I-Grebot/elec_microboard/doc/module_drv8843_pcb.PNG

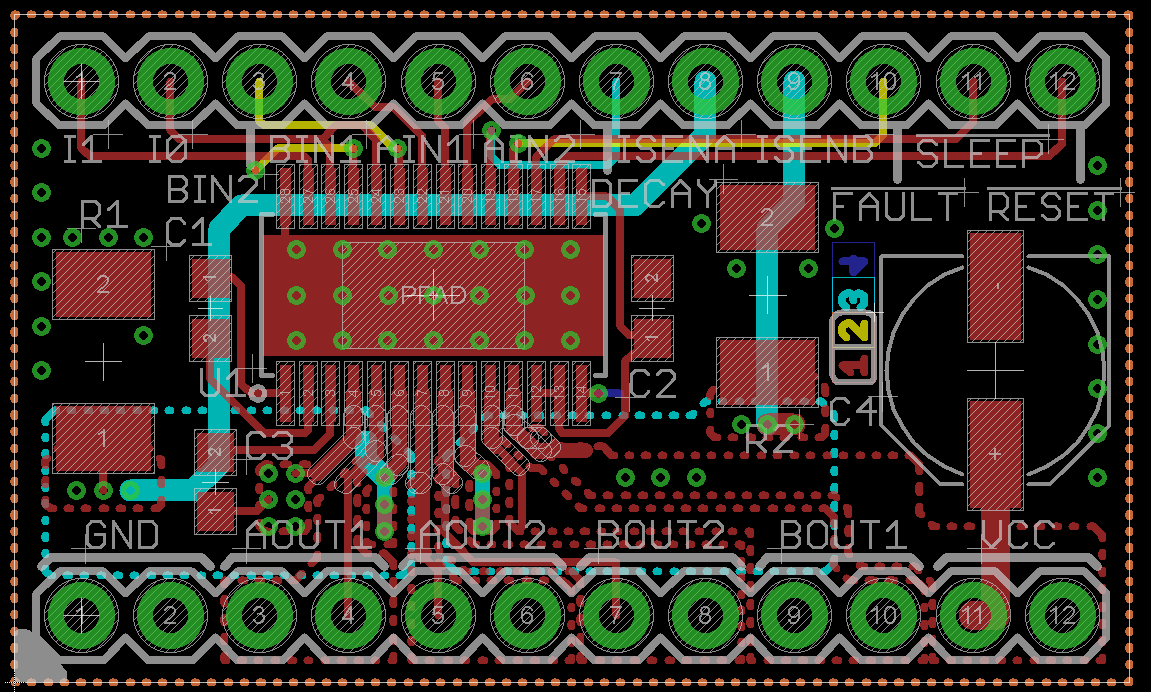
doc/module_drv8843_pcb.PNG
