I-Grebot/elec_microboard/doc/module_drv8843_schema.PNG

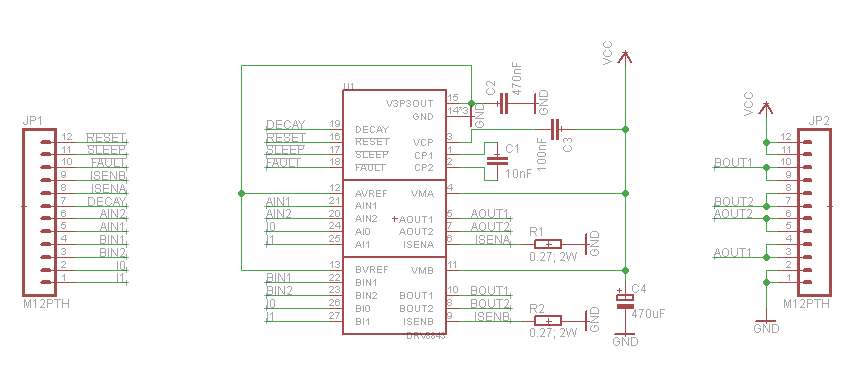
doc/module_drv8843_schema.PNG
