I-Grebot/elec_microboard/doc/power.png

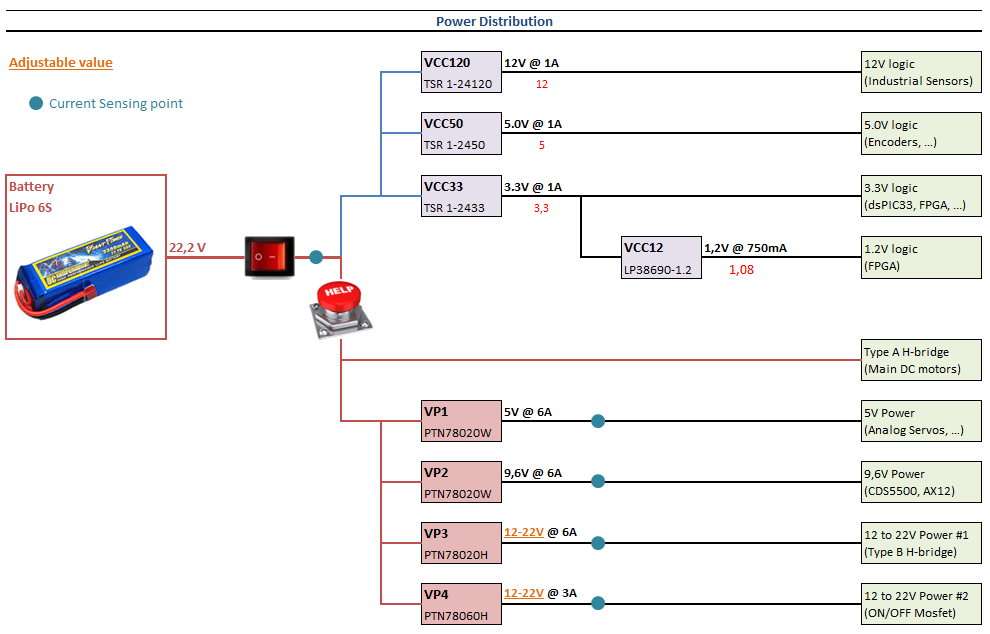
doc/power.png
