I-Grebot/elec_microboard/doc/power_pcb.PNG

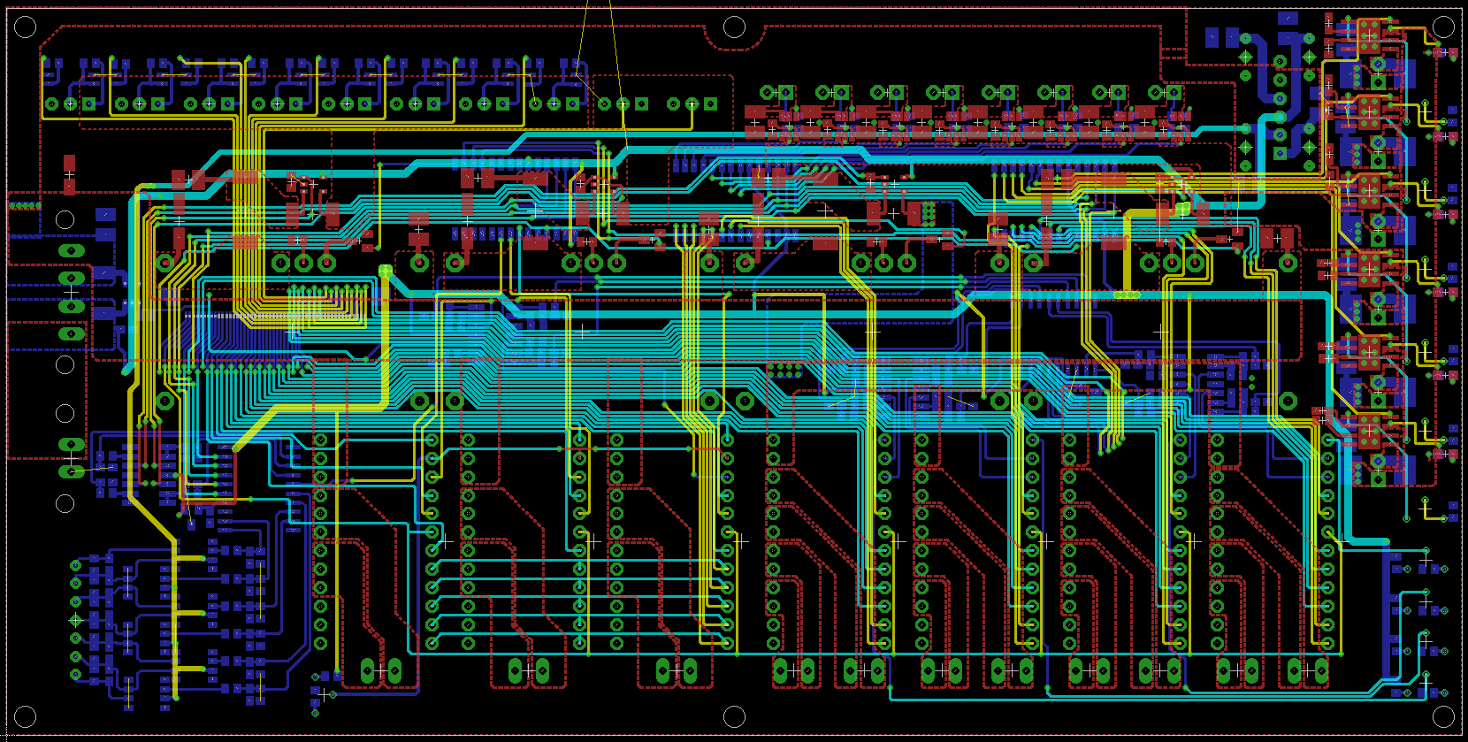
doc/power_pcb.PNG
