I-Grebot/elec_microboard/gerbers/microBoard_HMI/microBoard_HMI_back_side.png

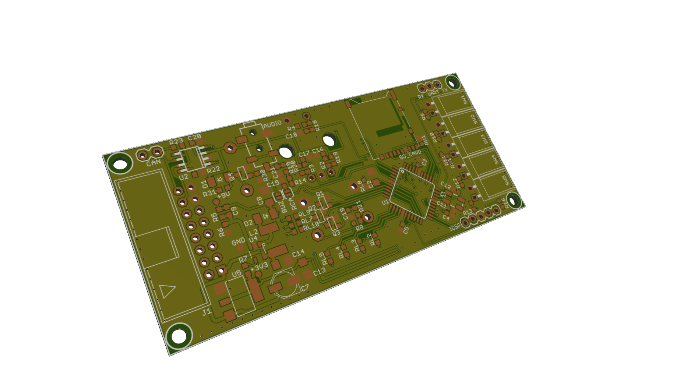
gerbers/microBoard_HMI/microBoard_HMI_back_side.png
