I-Grebot/elec_microboard/bom/microBoard_DRV8843.xlsx

Qty | Value | Device | Package | Parts | Description | Cmd
2 | 0.27; 2W | R-EU_R2010 | R2010 | R1, R2 | RESISTOR, European symbol | X
1 | 100nF | C-EUC0603 | C0603 | C3 | CAPACITOR, European symbol | X
1 | 10nF | C-EUC0603 | C0603 | C1 | CAPACITOR, European symbol | X
1 | 470nF | C-EUC0603 | C0603 | C2 | CAPACITOR, European symbol | X
1 | 470uF | CPOL-EUD | PANASONIC_D | C4 | POLARIZED CAPACITOR, European symbol | X
1 | DRV8843 | DRV8843 | PWP_28 | U1 |  | X
2 | M12PTH | M12PTH | 1X12 | JP1, JP2 | Header 12 | X
