I-Grebot/elec_microboard/bom/microBoard_HMI_bom.xls

microBoard_HMI |  |  |  |  |  |  | Last Update: | 2014-11-01
Bill Of Materials |  |  |  |  | Price for 1 board = 47,25€ |  | No. Boards | 2
Device | Value | Package | Part list | Count | Description | Farnell Ref. | Price (net) | Total (net)
C-EUC1206 | 4.7uF | C1206 | C1, C8 | 2 | CAPACITOR, European symbol | 2320886 | 0.17 € | 0.33 €
C-EUC1206 | 10uF | C1206 | C2, C13, C14 | 3 | CAPACITOR, European symbol | 2218910 | 0.27 € | 0.81 €
C-EUC0603 | 100nF | C0603 | C3, C4, C5, C6, C10, C20 | 6 | CAPACITOR, European symbol | 1759016 | 0.01 € | 0.04 €
CPOL-EUC | 10uF | PANASONIC_C | C7 | 1 | POLARIZED CAPACITOR, European symbol | 9697012 | 0.15 € | 0.15 € | Stock parts
C-EUC0603 | 10pF | C0603 | C9 | 1 | CAPACITOR, European symbol | 2332633 | 0.09 € | 0.09 € | Sample parts
C-EUC0603 | 18pF | C0603 | C11, C12 | 2 | CAPACITOR, European symbol | 1759056 | 0.01 € | 0.02 € | Not available
C-EUC0603 | 220nF | C0603 | C15 | 1 | CAPACITOR, European symbol | 2346897 | 0.04 € | 0.04 € | To buy
C-EUC0603 | 10nF | C0603 | C16, C17, C18, C19 | 4 | CAPACITOR, European symbol | 1759022 | 0.01 € | 0.03 €
C-EUC0603 | 22nF | C0603 | C21 | 1 | CAPACITOR, European symbol | 1759027 | 0.01 € | 0.01 €
CGRM4001-G | MBR0530 | SOD-123_MINI-SMA | D1, D2 | 2 | Molded plasitc,JEDEC SOD-123/Mini SMA | 1843690 | 0.06 € | 0.13 €
HE10_H_16 | HE10_H_16 | CON_2X_2.54_H_16 | J1 | 1 | HE-10 16 ways horizontal | 2215293 | 0.84 € | 0.84 €
M05LOCK |  | 1X05_LOCK | J5 | 1 | ICSP Connector |  | 0.00 € | 0.00 €
AUDIO-JACK1:1 |  | STEREOJACK2.5MM | J6 | 1 | 2.5mm Audio Jack |  | 0.00 € | 0.00 €
M03LOCK |  | 1X03_LOCK | J8 | 1 | UART Connector |  | 0.00 € | 0.00 €
JUMPER-2PTH_LOCK |  | 1X02_LOCK | JP3 | 1 | CAN Last node jumper |  | 0.00 € | 0.00 €
L-EUL5650M | 10uH | L5650M | L1 | 1 | INDUCTOR, European symbol | 2062754 | 0.75 € | 0.75 €
LEDCHIP-LED0805 |  | CHIP-LED0805 | LED6 | 1 | OLED on/off green LED | 2290331 | 0.10 € | 0.10 €
LEDCHIP-LED0805 |  | CHIP-LED0805 | LED1 | 1 | SD Card Yellow LED | 1686073 | 0.17 € | 0.17 €
LEDCHIP-LED0805 |  | CHIP-LED0805 | LED2, LED3 | 2 | 2x misc blue LEDs | 2217974 | 0.17 € | 0.33 €
LEDCHIP-LED0805 |  | CHIP-LED0805 | LED4, LED5 | 2 | 2x misc red LEDs | 2099241 | 0.11 € | 0.21 €
GM5WA94310A | YTB2-0BB02 | GM5WA94310A | LED7 | 1 | Chip LED RGB | 1863243 | 1.61 € | 1.61 €
EC11E1534408 | EC11E1534408 | EC11E1534408 | NAV1 | 1 | Rotary encoder with integrated SPST | 2064992 | 2.06 € | 2.06 €
TAC_SW_IP40 | TAC_SW_IP40 | TAC_SW_IP40 | NAV2 | 1 | SPST tactile switch | 1217754 | 1.41 € | 1.41 €
BSS138 | BSS138 | SOT23 | Q1, Q2, Q3, Q4 | 4 | Common NMOSFET Parts | 9845330 | 0.20 € | 0.79 €
R-EU_R0603 | 100 | R0603 | R14, R33, R34 | 3 | RESISTOR, European symbol | 2331713 | 0.01 € | 0.03 €
R-EU_R0603 | 120 | R0603 | R23 | 1 | RESISTOR, European symbol | 2331714 | 0.01 € | 0.01 €
R-EU_R0603 | 150 | R0603 | R17 | 1 | RESISTOR, European symbol | 2331715 | 0.01 € | 0.01 €
R-EU_R0603 | 270 | R0603 | R24, R26, R27, R28, R29, R32 | 6 | RESISTOR, European symbol | 2331719 | 0.01 € | 0.05 €
R-EU_R0603 | 1k | R0603 | R15, R31 | 2 | RESISTOR, European symbol | 2331727 | 0.01 € | 0.02 €
R-EU_R0603 | 4.7k | R0603 | R16 | 1 | RESISTOR, European symbol | 2331736 | 0.01 € | 0.01 €
R-EU_R0603 | 10k | R0603 | R2, R3, R4, R7, R8, R9, R10, R11, R12, R13, R18, R19, R20, R21, R22, R25 | 16 | RESISTOR, European symbol | 9238603 | 0.01 € | 0.10 €
R-EU_R0603 | 160k 1% | R0603 | R6 | 1 | RESISTOR, European symbol | 1627809 | 0.04 € | 0.04 €
R-EU_R0603 | 560k | R0603 | R1 | 1 | RESISTOR, European symbol | 2331763 | 0.01 € | 0.01 €
R-EU_R0603 | 1M 1% | R0603 | R5, R30 | 2 | RESISTOR, European symbol | 2332042 | 0.01 € | 0.02 €
DM3AT-SF-PEJM5 | DM3AT-SF-PEJM5 | DM3AT | SD_CARD | 1 | micro SD Card slot | 1764374 | 2.52 € | 2.52 €
F/EE17P | PKM17EPPH4001 | F/EE17P | SG1 | 1 | 17mm Sounder | 1192517 | 1.26 € | 1.26 €
HE14_H_2 | HE14_H_2 | HE14_H_2 | SW1, SW2, SW3, SW4, SW5 | 5 | 2 Ways HE-14 horizontal connector | 1360142 | 0.46 € | 2.29 €
DSPIC33EP512GM604 | DSPIC33EP512GM604 | TQFP_44 | U1 | 1 | dsPIC33EPXXXGM604 TQFP-44 Microcontroller | 2353895 | 0.00 € | 0.00 €
MCP2551 | SN65HVD230D | SO-08 | U2 | 1 | High-Speed CAN Transceiver | 1103105 | 0.00 € | 0.00 €
DD-12864WE-4A | DD-12864WE-4A | DD-12864WE-4A | U3 | 1 | Densitron 128x64 0.96" OLED Display | 1829709 | 21.64 € | 21.64 €
TPS61040 | TPS61040 | SOT-23 | U4 | 1 | Low power DC/DC Boost Converter | 1461061 | 0.00 € | 0.00 €
NX1117C | TLV1117-33 | SOT_223 | U5 | 1 | Standard 3.3V 800mA Low dropout linear regulator | 1202826 | 0.54 € | 0.54 €
CRYSTAL5X3 | 16MHz | CRYSTAL-SMD-5X3 | X1 | 1 | 4 Pads SMD 5 x 3.2 mm Crystal | 1841977 | 0.91 € | 0.91 €
 |  |  |  |  |  |  | Price per board (net) | 39.38 €
 |  |  |  |  |  |  | Price per board (+VAT) | 47.25 €
 |  |  |  |  |  |  | Grand Total | 94.50 €
