I-Grebot/elec_microboard/doc/architecture.xlsx

Sheet: Specifications
System specifications
 | Supplies & Power-managment
 |  | 24Vdc input, 6s LiPo cells
 |  | 2 power domains: logic (+ sensors) and actuators
 |  | Cells voltage monitoring
 |  | Current monitoring: global + 1 per power-supply ("power" domain)
 |  | Independant power supplies enable
 | Actuators
 |  | 11 Full H-bridges (3 main 5A, 8 auxilliary 3A)
 |  | 6 ON/OFF power mosfet 5A
 |  | 8 analog servos
 |  | Digital servos interface
 | Sensors
 |  | 20 NPN/PNP industrial sensors inputs
 |  | 8 Endstops inputs
 |  | 12 encoder interfaces
 | User Interface
 |  | Main ON/OFF switch
 |  | Emergency switch + feedback (switch "power" domain off)
 |  | Start switch (or interface)
 |  | Team selection switch
 |  | 1 extra switch (strategy selection or other)
 |  | 128x64 OLED display (monochrome)
 |  | Encoder for menu browsing + with push-button
 |  | RGB LED
 |  | micro SD card interface
 |  | 1 LED per power-domain
 |  | Piezo beeper

Sheet: Architecture
Battery
LiPo - 6S

Sheet: Power-supplies
Battery |  |  |  |  | Power Distribution
Number of elements | 6
Element voltage range | 3.3 | 3.7 | 4.2 |  | Adjustable value |  |  | VCC120 | 12V @ 1A |  |  | 12V logic (Industrial Sensors)
Battery voltage range | 19.8 | 22.2 | 25.2 |  |  |  |  | TSR 1-24120 | 12
 |  |  |  |  |  | Current Sensing point
 |  |  |  |  |  |  |  | VCC50 | 5.0V @ 1A |  |  | 5.0V logic (Encoders, …)
Power modules |  |  |  |  |  |  |  | TSR 1-2450 | 5
Name | Amps rating
PTN78000 | 1.5 |  |  |  | Battery |  |  | VCC33 | 3.3V @ 1A |  |  | 3.3V logic (dsPIC33, FPGA, ...)
PTN78060 | 3.0 |  |  |  | LiPo 6S |  |  | TSR 1-2433 | 3.3
PTN78020 | 6.0
 |  |  |  |  |  |  | 22,2 V |  |  | VCC12 | 1,2V @ 750mA | 1.2V logic (FPGA)
Suffix | Vin range |  | Vout range |  |  |  |  |  |  | LP38690-1.2 | 1.08
'H' | 15.0 | 36.0 | 11.8 | 22.0
'W' | 7.0 | 36.0 | 2.5 | 12.6
Traco modules | Amps rating |  | Vin range |  |  |  |  |  |  |  |  | Type A H-bridge (Main DC motors)
TSR 1-24XX | 1.0 |  | 12.0 | 36.0
LDOs |  |  |  |  |  |  |  | VP1 | 5V @ 6A |  |  | 5V Power (Analog Servos, …)
Name | Amps rating |  | Vin range |  |  |  |  | PTN78020W
LP38690-5/3.3 | 1.0 |  | 2.7 | 10.0
 |  |  |  |  |  |  |  | VP2 | 9,6V @ 6A |  |  | 9,6V Power (CDS5500, AX12)
 |  |  |  |  |  |  |  | PTN78020W
 |  |  |  |  |  |  |  | VP3 | 12-22V @ 6A |  |  | 12 to 22V Power #1 (Type B H-bridge)
 |  |  |  |  |  |  |  | PTN78020H
 |  |  |  |  |  |  |  | VP4 | 12-22V @ 3A |  |  | 12 to 22V Power #2 (ON/OFF Mosfet)
 |  |  |  |  |  |  |  | PTN78060H

Sheet: Devices
Device ID | Type | I/O Type | Count
1 | dsPIC33EP*MU814 | Input / Output | 122
2 | XC3S200A | Input only | 8
 |  | Input / Output | 53
3 | dsPIC33EP*GM604 | Input / Output | 35
Total available I/O |  |  | 218

Sheet: IO Resources
 |  |  |  | Required I/O |  | Mapping per device |  |  |  |  |  |  | Schematic Status
Resource | Count | Details | Peripheral per item | Per item | Total | µC Main |  | FPGA Main |  | µc HMI
Cells voltage monitoring | 6 | 1 ADC channel per LiPo cell | 1 ADC channel | 1 | 6 | 6 | 6 |  | 0 |  | 0 | 0
Current sensing | 6 | 1 ADC channel per shunt sensing | 1 ADC channel | 1 | 6 | 6 | 6 |  | 0 |  | 0 | 0
Power supply enable | 4 | 1 ENABLE output | 1 digital output | 1 | 4 | 4 | 4 |  | 0 |  | 0 | 0 | OK
Type A Full H-bridges | 3 | 1 PWM signal 1 DIR signal 1 DECAY signal 1 SLEEP signal 1 FAULT signal 1 SENSE Feedback | 1 PWM channel 4 digital outputs 1 ADC channel | 6 | 18 | 3 | 18 |  | 0 |  | 0 | 0 | OK
Type B Full H-bridges | 8 | 1 PWM signal 1 DIR signal 0,5 DECAY signal 0,5 SLEEP signal 0,5 FAULT signal 1 SENSE Feedback | 1 PWM channels 2.5 digital outputs 1 ADC channel | 4.5 | 36 | 4 | 18 | 4 | 18 |  | 0 | 0 | OK
Common for Full H-bridges | 1 | 1 RESET signal | 1 digital output | 1 | 1 | 1 | 1 |  | 0 |  | 0 | 0 | OK
ON/OFF power mosfets | 16 | 1 ENABLE signal | 1 digital output | 1 | 16 | 16 | 16 |  | 0 |  | 0 | 0 | OK
Analog servos | 8 | 1 PWM signal | 1 PWM channel | 1 | 8 |  | 0 | 8 | 8 |  | 0 | 0 | OK
Digital servos interface | 1 | 1 TX/RX signal 1 DIR signal | 1 UART input 1 UART output 1 digital output | 3 | 3 | 1 | 3 |  | 0 |  | 0 | 0
NPN/PNP Industrial sensors | 20 | 1 input signal | 1 digital input | 1 | 20 | 20 | 20 |  | 0 |  | 0 | 0
Endstops | 8 | 1 input signal | 1 digital input | 1 | 8 | 8 | 8 |  | 0 |  | 0 | 0
Encoders interface | 12 | 1 'A' channel 1 'B' channel 1 '0' channel | 1 QEI channel | 3 | 36 | 2 | 6 | 10 | 30 |  | 0 | 0
Emergency switch feedback | 1 | 1 input signal | 1 digital input | 1 | 1 |  | 0 |  | 0 | 1 | 1 | 0
Team selection switch | 1 | 1 input signal | 1 digital input | 1 | 1 |  | 0 |  | 0 | 1 | 1 | 0
Start switch or interface | 1 | 1 input signal | 1 digital input | 1 | 1 |  | 0 |  | 0 | 1 | 1 | 0
Spare switch (strategy) | 1 | 1 input signal | 1 digital input | 1 | 1 |  | 0 |  | 0 | 1 | 1 | 0
OLED Display | 1 | 1 CS signal 1 RESET signal 1 D/C signal 1 R/W signal 1 E/RD signal 8 D signals | 1 PMP interface 1 digital output | 13 | 13 |  | 0 |  | 0 | 1 | 13 | 0
OLED Intensity adjustment | 1 | 1 CS signal 1 MOSI signal 1 SCK signal | 1 SPI interface* 1 digital output | 3 | 3 |  | 0 |  | 0 | 1 | 3 | 0
Encoder for menu + Push button | 1 | 1 'A' channel 1 'B' channel 1 push-button input | 3 digital inputs | 3 | 3 |  | 0 |  | 0 | 1 | 3 | 0
RGB LED | 1 | 1 PWM output for Red intensity 1 PWM output for Green intensity 1 PWM output for Blue intensity | 3 PWM channels | 3 | 3 |  | 0 |  | 0 | 1 | 3 | 0
Micro SD interface | 1 | 1 SCK signal 1 MISO signal 1 MOSI signal 1 CS signal | 1 SPI interface* 1 digital output | 4 | 4 |  | 0 |  | 0 | 1 | 4 | 0
Piezo beeper | 1 | 1 PWM signal | 1 PWM channel | 1 | 1 |  | 0 |  | 0 | 1 | 1 | 0
Inter-uc / FPGA communication | 3 | 1 SCK signal 1 MISO signal 1 MOSI signal 1 CS signal | 1 SPI interface* 1 digital output | 4 | 12 | 1 | 4 | 1 | 4 | 1 | 4
Total |  |  |  |  | 193 |  | 110 |  | 60 |  | 35
Available |  |  |  |  | 218 |  | 122 |  | 61 |  | 35
* If multiple slave SPI devices are present, the 3 I/O from the SPI interface can be saved
(only the CS pins need to be duplicated)

Sheet: Components
 |  | Mémo
 |  | Potar numérique pour réglage DECAY moteurs, tension d'alim, brightness OLED
 |  | testpads
 |  | support pour les PTN pour pouvoir en changer
 |  | decouplage un peu partout
OLED 128x64 blanc | http://fr.farnell.com/densitron/dd-12864we-4a/pmoled-128-64-blanc/dp/1829709 | LEDs pour indicateur on/off mosfet et solenoids
Connecteur puiss x2 | http://fr.farnell.com/phoenix-contact/mc-1-5-2-gf-3-81-lr/embase-8a-160v-2-3-81mm-vert/dp/2393507
x4 | http://fr.farnell.com/phoenix-contact/mc-1-5-4-gf-3-81-lr/embase-8a-160v-4-3-81mm-vert/dp/2393509
x3 | http://fr.farnell.com/phoenix-contact/mc-1-5-3-gf-3-81-lr/embase-8a-160v-3-3-81mm-vert/dp/2393508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
x2 sans maintient | http://fr.farnell.com/phoenix-contact/mc-1-5-2-g-3-81/embase-male-90deg-ci-2v-3-81mm/dp/3704725
HE13 3V coudé servos | http://fr.farnell.com/te-connectivity-amp/281698-3/embase-trav-coudee-2-54mm-1-x-3/dp/1205991
boitier | http://fr.farnell.com/te-connectivity-amp/281786-3/boitier-femelle-he14-3v/dp/429442
Cable FFC | http://fr.farnell.com/molex/98266-0545/cable-plat-ffc-50-voies-152mm/dp/1519836
Connecteur FFC 50v | http://fr.farnell.com/molex/54104-5096/embase-ffc-fpc-0-5mm-50-voies/dp/2063792
HE14-6 coudée | http://fr.farnell.com/te-connectivity-amp/281698-6/embase-trav-coudee-2-54mm-1-x-6/dp/1205994
 | http://fr.farnell.com/te-connectivity-amp/281786-6/boitier-femelle-he14-6v/dp/429478?MER=en-me-pd-r2-acce-con
Molex KK coudée 2.54 | http://fr.farnell.com/molex/22-05-7028/barrette-male-kk-coudee-2-54mm/dp/9731601?Ntt=molex+22-05-7028
22-05-7028
R shunt 270 mOhm 2W | http://fr.farnell.com/panasonic/erjb1bfr27u/resistance-terminaisons-large-0r27/dp/2294031
R shunt 5mOhm 2W | http://fr.farnell.com/bourns/cre2512-fz-r005e-2/resist-mesu-courant-0-005-ohm-2w/dp/2434005
TPS61040 | http://fr.farnell.com/texas-instruments/tps61040dbvr/convertisseur-boost-cms-sot-23/dp/1461061
schottky mbr0530 | http://fr.farnell.com/diodes-inc/b0530w-7-f/diodeschottky30v0-5asod123/dp/1843690?whydiditmatch=rel_1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
inductance 10uH | http://fr.farnell.com/murata-power-solutions/23s100c/inductor-smd-10uh-1-18a/dp/2062754RL
RGB led | http://fr.farnell.com/avago-technologies/asmt-ytb2-0bb02/led-plcc6-rgb-745-1600-380mcd/dp/1863243
bouton poussoir | http://fr.farnell.com/schurter/1241-1602/bouton-poussoir-court-cms-ip40/dp/1217754
Bouton poussoir tactile | http://fr.farnell.com/jsp/search/productdetail.jsp?SKU=1440976&MER=BN-1440976
Codeur incremental | http://fr.farnell.com/alps/ec11e1534408/encoder-vertical-11mm-0det-15ppr/dp/2064992
Knob | http://fr.farnell.com/mentor/505-613/bouton-alum-setscrew/dp/1282553
bss138 | http://fr.farnell.com/fairchild-semiconductor/bss138/transistor-mosfet-n-sot-23/dp/9845330RL
Pas pour les cartes mais panel HMI:
Strat/Couleur switch | http://fr.farnell.com/marquardt/1551-3102/interrupteur-a-manette-basculante/dp/1831103
ON/OFF switch | http://fr.farnell.com/marquardt/1835-3112/interrupteur-manette-basculante/dp/1831114
ARU | http://fr.farnell.com/multicomp/mcada16e6-r22-d10r/bouton-arret-d-urgence-spst-no/dp/2432131
piezzo buzzer | http://fr.farnell.com/murata/pkm17epph4001-b0/sonnerie-piezo/dp/1192517?ref=lookahead
reg 3V3 sot223 | http://fr.farnell.com/jsp/search/productdetail.jsp?SKU=1202826&MER=BN-1202826
Flash SPI 32 Mbits | http://fr.farnell.com/jsp/search/productdetail.jsp?SKU=1829955&MER=BN-1829955 | 1829955 | 2.23
optocoupler 2 led | http://fr.farnell.com/everlight/el3h4-ta-vg/optocoupleur-tr-o-p-sop-4/dp/1852698 | 1852698 | 0.229
led bicolore rouge/vert | http://fr.farnell.com/lumex/sml-lx1210igc-tr/led-red-green-2-7mm-x-2mm/dp/2062277 | 2062277 | 0.113
RN171 | http://fr.farnell.com/microchip/rn171-i-rm/module-wlan-wifly-gsx-ext-ant/dp/2144008
Hirose UFL | http://fr.farnell.com/hirose-hrs/u-fl-r-smt-01/embase-cms-u-fl/dp/3908021?ref=lookahead

Sheet: Power-supplies - old
Battery |  |  |  |  | Power Distribution
Number of elements | 6
Element voltage range | 3.3 | 3.7 | 4.2 |  | Adjustable value |  |  |  | VCC5 | 5V @ 750mA | System: PIC, Raspi, peripherals, simple sensors, etc.
Battery voltage range | 19.8 | 22.2 | 25.2 |  |  |  |  |  | LP38690-5 | 4.5
 |  |  |  |  |  |  | VL1 | 7V @ 1.5A | VCC33 | 3,3V @ 750mA
Power modules |  |  |  |  |  |  | PTN78000W | 10.5 | LP38690-3.3 | 2.97
Name | Amps rating
PTN78000 | 1.5 |  |  |  | Battery |  | VL2 | 2,5-12V @ 1.5A |  |  | Industrial sensors: Higher voltages requirements, higher currents
PTN78060 | 3.0 |  |  |  | LiPo 6S |  | PTN78000W
PTN78020 | 6.0
 |  |  |  |  |  | 22,2 V | VL3 | 12-22V @ 1.5A
Suffix | Vin range |  | Vout range |  |  |  | PTN78000H
'H' | 15.0 | 36.0 | 11.8 | 22.0
'W' | 7.0 | 36.0 | 2.5 | 12.6
LDOs |  |  |  |  |  |  | VP1 | 5V @ 6A |  |  | Analog servos, other 5V power
Name | Amps rating |  | Vin range |  |  |  | PTN78020W
LP38690-5/3.3 | 1.0 |  | 2.7 | 10.0
 |  |  |  |  |  |  | VP2 | 9,6V @ 6A |  |  | AX12 / CDS55XX digital servos
 |  |  |  |  |  |  | PTN78020W
TSR 1-24XX |  |  |  |  |  |  | VP3 | 2,5-12V @ 3A |  |  | Other power requirements: DC motors, pumps, etc.
 |  |  |  |  |  |  | PTN78060W
 |  |  |  |  |  |  | VP4 | 12-22V @ 3A
 |  |  |  |  |  |  | PTN78060H
 |  |  |  |  |  |  |  |  |  |  | Main DC motors
