I-Grebot/elec_microboard/pdf/microBoard_HMI_schematics.pdf

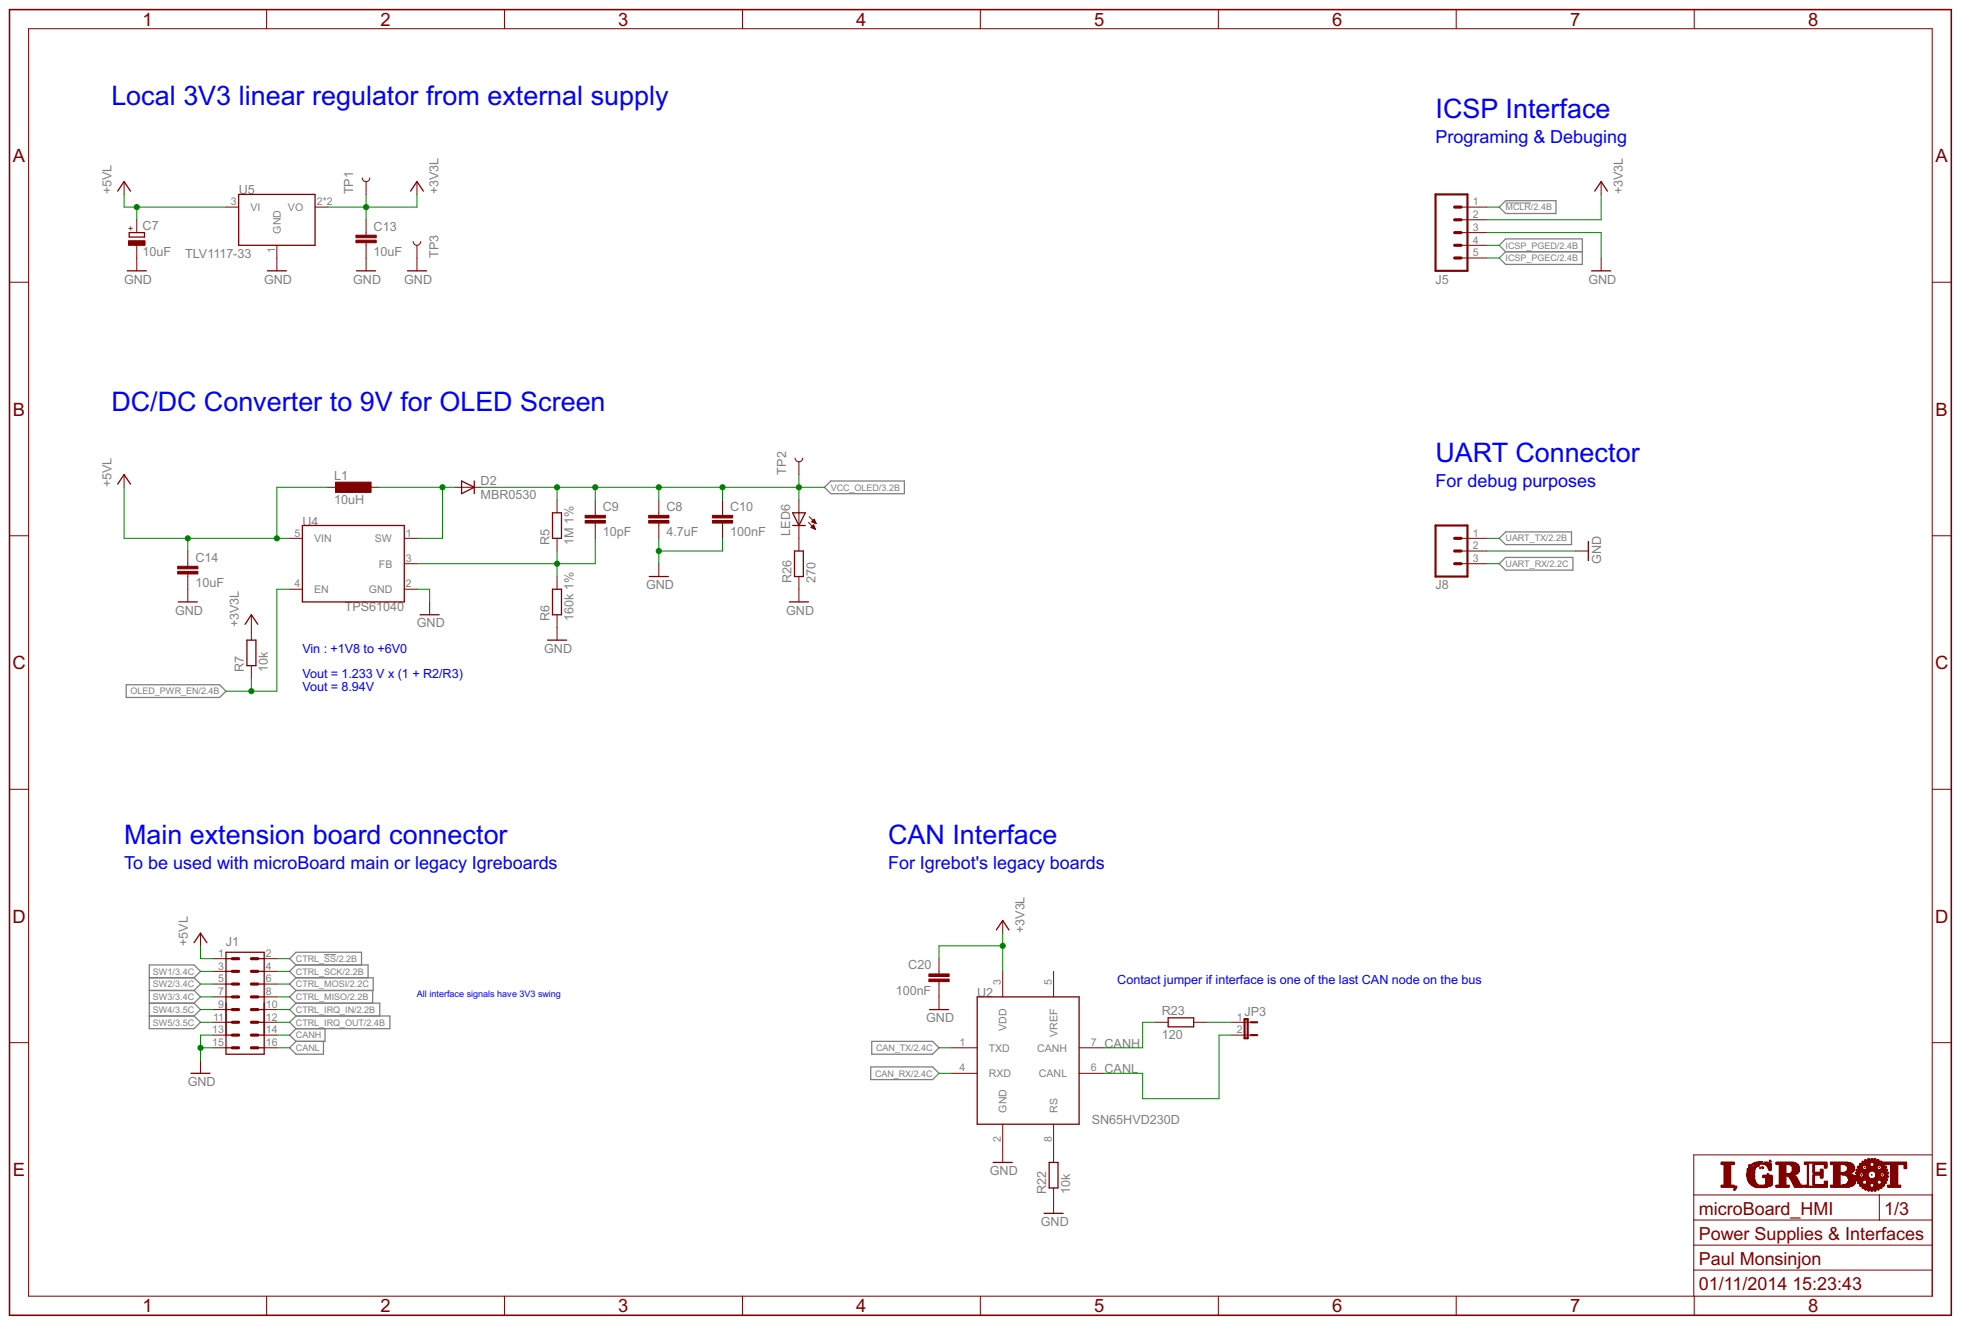
[picture p7: page 1]

Local 3V3 linear regulator from external supply

DC/DC Converter to 9V for OLED Screen

For debug purposes UART Connector

Vin : +1V8 to +6V0 Vout = 1.233 V x (1 + R2/R3) Vout = 8.94V

To be used with microBoard main or legacy Igreboards Main extension board connector

For Igrebot's legacy boards CAN Interface

SW1/3.4C 5 | CTRL_SS/2.2B CTRL_SCK/2.2B CTRL_MOSI/2.2C

All interface signals have 3V3 swing

Contact jumper if interface is one of the last CAN node on the bus

microBoard_HMI
Power Supplies & Interfaces Paul Monsinjon

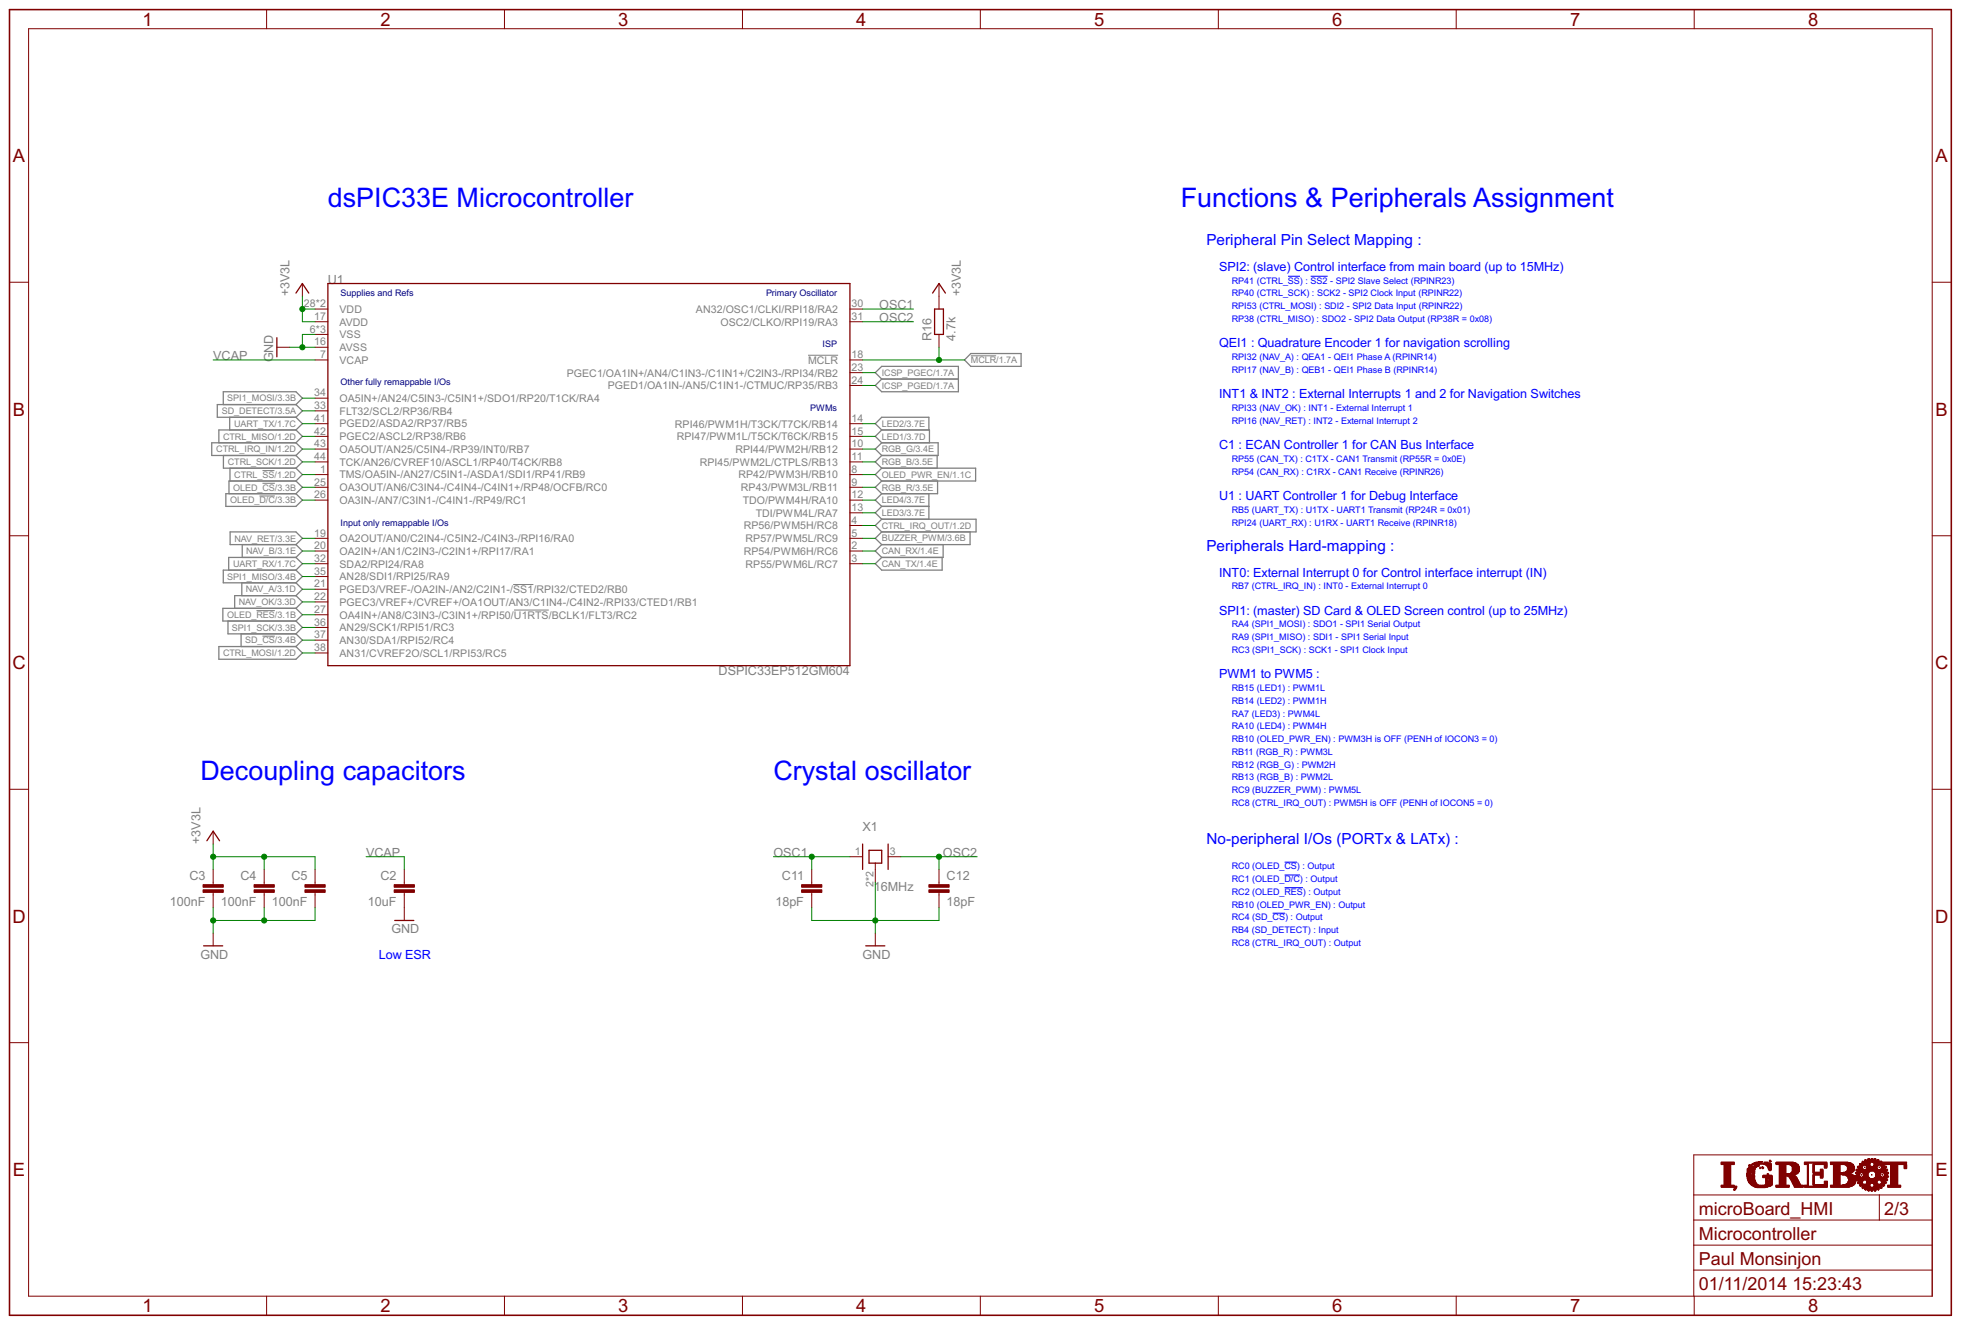
[picture p8: page 2]

Peripheral Pin Select Mapping :

SPI2: (slave) Control interface from main board (up to 15MHz)
RPI53 (CTRL_MOSI) : SDI2 - SPI2 Data Input (RPINR22) RP38 (CTRL_MISO) : SDO2 - SPI2 Data Output (RP38R = 0x08) RP40 (CTRL_SCK) : SCK2 - SPI2 Clock Input (RPINR22) RP41 (CTRL_SS) : SS2 - SPI2 Slave Select (RPINR23)

INT1 & INT2 : External Interrupts 1 and 2 for Navigation Switches QEI1 : Quadrature Encoder 1 for navigation scrolling C1 : ECAN Controller 1 for CAN Bus Interface U1 : UART Controller 1 for Debug Interface
RPI32 (NAV_A) : QEA1 - QEI1 Phase A (RPINR14) RPI33 (NAV_OK) : INT1 - External Interrupt 1
RPI16 (NAV_RET) : INT2 - External Interrupt 2 RPI17 (NAV_B) : QEB1 - QEI1 Phase B (RPINR14)

RPI24 (UART_RX) : U1RX - UART1 Receive (RPINR18) Peripherals Hard-mapping :

INT0: External Interrupt 0 for Control interface interrupt (IN) DSPIC33EP512GM604

RA4 (SPI1_MOSI) : SDO1 - SPI1 Serial Output RA9 (SPI1_MISO) : SDI1 - SPI1 Serial Input RC3 (SPI1_SCK) : SCK1 - SPI1 Clock Input PWM1 to PWM5 : SPI1: (master) SD Card & OLED Screen control (up to 25MHz)

RB10 (OLED_PWR_EN) : PWM3H is OFF (PENH of IOCON3 = 0)
RB11 (RGB_R) : PWM3L RB12 (RGB_G) : PWM2H

RB13 (RGB_B) : PWM2L RC9 (BUZZER_PWM) : PWM5L RC8 (CTRL_IRQ_OUT) : PWM5H is OFF (PENH of IOCON5 = 0)

RC0 (OLED_CS) : Output No-peripheral I/Os (PORTx & LATx) : RC1 (OLED_D/C) : Output

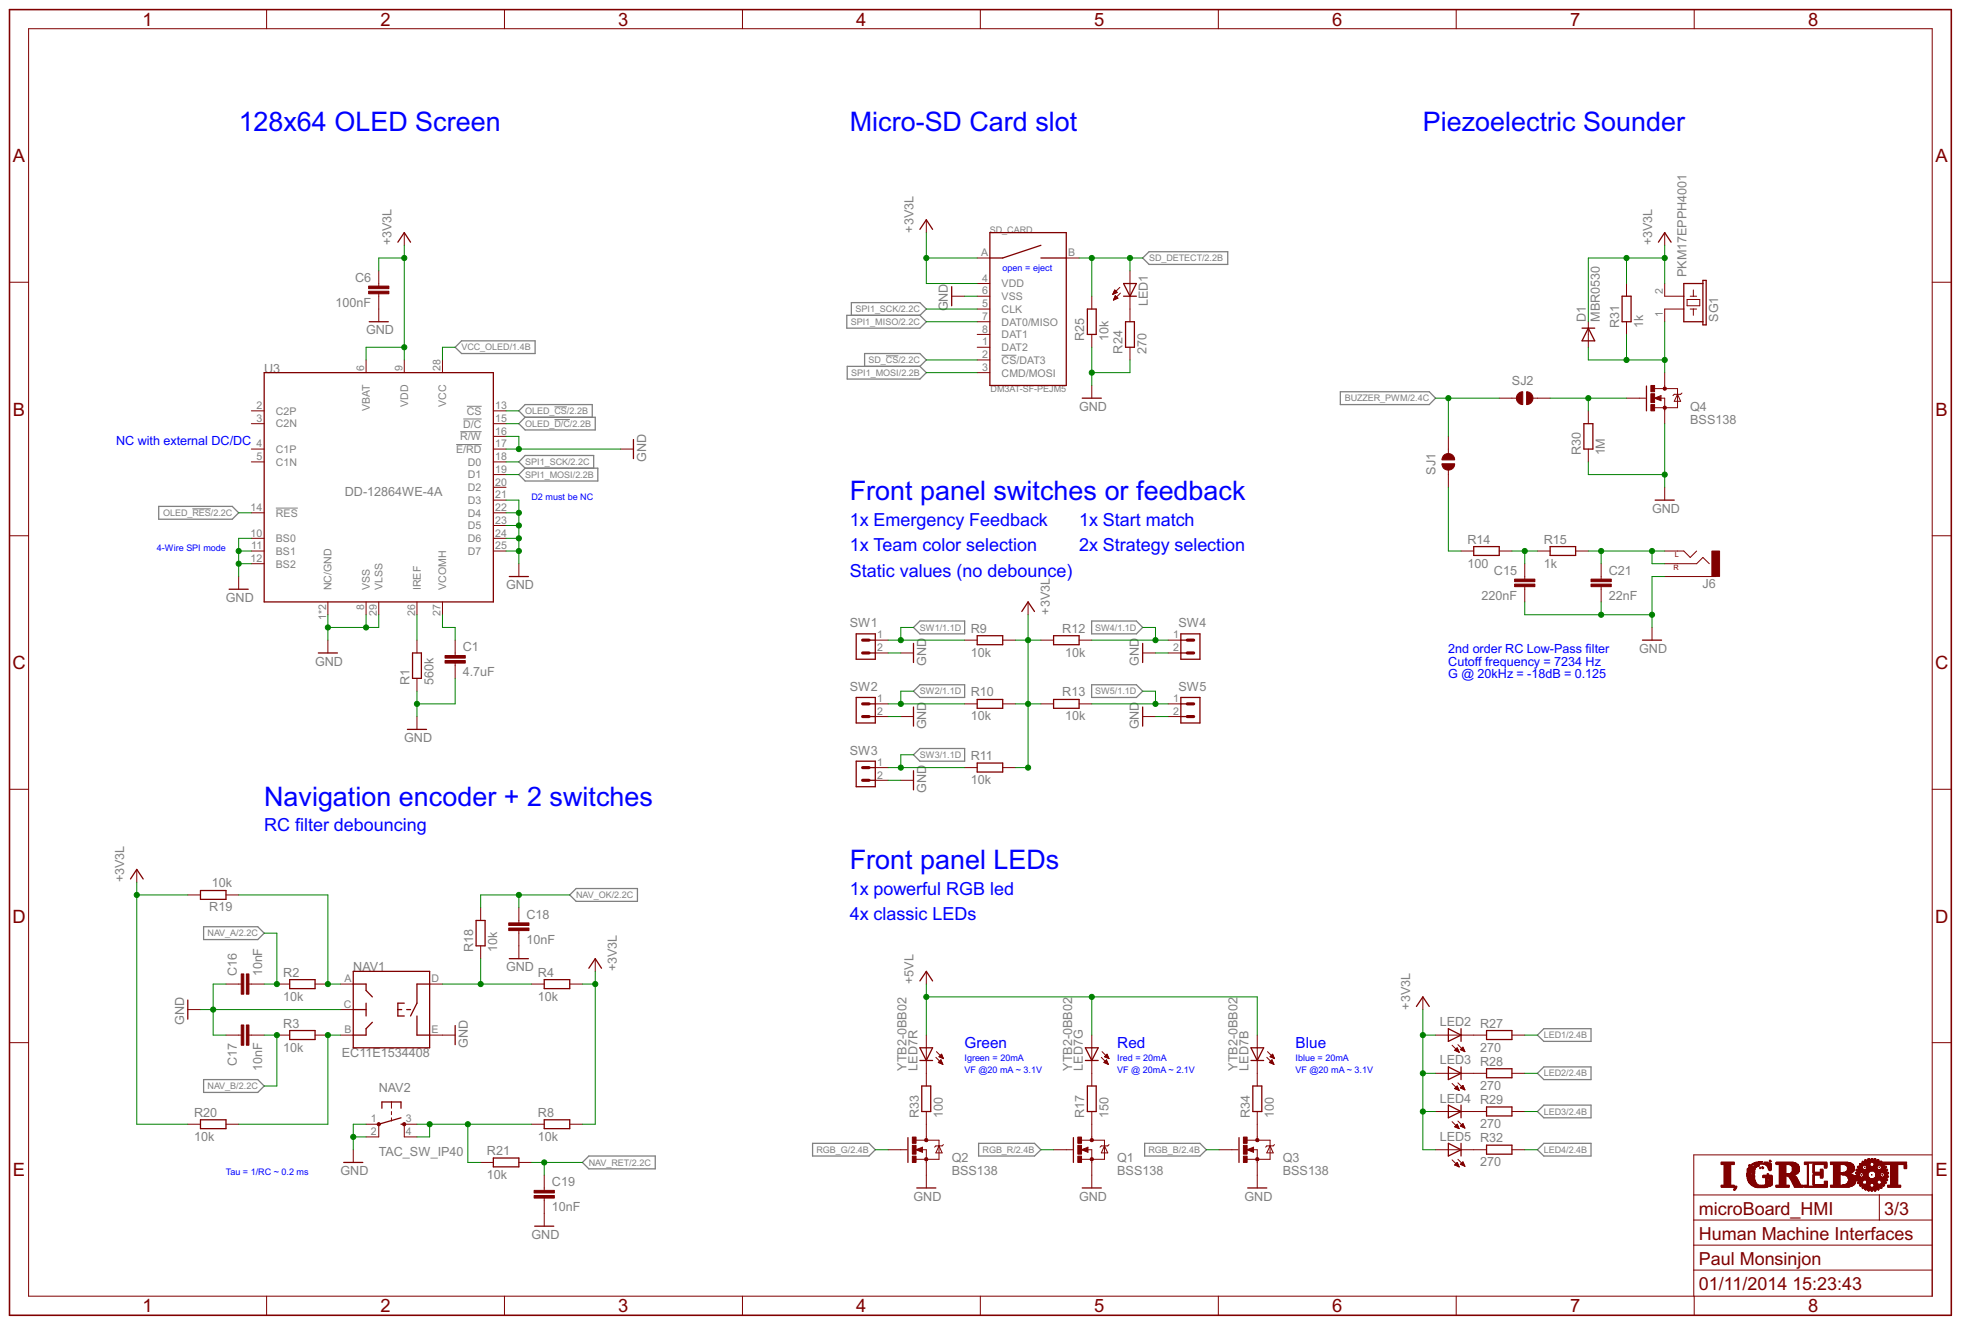
[picture p9: page 3]

Micro-SD Card slot

Front panel switches or feedback

microBoard_HMI
Human Machine Interfaces Paul Monsinjon
