I-Grebot/elec_microboard/pdf/microBoard_HMI_mechanics_scale_4-1.pdf

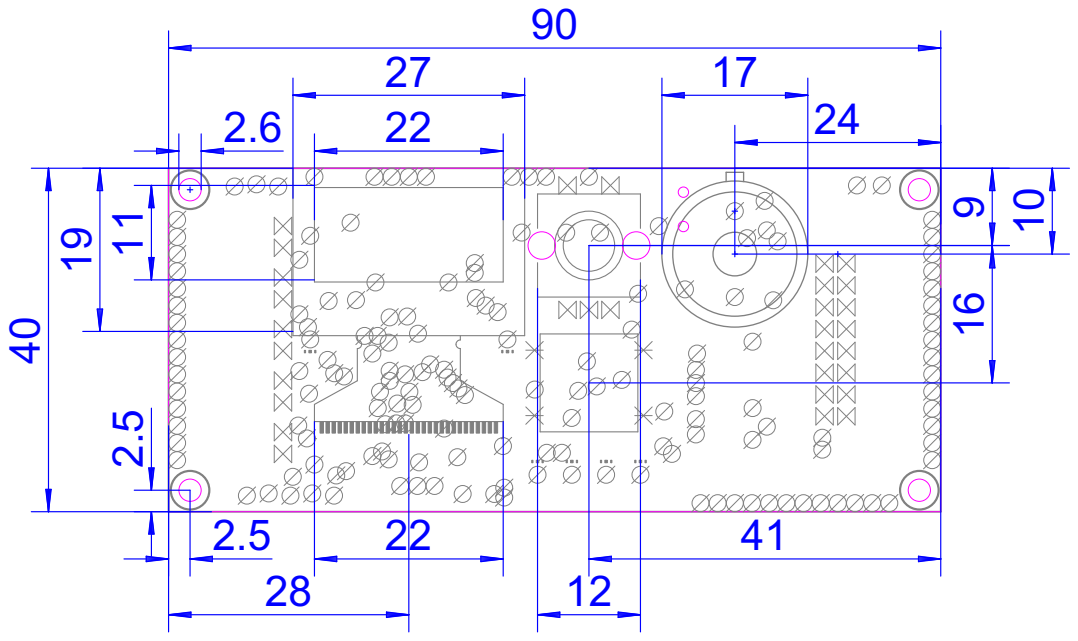
[picture p10: page 1]
