I-Grebot/elec_microboard/pdf/microBoard_HMI_copper_bot.pdf

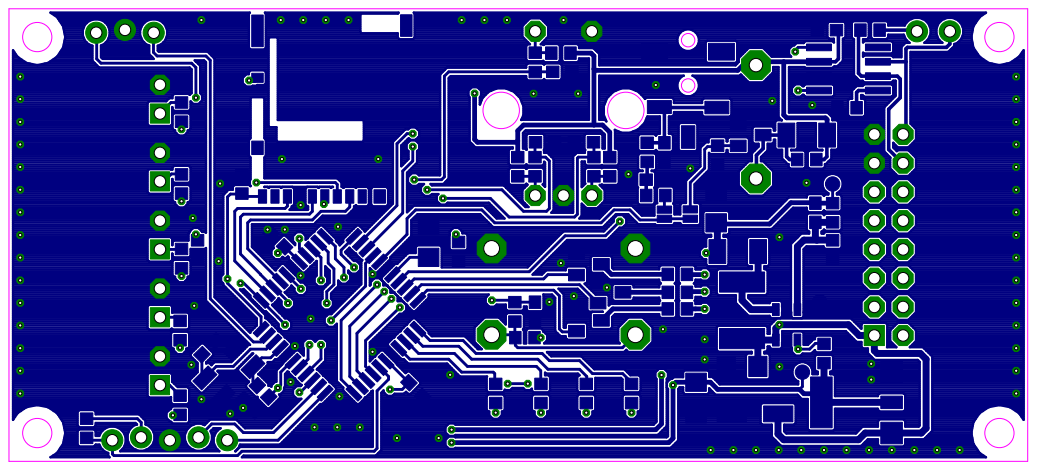
[picture p11: page 1]
