I-Grebot/elec_microboard/pdf/microBoard_HMI_copper_top.pdf

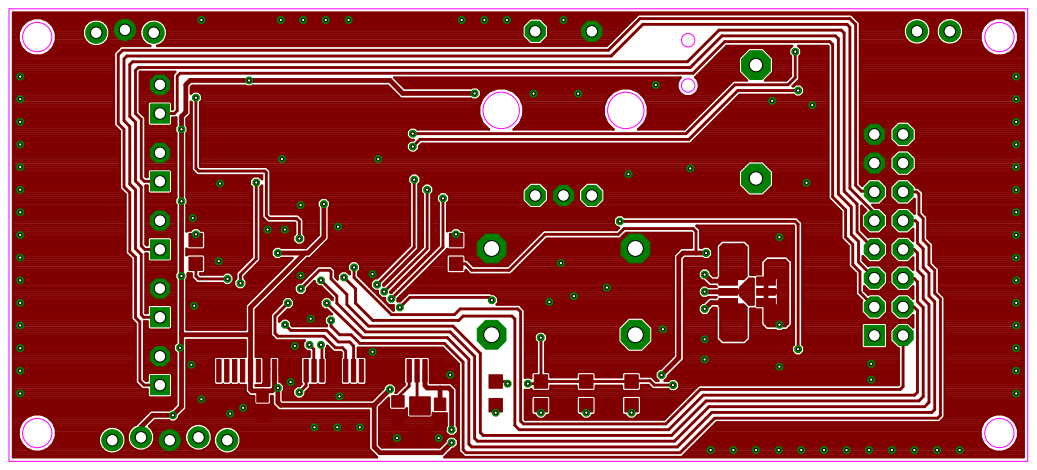
[picture p12: page 1]
