I-Grebot/elec_microboard/pdf/microBoard_HMI_silkscreen_bot.pdf

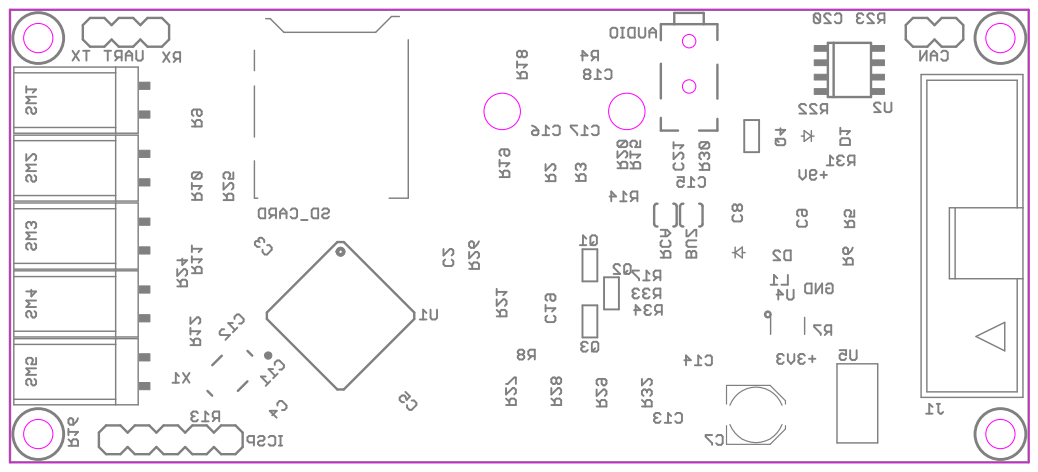
[picture p13: page 1]
