I-Grebot/elec_microboard/pdf/microBoard_HMI_silkscreen_top.pdf

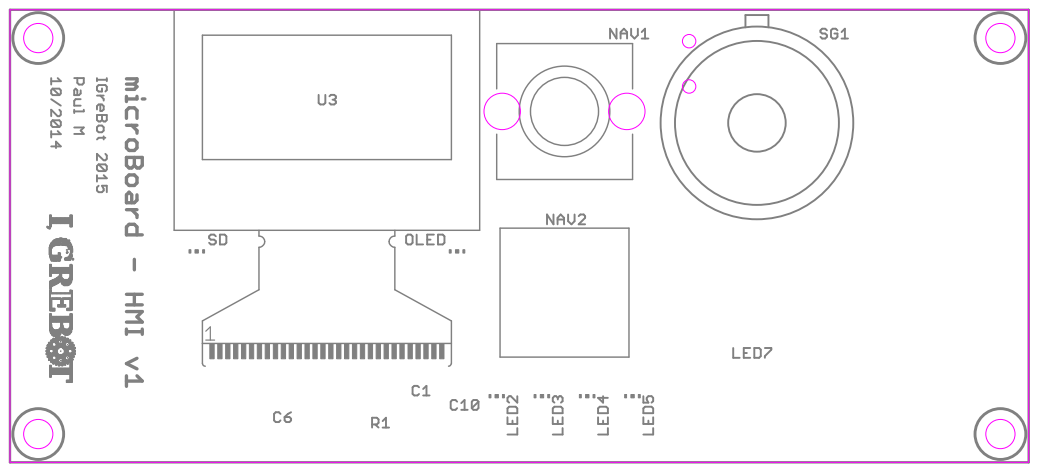
[picture p14: page 1]
