I-Grebot/elec_microboard/src/User Interface/microBoard_HMI.brd

## EAGLE design src/User Interface/microBoard_HMI.brd (2016-11-11)

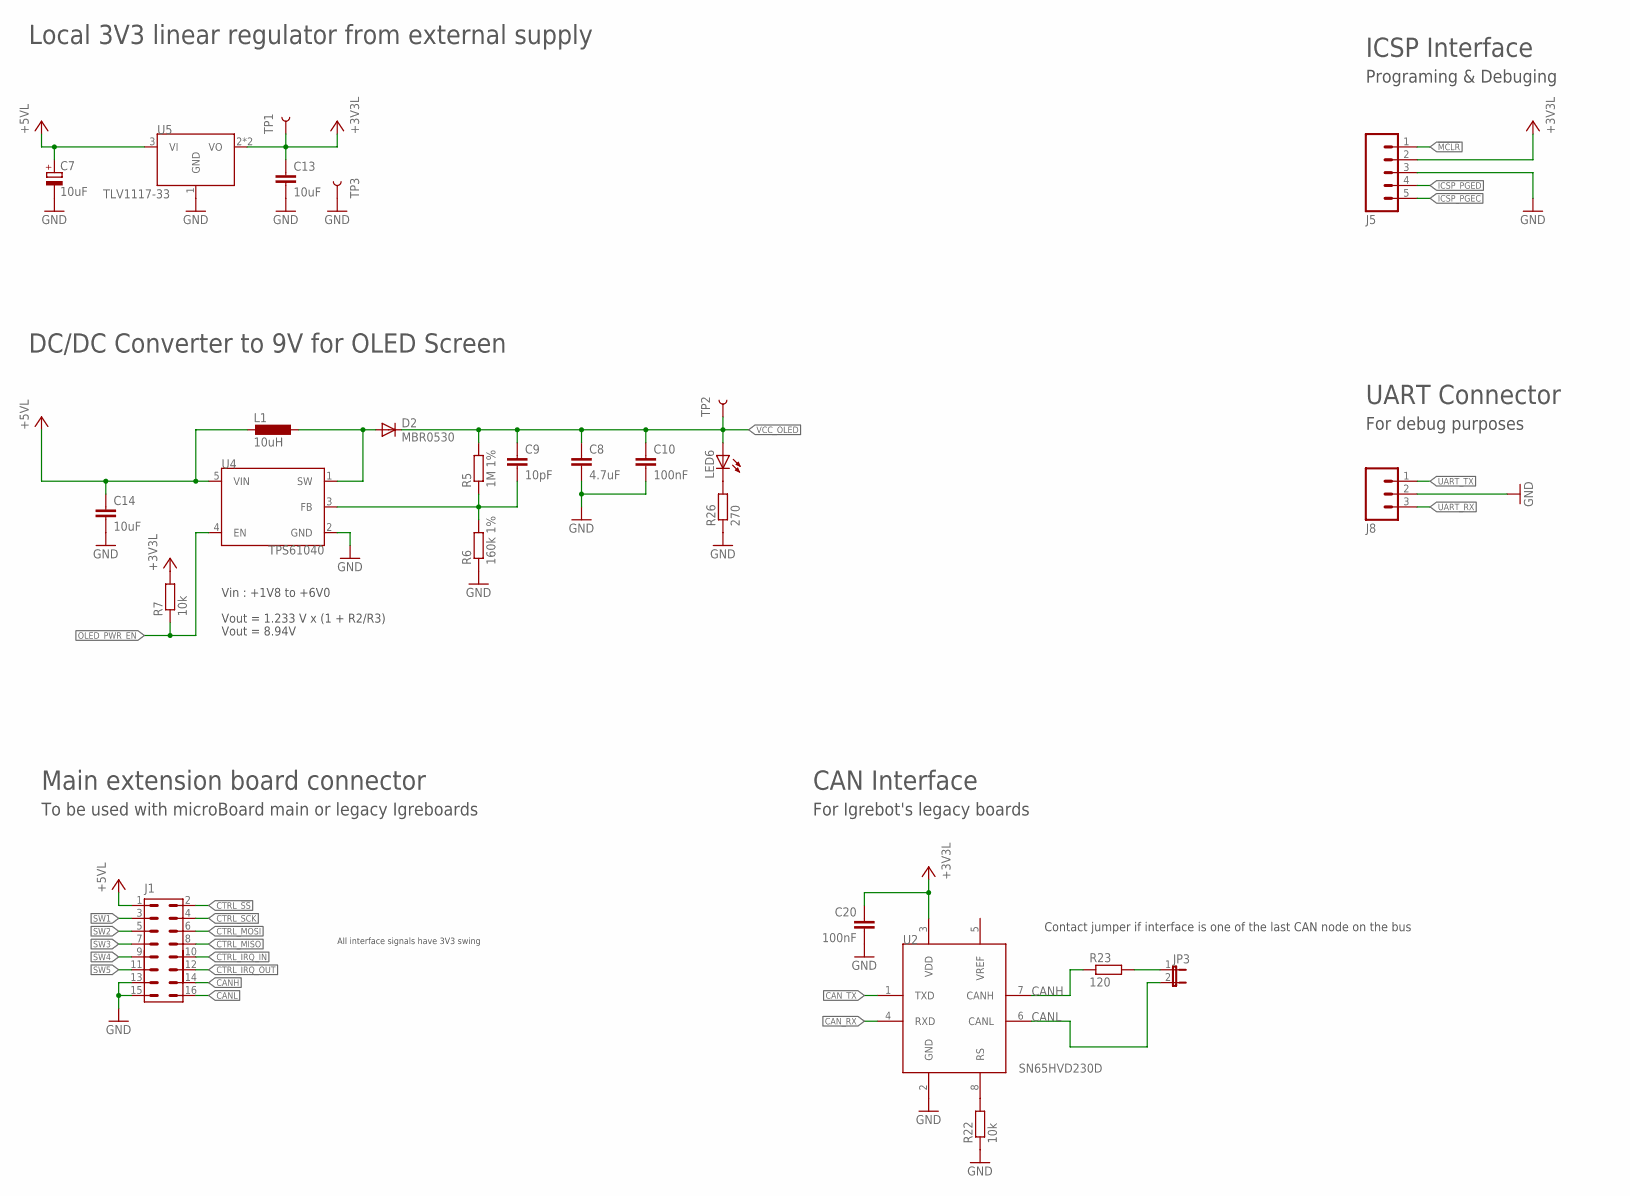
[picture p15: schematic microBoard_HMI.sch, sheet 1, Power Supplies & Interfaces]

Parts:
C7: 10uF; PANASONIC_C
C8: 4.7uF; C1206
C9: 10pF; C0603
C10, C20: 100nF; C0603
C13, C14: 10uF; C1206
D2: MBR0530; SOD-123_MINI-SMA
J1: HE10_H_16; CON_2X_2.54_H_16
J5: M05LOCK; 1X05_LOCK
J8: M03LOCK; 1X03_LOCK
JP3: JUMPER-2PTH_LOCK; 1X02_LOCK
L1: 10uH; L5650M
LED6: LEDCHIP-LED0805; CHIP-LED0805
R5: 1M 1%; R0603
R6: 160k 1%; R0603
R7, R22: 10k; R0603
R23: 120; R0603
R26: 270; R0603
TP1, TP2, TP3: TEST-POINT3X5; PAD.03X.05
U2: SN65HVD230D; SO-08
U4: TPS61040; SOT-23
U5: TLV1117-33; SOT_223

Connections:
!MCLR!: J5.1; also elsewhere on the board
+3V3L: C13.1, C20.1, J5.2, R7.2, TP1.P$1, U2.3 (VDD), U5.2 (VO), U5.4 (VO); also elsewhere on the board
+5VL: C7.+, C14.1, J1.1, L1.2, U4.5 (VIN), U5.3 (VI); also elsewhere on the board
CANH: J1.14, R23.1, U2.7 (CANH)
CANL: J1.16, JP3.2, U2.6 (CANL)
CAN_RX: U2.4 (RXD); also elsewhere on the board
CAN_TX: U2.1 (TXD); also elsewhere on the board
CTRL_!SS!: J1.2; also elsewhere on the board
CTRL_IRQ_IN: J1.10; also elsewhere on the board
CTRL_IRQ_OUT: J1.12; also elsewhere on the board
CTRL_MISO: J1.8; also elsewhere on the board
CTRL_MOSI: J1.6; also elsewhere on the board
CTRL_SCK: J1.4; also elsewhere on the board
GND: C7.-, C8.2, C10.2, C13.2, C14.2, C20.2, J1.13, J1.15, J5.3, J8.2, R6.1, R22.1, R26.1, TP3.P$1, U2.2 (GND), U4.2 (GND), U5.1 (GND); also elsewhere on the board
ICSP_PGEC: J5.5; also elsewhere on the board
ICSP_PGED: J5.4; also elsewhere on the board
unnamed: D2.A, L1.1, U4.1 (SW)
unnamed: C9.2, R5.1, R6.2, U4.3 (FB)
unnamed: LED6.C, R26.2
unnamed: JP3.1, R23.2
unnamed: R22.2, U2.8 (RS)
OLED_PWR_EN: R7.1, U4.4 (EN); also elsewhere on the board
SW1: J1.3; also elsewhere on the board
SW2: J1.5; also elsewhere on the board
SW3: J1.7; also elsewhere on the board
SW4: J1.9; also elsewhere on the board
SW5: J1.11; also elsewhere on the board
UART_RX: J8.3; also elsewhere on the board
UART_TX: J8.1; also elsewhere on the board
VCC_OLED: C8.1, C9.1, C10.1, D2.C, LED6.A, R5.2, TP2.P$1; also elsewhere on the board

Notes on the sheet:
Vin : +1V8 to +6V0
Vout = 1.233 V x (1 + R2/R3)
Vout = 8.94V
Local 3V3 linear regulator from external supply
DC/DC Converter to 9V for OLED Screen
To be used with microBoard main or legacy Igreboards
Main extension board connector
Programing & Debuging
ICSP Interface
All interface signals have 3V3 swing
For debug purposes
UART Connector
For Igrebot's legacy boards
CAN Interface
Contact jumper if interface is one of the last CAN node on the bus

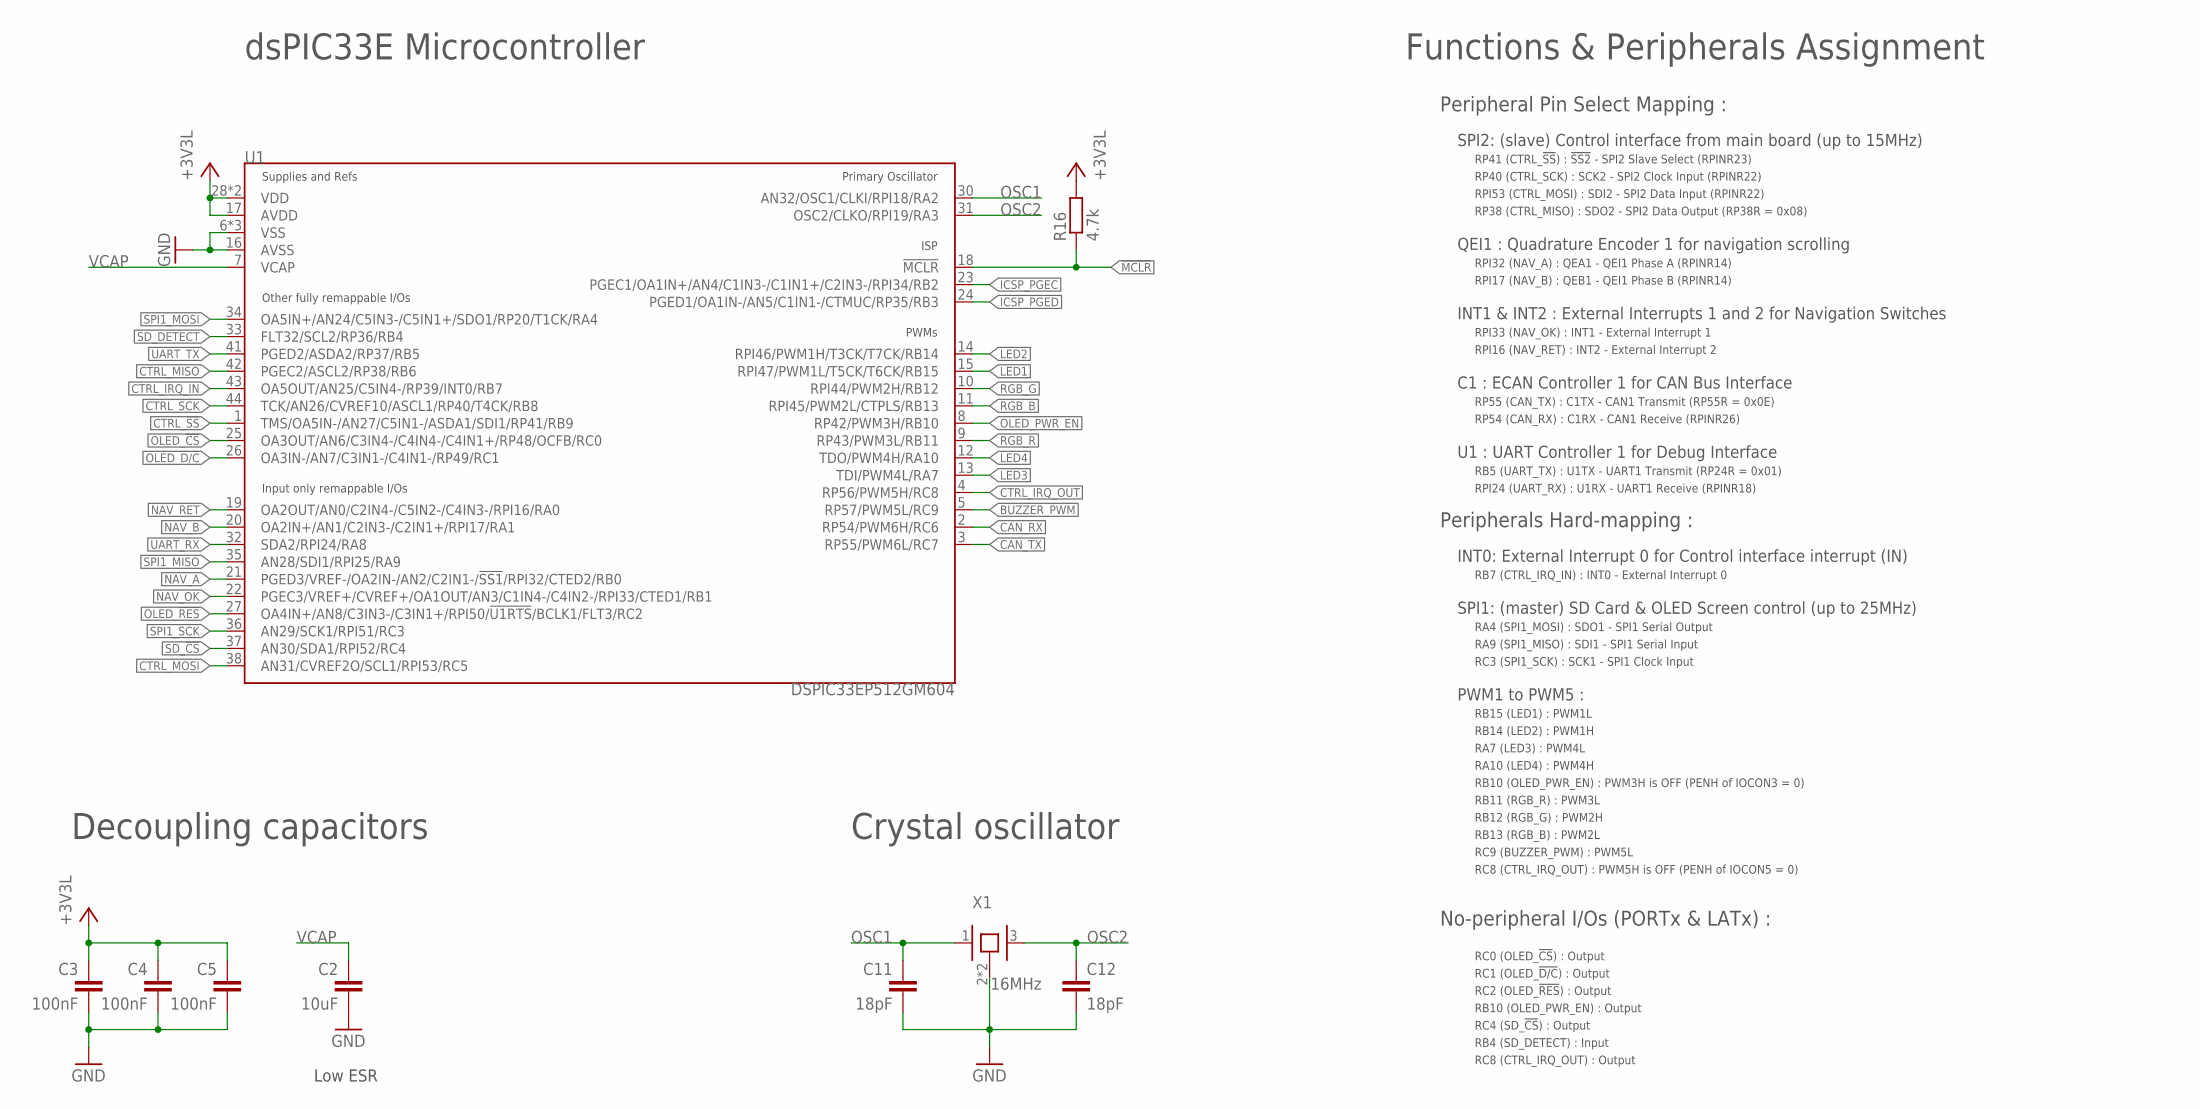
[picture p16: schematic microBoard_HMI.sch, sheet 2, Microcontroller]

Parts:
C2: 10uF; C1206
C3, C4, C5: 100nF; C0603
C11, C12: 18pF; C0603
R16: 4.7k; R0603
U1: DSPIC33EP512GM604; TQFP_44
X1: 16MHz; CRYSTAL-OSC-SMD-5X3

Connections:
!MCLR!: R16.1, U1.18 (!MCLR!); also elsewhere on the board
+3V3L: C3.1, C4.1, C5.1, R16.2, U1.17 (AVDD), U1.28 (VDD), U1.40 (VDD); also elsewhere on the board
BUZZER_PWM: U1.5 (RP57/PWM5L/RC9); also elsewhere on the board
CAN_RX: U1.2 (RP54/PWM6H/RC6); also elsewhere on the board
CAN_TX: U1.3 (RP55/PWM6L/RC7); also elsewhere on the board
CTRL_!SS!: U1.1 (TMS/OA5IN-/AN27/C5IN1-/ASDA1/SDI1/RP41/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); also elsewhere on the board
CTRL_IRQ_IN: U1.43 (OA5OUT/AN25/C5IN4-/RP39/INT0/RB7); also elsewhere on the board
CTRL_IRQ_OUT: U1.4 (RP56/PWM5H/RC8); also elsewhere on the board
CTRL_MISO: U1.42 (PGEC2/ASCL2/RP38/RB6); also elsewhere on the board
CTRL_MOSI: U1.38 (AN31/CVREF2O/SCL1/RPI53/RC5); also elsewhere on the board
CTRL_SCK: U1.44 (TCK/AN26/CVREF10/ASCL1/RP40/T4CK/RB8); also elsewhere on the board
GND: C2.2, C3.2, C4.2, C5.2, C11.2, C12.2, U1.6 (VSS), U1.16 (AVSS), U1.29 (VSS), U1.39 (VSS), X1.2, X1.4; also elsewhere on the board
ICSP_PGEC: U1.23 (PGEC1/OA1IN+/AN4/C1IN3-/C1IN1+/C2IN3-/R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); also elsewhere on the board
ICSP_PGED: U1.24 (PGED1/OA1IN-/AN5/C1IN1-/CTMUC/RP35/RB3); also elsewhere on the board
LED1: U1.15 (RPI47/PWM1L/T5CK/T6CK/RB15); also elsewhere on the board
LED2: U1.14 (RPI46/PWM1H/T3CK/T7CK/RB14); also elsewhere on the board
LED3: U1.13 (TDI/PWM4L/RA7); also elsewhere on the board
LED4: U1.12 (TDO/PWM4H/RA10); also elsewhere on the board
NAV_A: U1.21 (PGED3/VREF-/OA2IN-/AN2/C2IN1-/!SS1!/RPI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); also elsewhere on the board
NAV_B: U1.20 (OA2IN+/AN1/C2IN3-/C2IN1+/RPI17/RA1); also elsewhere on the board
NAV_OK: U1.22 (PGEC3/VREF+/CVREF+/OA1OUT/AN3/C1IN4-/C4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); also elsewhere on the board
NAV_RET: U1.19 (OA2OUT/AN0/C2IN4-/C5IN2-/C4IN3-/RPI16/R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); also elsewhere on the board
OLED_!CS!: U1.25 (OA3OUT/AN6/C3IN4-/C4IN4-/C4IN1+/RP48/OC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); also elsewhere on the board
OLED_!D/C!: U1.26 (OA3IN-/AN7/C3IN1-/C4IN1-/RP49/RC1); also elsewhere on the board
OLED_!RES!: U1.27 (OA4IN+/AN8/C3IN3-/C3IN1+/RPI50/!U1RTS!/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); also elsewhere on the board
OLED_PWR_EN: U1.8 (RP42/PWM3H/RB10); also elsewhere on the board
OSC1: C11.1, U1.30 (AN32/OSC1/CLKI/RPI18/RA2), X1.1
OSC2: C12.1, U1.31 (OSC2/CLKO/RPI19/RA3), X1.3
RGB_B: U1.11 (RPI45/PWM2L/CTPLS/RB13); also elsewhere on the board
RGB_G: U1.10 (RPI44/PWM2H/RB12); also elsewhere on the board
RGB_R: U1.9 (RP43/PWM3L/RB11); also elsewhere on the board
SD_!CS!: U1.37 (AN30/SDA1/RPI52/RC4); also elsewhere on the board
SD_DETECT: U1.33 (FLT32/SCL2/RP36/RB4); also elsewhere on the board
SPI1_MISO: U1.35 (AN28/SDI1/RPI25/RA9); also elsewhere on the board
SPI1_MOSI: U1.34 (OA5IN+/AN24/C5IN3-/C5IN1+/SDO1/RP20/T1C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); also elsewhere on the board
SPI1_SCK: U1.36 (AN29/SCK1/RPI51/RC3); also elsewhere on the board
UART_RX: U1.32 (SDA2/RPI24/RA8); also elsewhere on the board
UART_TX: U1.41 (PGED2/ASDA2/RP37/RB5); also elsewhere on the board
VCAP: C2.1, U1.7 (VCAP)

Notes on the sheet:
SPI2: (slave) Control interface from main board (up to 15MHz)
dsPIC33E Microcontroller
Functions & Peripherals Assignment
Decoupling capacitors
Low ESR
Crystal oscillator
Peripheral Pin Select Mapping :
RB4 (SD_DETECT) : Input
RB5 (UART_TX) : U1TX - UART1 Transmit (RP24R = 0x01)
RPI53 (CTRL_MOSI) : SDI2 - SPI2 Data Input (RPINR22)
RP38 (CTRL_MISO) : SDO2 - SPI2 Data Output (RP38R = 0x08)
RP40 (CTRL_SCK) : SCK2 - SPI2 Clock Input (RPINR22)
RP41 (CTRL_!SS!) : !SS2! - SPI2 Slave Select (RPINR23)
RC0 (OLED_!CS!) : Output
No-peripheral I/Os (PORTx & LATx) :
RC1 (OLED_!D/C!) : Output
RPI16 (NAV_RET) : INT2 - External Interrupt 2
RPI17 (NAV_B) : QEB1 - QEI1 Phase B (RPINR14)
RPI24 (UART_RX) : U1RX - UART1 Receive (RPINR18)
Peripherals Hard-mapping :
RPI32 (NAV_A) : QEA1 - QEI1 Phase A (RPINR14)
RPI33 (NAV_OK) : INT1 - External Interrupt 1
RC2 (OLED_!RES!) : Output
RC4 (SD_!CS!) : Output
RB7 (CTRL_IRQ_IN) : INT0 - External Interrupt 0
RP55 (CAN_TX) : C1TX - CAN1 Transmit (RP55R = 0x0E)
RP54 (CAN_RX) : C1RX - CAN1 Receive (RPINR26)
RB10 (OLED_PWR_EN) : Output
RC8 (CTRL_IRQ_OUT) : Output
RA4 (SPI1_MOSI) : SDO1 - SPI1 Serial Output
RA9 (SPI1_MISO) : SDI1 - SPI1 Serial Input
RC3 (SPI1_SCK) : SCK1 - SPI1 Clock Input
PWM1 to PWM5 :
SPI1: (master) SD Card & OLED Screen control (up to 25MHz)
INT1 & INT2 : External Interrupts 1 and 2 for Navigation Switches
QEI1 : Quadrature Encoder 1 for navigation scrolling
C1 : ECAN Controller 1 for CAN Bus Interface
U1 : UART Controller 1 for Debug Interface
RB15 (LED1) : PWM1L
RB14 (LED2) : PWM1H
RA7 (LED3) : PWM4L
RA10 (LED4) : PWM4H
RB11 (RGB_R) : PWM3L
RB12 (RGB_G) : PWM2H
RB13 (RGB_B) : PWM2L
RC9 (BUZZER_PWM) : PWM5L
RC8 (CTRL_IRQ_OUT) : PWM5H is OFF (PENH of IOCON5 = 0)
RB10 (OLED_PWR_EN) : PWM3H is OFF (PENH of IOCON3 = 0)
INT0: External Interrupt 0 for Control interface interrupt (IN)

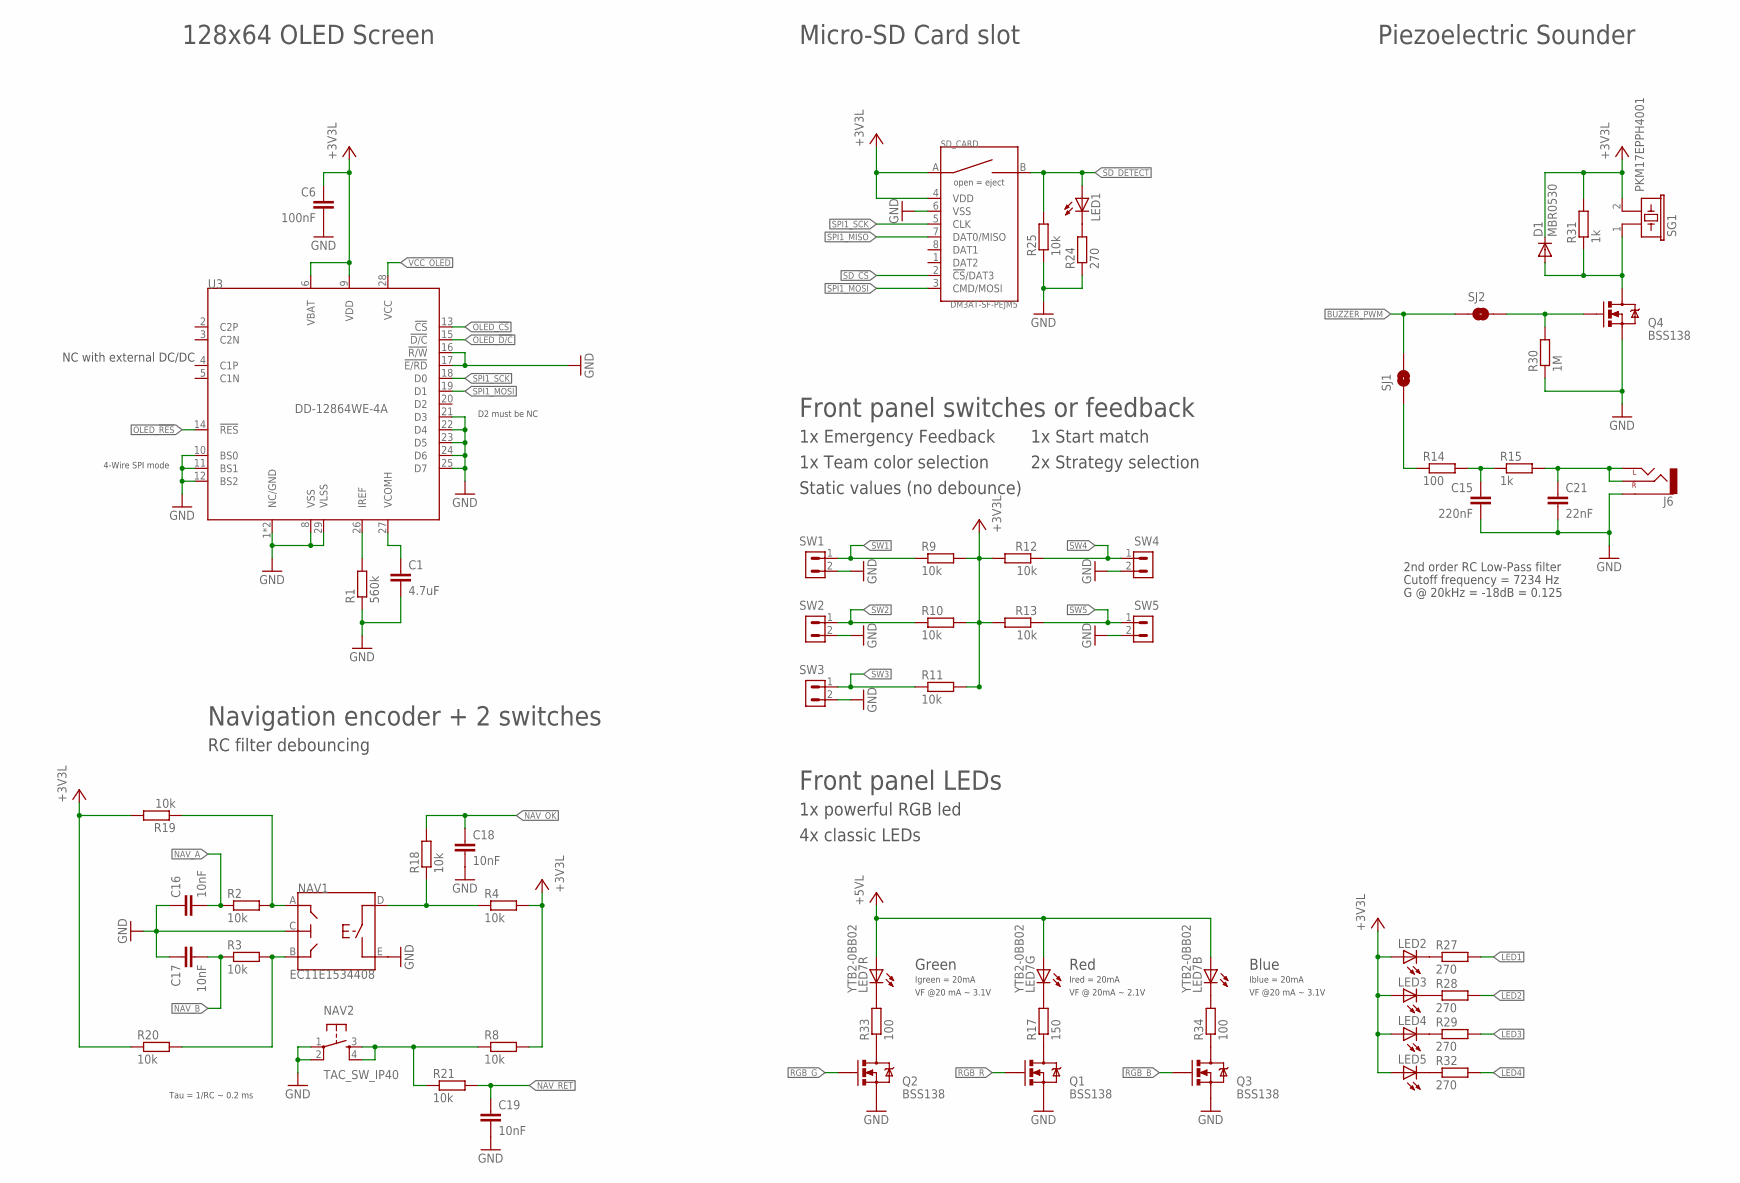
[picture p17: schematic microBoard_HMI.sch, sheet 3, Human Machine Interfaces]

Parts:
C1: 4.7uF; C1206
C6: 100nF; C0603
C15: 220nF; C0603
C16, C17, C18, C19: 10nF; C0603
C21: 22nF; C0603
D1: MBR0530; SOD-123_MINI-SMA
J6: AUDIO-JACK1:1; STEREOJACK2.5MM
LED1, LED2, LED3, LED4, LED5: LEDCHIP-LED0805; CHIP-LED0805
LED7: YTB2-0BB02; GM5WA94310A
NAV1: EC11E1534408
NAV2: TAC_SW_IP40
Q1, Q2, Q3, Q4: BSS138; SOT23
R1: 560k; R0603
R2, R3, R4, R8, R9, R10, R11, R12, R13, R18, R19, R20, R21, R25: 10k; R0603
R14, R33, R34: 100; R0603
R15, R31: 1k; R0603
R17: 150; R0603
R24, R27, R28, R29, R32: 270; R0603
R30: 1M; R0603
SD_CARD: DM3AT-SF-PEJM5; DM3AT
SG1: PKM17EPPH4001; F/EE17P
SJ1, SJ2: SOLDERJUMPERNC2; SJ_2S-NOTRACE
SW1, SW2, SW3, SW4, SW5: HE14_H_2
U3: DD-12864WE-4A

Connections:
+3V3L: C6.1, D1.C, LED2.A, LED3.A, LED4.A, LED5.A, R4.2, R8.2, R9.2, R10.2, R11.2, R12.2, R13.2, R19.2, R20.1, R31.2, SD_CARD.4 (VDD), SD_CARD.A, SG1.2, U3.6 (VBAT), U3.9 (VDD); also elsewhere on the board
+5VL: LED7.1 (A), LED7.2 (A), LED7.3 (A); also elsewhere on the board
BUZZER_PWM: SJ1.2, SJ2.1; also elsewhere on the board
GND: C1.2, C6.2, C15.2, C16.1, C17.1, C18.2, C19.2, C21.2, J6.5 (SLEEVE), NAV1.C, NAV1.E, NAV2.1, NAV2.2, Q1.2 (S), Q2.2 (S), Q3.2 (S), Q4.2 (S), R1.1, R24.1, R25.1, R30.1, SD_CARD.6 (VSS), SW1.2, SW2.2, SW3.2, SW4.2, SW5.2, U3.1 (NC/GND), U3.8 (VSS), U3.10 (BS0), U3.11 (BS1), U3.12 (BS2), U3.16 (!R/W!), U3.17 (!E/RD!), U3.21 (D3), U3.22 (D4), U3.23 (D5), U3.24 (D6), U3.25 (D7), U3.29 (VLSS), U3.30 (NC/GND); also elsewhere on the board
LED1: R27.2; also elsewhere on the board
LED2: R28.2; also elsewhere on the board
LED3: R29.2; also elsewhere on the board
LED4: R32.2; also elsewhere on the board
unnamed: R1.2, U3.26 (IREF)
unnamed: C1.1, U3.27 (VCOMH)
unnamed: LED7.5 (C), R33.2
unnamed: LED7.4 (C), R17.2
unnamed: LED7.6 (C), R34.2
unnamed: Q2.3 (D), R33.1
unnamed: Q1.3 (D), R17.1
unnamed: Q3.3 (D), R34.1
unnamed: C21.1, J6.1 (LEFT), J6.4 (RIGHT), R15.2
unnamed: D1.A, Q4.3 (D), R31.1, SG1.1
unnamed: C15.1, R14.2, R15.1
unnamed: R14.1, SJ1.1
unnamed: LED1.C, R24.2
unnamed: NAV1.A, R2.2, R19.1
unnamed: NAV1.B, R3.2, R20.2
unnamed: NAV1.D, R4.1, R18.1
unnamed: NAV2.3, NAV2.4, R8.1, R21.1
unnamed: Q4.1 (G), R30.2, SJ2.2
unnamed: LED2.C, R27.1
unnamed: LED3.C, R28.1
unnamed: LED4.C, R29.1
unnamed: LED5.C, R32.1
NAV_A: C16.2, R2.1; also elsewhere on the board
NAV_B: C17.2, R3.1; also elsewhere on the board
NAV_OK: C18.1, R18.2; also elsewhere on the board
NAV_RET: C19.1, R21.2; also elsewhere on the board
OLED_!CS!: U3.13 (!CS!); also elsewhere on the board
OLED_!D/C!: U3.15 (!D/C!); also elsewhere on the board
OLED_!RES!: U3.14 (!RES!); also elsewhere on the board
RGB_B: Q3.1 (G); also elsewhere on the board
RGB_G: Q2.1 (G); also elsewhere on the board
RGB_R: Q1.1 (G); also elsewhere on the board
SD_!CS!: SD_CARD.2 (!CS!/DAT3); also elsewhere on the board
SD_DETECT: LED1.A, R25.2, SD_CARD.B; also elsewhere on the board
SPI1_MISO: SD_CARD.7 (DAT0/MISO); also elsewhere on the board
SPI1_MOSI: SD_CARD.3 (CMD/MOSI), U3.19 (D1); also elsewhere on the board
SPI1_SCK: SD_CARD.5 (CLK), U3.18 (D0); also elsewhere on the board
SW1: R9.1, SW1.1; also elsewhere on the board
SW2: R10.1, SW2.1; also elsewhere on the board
SW3: R11.1, SW3.1; also elsewhere on the board
SW4: R12.1, SW4.1; also elsewhere on the board
SW5: R13.1, SW5.1; also elsewhere on the board
VCC_OLED: U3.28 (VCC); also elsewhere on the board

Notes on the sheet:
4-Wire SPI mode
D2 must be NC
NC with external DC/DC
Green
Red
Blue
VF @ 20mA ~ 2.1V
VF @20 mA ~ 3.1V
Igreen = 20mA
Iblue = 20mA
Ired = 20mA
128x64 OLED Screen
1x Emergency Feedback
Micro-SD Card slot
Navigation encoder + 2 switches
Front panel LEDs
Front panel switches or feedback
1x Team color selection
1x Start match
2x Strategy selection
1x powerful RGB led
4x classic LEDs
Piezoelectric Sounder
RC filter debouncing
Tau = 1/RC ~ 0.2 ms
Static values (no debounce)
Cutoff frequency = 7234 Hz
2nd order RC Low-Pass filter
G @ 20kHz = -18dB = 0.125

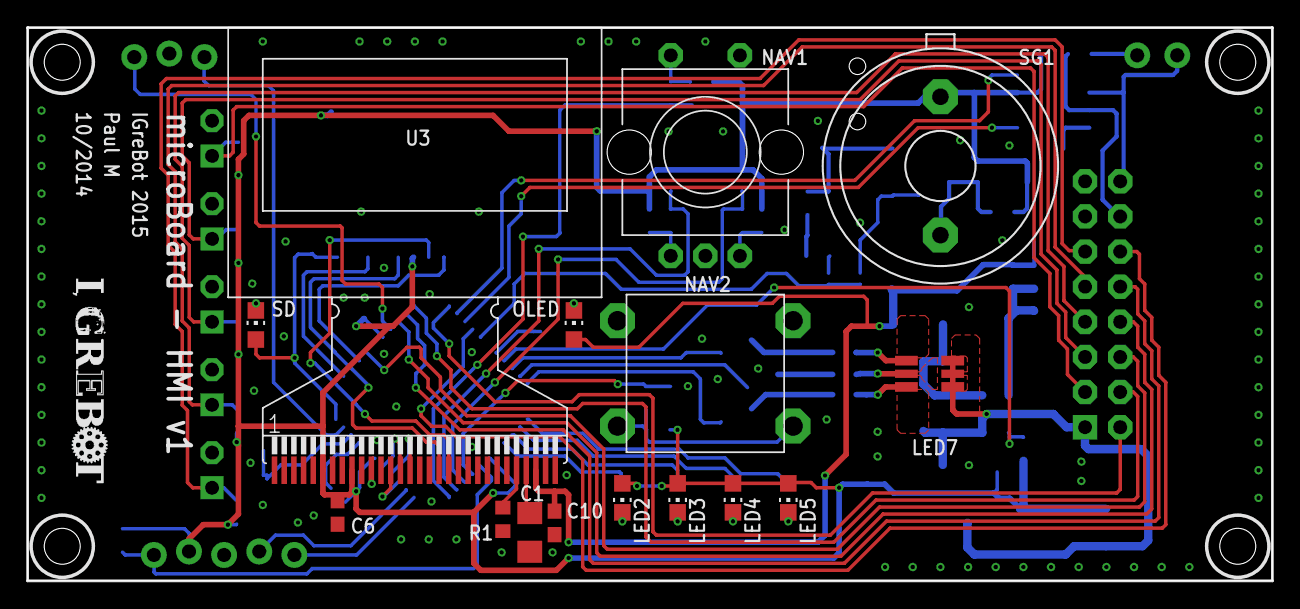
[picture p18: board microBoard_HMI.brd from above]

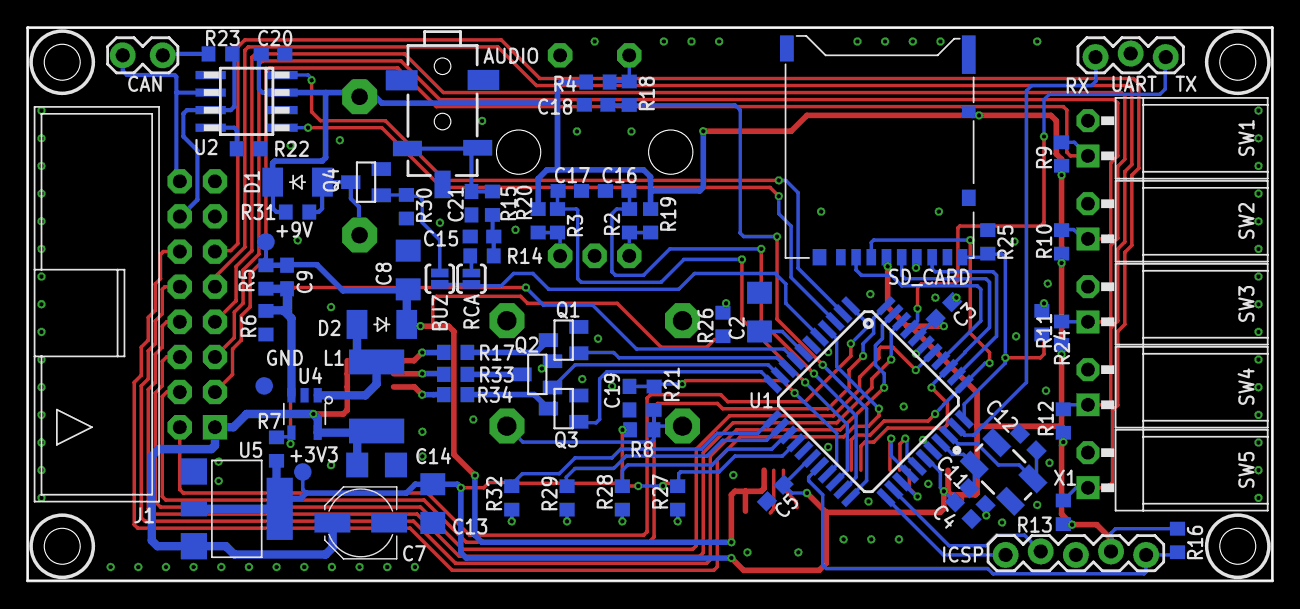
[picture p19: board microBoard_HMI.brd from below]

Board: 2 copper layers, 90.0 x 40.0 mm, 94 parts (79 on the bottom side), 75 nets.
