I-Grebot/elec_microboard/src/Power/microBoard_power.brd

## EAGLE design src/Power/microBoard_power.brd (2016-11-11)

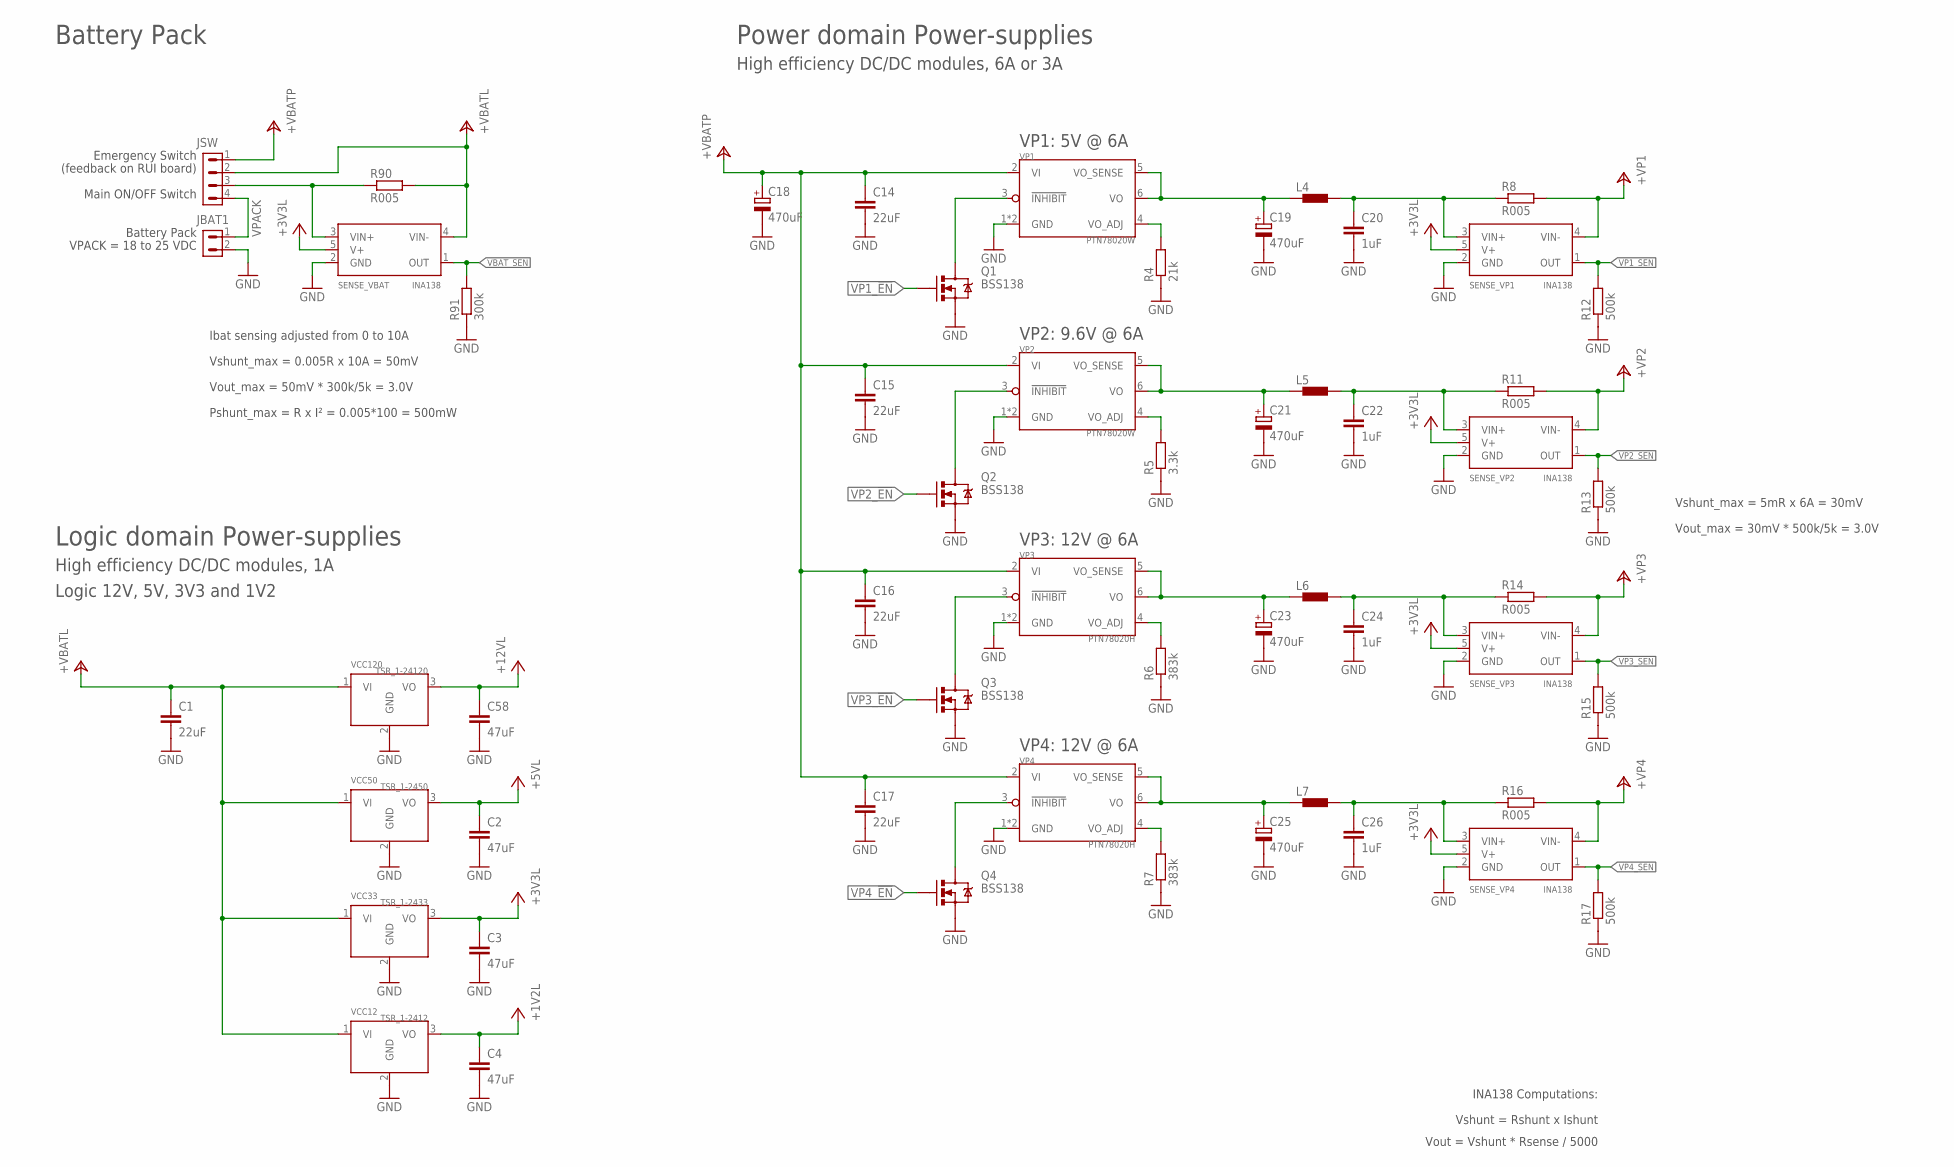
[picture p20: schematic microBoard_power.sch, sheet 1, Power-supplies]

Parts:
C1, C14, C15, C16, C17: 22uF; C3225
C2, C3, C4, C58: 47uF; C1210
C18: 470uF; PANASONIC_B
C19, C21, C23, C25: 470uF; PANASONIC_D
C20, C22, C24, C26: 1uF; C3225
JBAT1: MC15-GF-3.81-LR_2; CON_3.81_LR_2
JSW: MC15-GF-3.81-LR_4; CON_3.81_LR_4
L4, L5, L6, L7: DR1030
Q1, Q2, Q3, Q4: BSS138; SOT23
R4: 21k; R0603
R5: 3.3k; R0603
R6, R7: 383k; R0603
R8, R11, R14, R16, R90: R005; R2512
R12, R13, R15, R17: 500k; R0603
R91: 300k; R0603
SENSE_VBAT: INA138; DBV_05
SENSE_VP1, SENSE_VP2, SENSE_VP3, SENSE_VP4: INA138; DBV_05
VCC12: TSR_1-2412; TSR1
VCC33: TSR_1-2433; TSR1
VCC50: TSR_1-2450; TSR1
VCC120: TSR_1-24120; TSR1
VP1, VP2: PTN78020W; PTN78020
VP3, VP4: PTN78020H; PTN78020

Connections:
!INHIBIT!_VP1: Q1.3 (D), VP1.3 (!INHIBIT!)
!INHIBIT!_VP5: Q2.3 (D), VP2.3 (!INHIBIT!)
!INHIBIT!_VP6: Q3.3 (D), VP3.3 (!INHIBIT!)
!INHIBIT!_VP7: Q4.3 (D), VP4.3 (!INHIBIT!)
+1V2L: C4.1, VCC12.3 (VO); also elsewhere on the board
+3V3L: C3.1, SENSE_VBAT.5 (V+), SENSE_VP1.5 (V+), SENSE_VP2.5 (V+), SENSE_VP3.5 (V+), SENSE_VP4.5 (V+), VCC33.3 (VO); also elsewhere on the board
+5VL: C2.1, VCC50.3 (VO); also elsewhere on the board
+12VL: C58.1, VCC120.3 (VO); also elsewhere on the board
+VBATL: C1.1, JSW.2, R90.2, SENSE_VBAT.4 (VIN-), VCC12.1 (VI), VCC33.1 (VI), VCC50.1 (VI), VCC120.1 (VI)
+VBATP: C14.1, C15.1, C16.1, C17.1, C18.+, JSW.1, VP1.2 (VI), VP2.2 (VI), VP3.2 (VI), VP4.2 (VI); also elsewhere on the board
+VP1: R8.2, SENSE_VP1.4 (VIN-); also elsewhere on the board
+VP2: R11.2, SENSE_VP2.4 (VIN-); also elsewhere on the board
+VP3: R14.2, SENSE_VP3.4 (VIN-); also elsewhere on the board
+VP4: R16.2, SENSE_VP4.4 (VIN-); also elsewhere on the board
GND: C1.2, C2.2, C3.2, C4.2, C14.2, C15.2, C16.2, C17.2, C18.-, C19.-, C20.2, C21.-, C22.2, C23.-, C24.2, C25.-, C26.2, C58.2, JBAT1.2, Q1.2 (S), Q2.2 (S), Q3.2 (S), Q4.2 (S), R4.1, R5.1, R6.1, R7.1, R12.1, R13.1, R15.1, R17.1, R91.1, SENSE_VBAT.2 (GND), SENSE_VP1.2 (GND), SENSE_VP2.2 (GND), SENSE_VP3.2 (GND), SENSE_VP4.2 (GND), VCC12.2 (GND), VCC33.2 (GND), VCC50.2 (GND), VCC120.2 (GND), VP1.1 (GND), VP1.7 (GND), VP2.1 (GND), VP2.7 (GND), VP3.1 (GND), VP3.7 (GND), VP4.1 (GND), VP4.7 (GND); also elsewhere on the board
unnamed: C19.+, L4.1, VP1.5 (VO_SENSE), VP1.6 (VO)
unnamed: R7.2, VP4.4 (VO_ADJ)
unnamed: C20.1, L4.2, R8.1, SENSE_VP1.3 (VIN+)
unnamed: R6.2, VP3.4 (VO_ADJ)
unnamed: R5.2, VP2.4 (VO_ADJ)
unnamed: C21.+, L5.1, VP2.5 (VO_SENSE), VP2.6 (VO)
unnamed: R4.2, VP1.4 (VO_ADJ)
unnamed: C22.1, L5.2, R11.1, SENSE_VP2.3 (VIN+)
unnamed: C23.+, L6.1, VP3.5 (VO_SENSE), VP3.6 (VO)
unnamed: C24.1, L6.2, R14.1, SENSE_VP3.3 (VIN+)
unnamed: C25.+, L7.1, VP4.5 (VO_SENSE), VP4.6 (VO)
unnamed: C26.1, L7.2, R16.1, SENSE_VP4.3 (VIN+)
unnamed: JSW.3, R90.1, SENSE_VBAT.3 (VIN+)
VBAT_SEN: R91.2, SENSE_VBAT.1 (OUT); also elsewhere on the board
VP1_!EN!: Q1.1 (G); also elsewhere on the board
VP1_SEN: R12.2, SENSE_VP1.1 (OUT); also elsewhere on the board
VP2_!EN!: Q2.1 (G); also elsewhere on the board
VP2_SEN: R13.2, SENSE_VP2.1 (OUT); also elsewhere on the board
VP3_!EN!: Q3.1 (G); also elsewhere on the board
VP3_SEN: R15.2, SENSE_VP3.1 (OUT); also elsewhere on the board
VP4_!EN!: Q4.1 (G); also elsewhere on the board
VP4_SEN: R17.2, SENSE_VP4.1 (OUT); also elsewhere on the board
VPACK: JBAT1.1, JSW.4

Notes on the sheet:
VP1: 5V @ 6A
VP2: 9.6V @ 6A
VP3: 12V @ 6A
VP4: 12V @ 6A
Logic 12V, 5V, 3V3 and 1V2
VPACK = 18 to 25 VDC
Logic domain Power-supplies
High efficiency DC/DC modules, 1A
Power domain Power-supplies
High efficiency DC/DC modules, 6A or 3A
Battery Pack
Vshunt = Rshunt x Ishunt
Vout = Vshunt * Rsense / 5000
Vshunt_max = 5mR x 6A = 30mV
Vout_max = 30mV * 500k/5k = 3.0V
Emergency Switch
Main ON/OFF Switch
(feedback on RUI board)
Vshunt_max = 0.005R x 10A = 50mV
Vout_max = 50mV * 300k/5k = 3.0V
Ibat sensing adjusted from 0 to 10A
INA138 Computations:
Pshunt_max = R x I² = 0.005*100 = 500mW

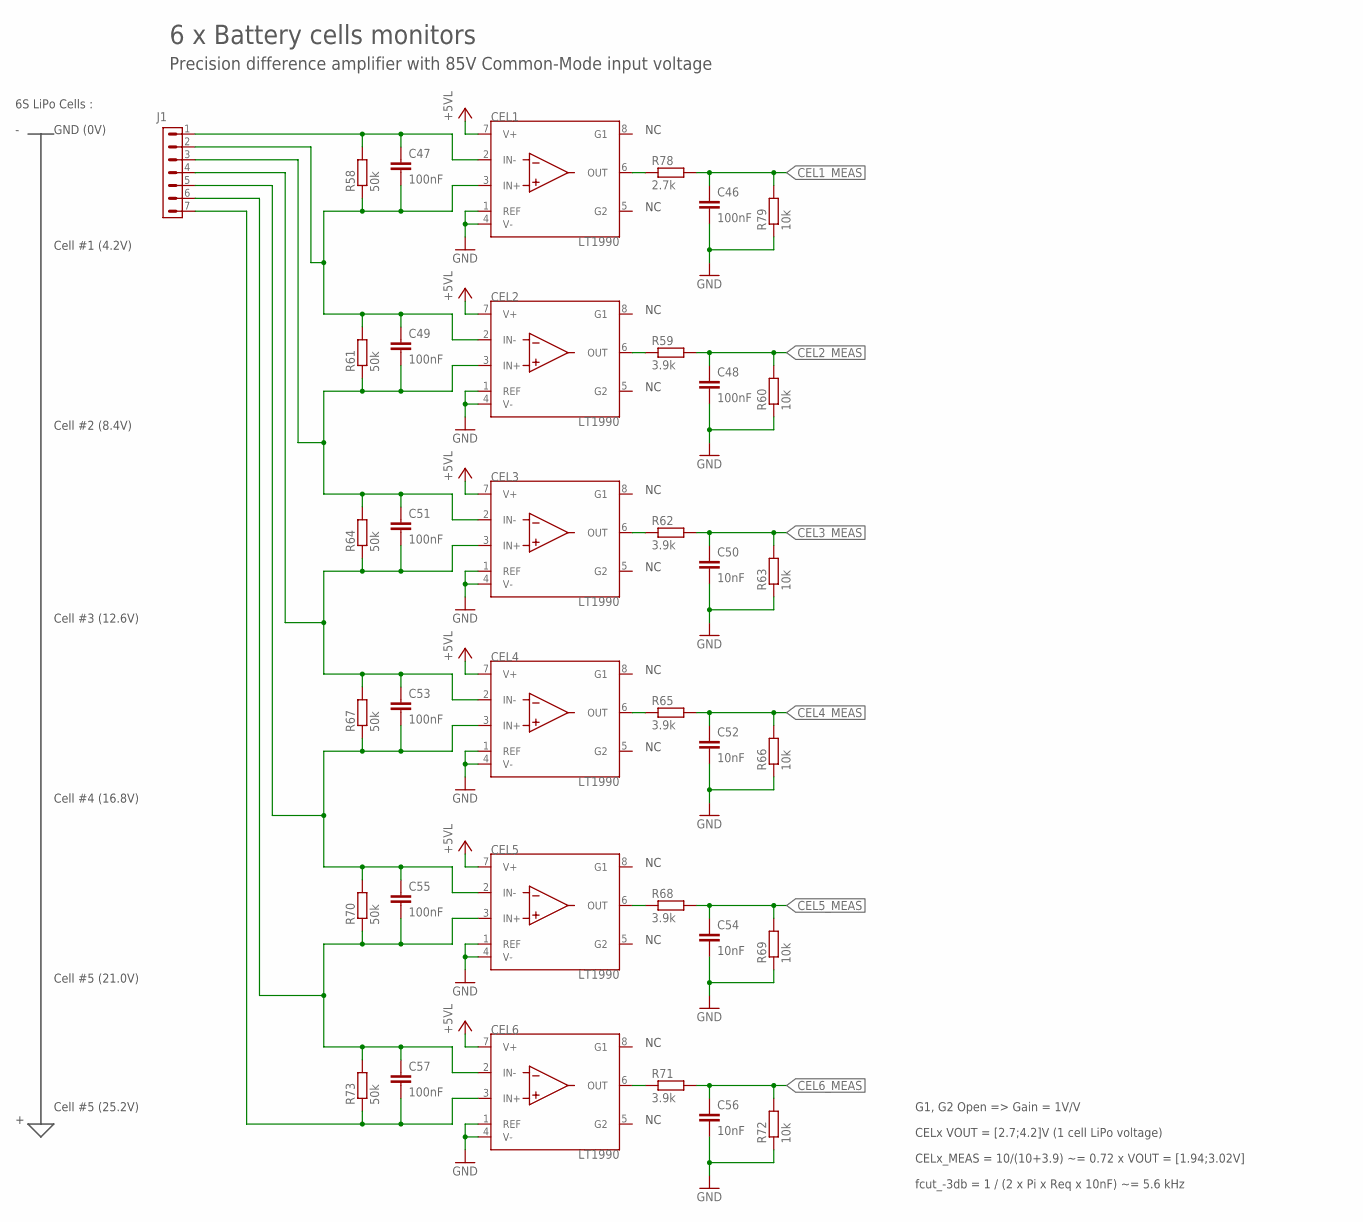
[picture p21: schematic microBoard_power.sch, sheet 2, Battery Monitoring]

Parts:
C46, C47, C48, C49, C51, C53, C55, C57: 100nF; C0603
C50, C52, C54, C56: 10nF; C0603
CEL1, CEL2, CEL3, CEL4, CEL5, CEL6: LT1990; S8
J1: JST-XH-S_7; JST-XH-7S
R58, R61, R64, R67, R70, R73: 50k; R0603
R59, R62, R65, R68, R71: 3.9k; R0603
R60, R63, R66, R69, R72, R79: 10k; R0603
R78: 2.7k; R0603

Connections:
+5VL: CEL1.7 (V+), CEL2.7 (V+), CEL3.7 (V+), CEL4.7 (V+), CEL5.7 (V+), CEL6.7 (V+); also elsewhere on the board
CEL1_MEAS: C46.1, R78.2, R79.2; also elsewhere on the board
CEL2_MEAS: C48.1, R59.2, R60.2; also elsewhere on the board
CEL3_MEAS: C50.1, R62.2, R63.2; also elsewhere on the board
CEL4_MEAS: C52.1, R65.2, R66.2; also elsewhere on the board
CEL5_MEAS: C54.1, R68.2, R69.2; also elsewhere on the board
CEL6_MEAS: C56.1, R71.2, R72.2; also elsewhere on the board
GND: C46.2, C48.2, C50.2, C52.2, C54.2, C56.2, CEL1.1 (REF), CEL1.4 (V-), CEL2.1 (REF), CEL2.4 (V-), CEL3.1 (REF), CEL3.4 (V-), CEL4.1 (REF), CEL4.4 (V-), CEL5.1 (REF), CEL5.4 (V-), CEL6.1 (REF), CEL6.4 (V-), R60.1, R63.1, R66.1, R69.1, R72.1, R79.1; also elsewhere on the board
unnamed: CEL1.6 (OUT), R78.1
unnamed: C47.1, CEL1.2 (IN-), J1.1, R58.2
unnamed: C47.2, C49.1, CEL1.3 (IN+), CEL2.2 (IN-), J1.2, R58.1, R61.2
unnamed: CEL2.6 (OUT), R59.1
unnamed: C49.2, C51.1, CEL2.3 (IN+), CEL3.2 (IN-), J1.3, R61.1, R64.2
unnamed: CEL3.6 (OUT), R62.1
unnamed: C51.2, C53.1, CEL3.3 (IN+), CEL4.2 (IN-), J1.4, R64.1, R67.2
unnamed: CEL4.6 (OUT), R65.1
unnamed: C53.2, C55.1, CEL4.3 (IN+), CEL5.2 (IN-), J1.5, R67.1, R70.2
unnamed: CEL5.6 (OUT), R68.1
unnamed: C55.2, C57.1, CEL5.3 (IN+), CEL6.2 (IN-), J1.6, R70.1, R73.2
unnamed: CEL6.6 (OUT), R71.1
unnamed: C57.2, CEL6.3 (IN+), J1.7, R73.1

Notes on the sheet:
G1, G2 Open => Gain = 1V/V
CELx VOUT = [2.7;4.2]V (1 cell LiPo voltage)
CELx_MEAS = 10/(10+3.9) ~= 0.72 x VOUT = [1.94;3.02V]
6S LiPo Cells :
GND (0V)
Cell #1 (4.2V)
Cell #2 (8.4V)
Cell #3 (12.6V)
Cell #4 (16.8V)
Cell #5 (21.0V)
Cell #5 (25.2V)
6 x Battery cells monitors
Precision difference amplifier with 85V Common-Mode input voltage
fcut_-3db = 1 / (2 x Pi x Req x 10nF) ~= 5.6 kHz
