I-Grebot/elec_microboard/src/Power/microBoard_power.brd

## EAGLE design src/Power/microBoard_power.brd (continued)

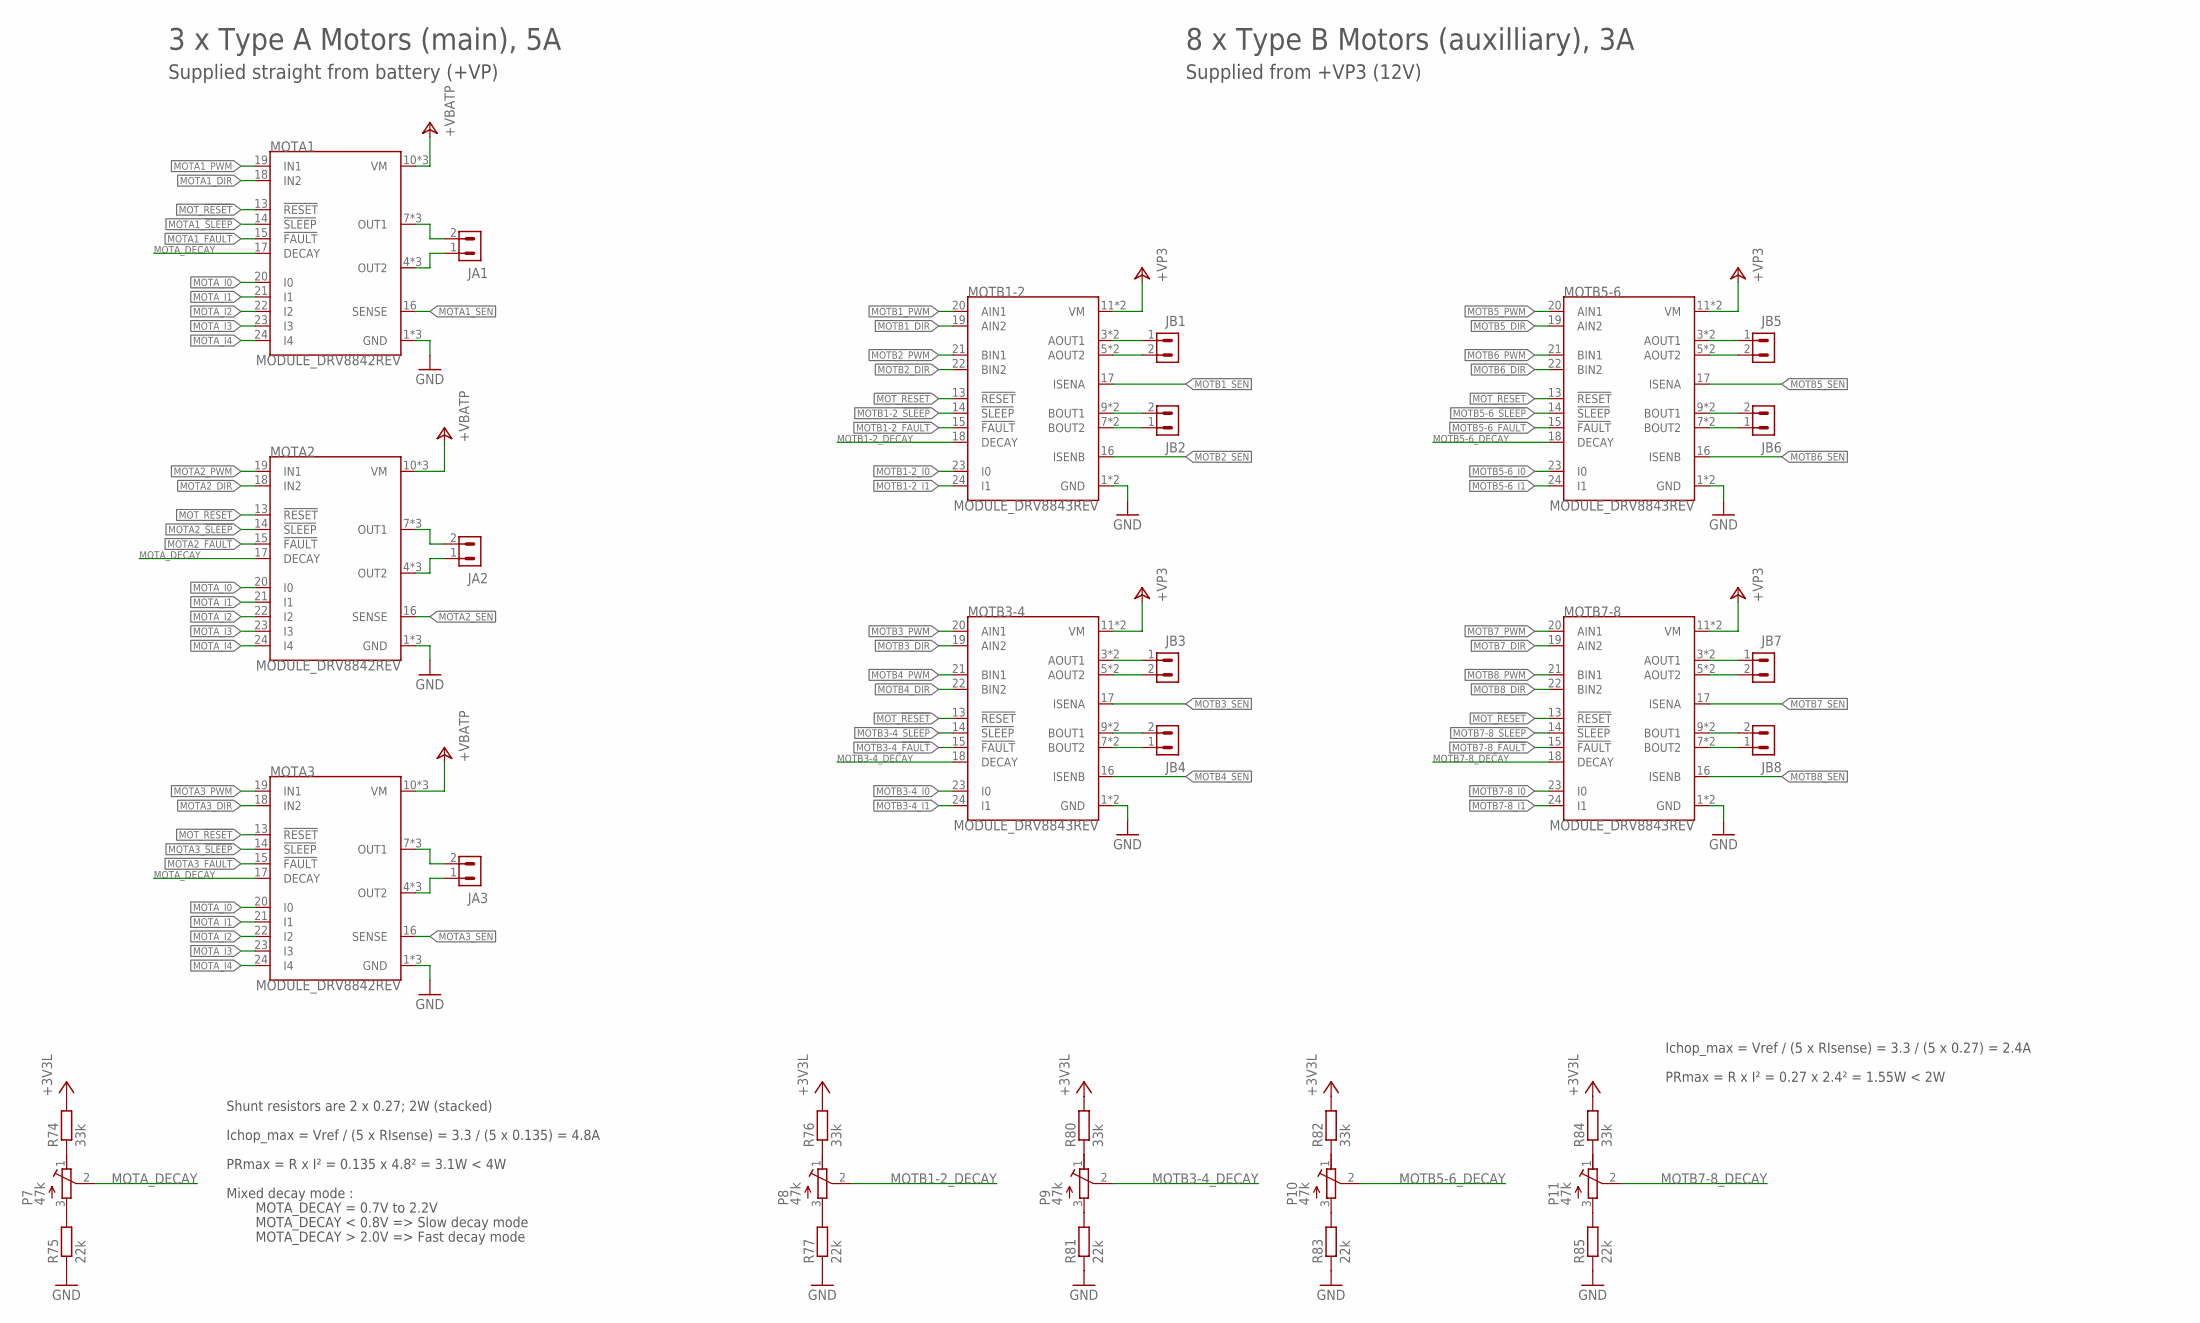
[picture p22: schematic microBoard_power.sch, sheet 3, Motor Drivers]

Parts:
JA1, JA2, JA3: MC15-G-3-3.81_2; CON_3.81_2
JB1, JB2, JB3, JB4, JB5, JB6, JB7, JB8: MC15-G-3-3.81_2; CON_3.81_2
MOTA1, MOTA2, MOTA3: MODULE_DRV8842REV; MODULE_DRV884X_REV
MOTB1-2, MOTB3-4, MOTB5-6, MOTB7-8: MODULE_DRV8843REV; MODULE_DRV884X_REV
P7, P8, P9, P10, P11: 47k; RTRIMT93XB
R74, R76, R80, R82, R84: 33k; R0603
R75, R77, R81, R83, R85: 22k; R0603

Connections:
+3V3L: R74.2, R76.2, R80.2, R82.2, R84.2; also elsewhere on the board
+VBATP: MOTA1.10 (VM), MOTA1.11 (VM), MOTA1.12 (VM), MOTA2.10 (VM), MOTA2.11 (VM), MOTA2.12 (VM), MOTA3.10 (VM), MOTA3.11 (VM), MOTA3.12 (VM); also elsewhere on the board
+VP3: MOTB1-2.11 (VM), MOTB1-2.12 (VM), MOTB3-4.11 (VM), MOTB3-4.12 (VM), MOTB5-6.11 (VM), MOTB5-6.12 (VM), MOTB7-8.11 (VM), MOTB7-8.12 (VM); also elsewhere on the board
GND: MOTA1.1 (GND), MOTA1.2 (GND), MOTA1.3 (GND), MOTA2.1 (GND), MOTA2.2 (GND), MOTA2.3 (GND), MOTA3.1 (GND), MOTA3.2 (GND), MOTA3.3 (GND), MOTB1-2.1 (GND), MOTB1-2.2 (GND), MOTB3-4.1 (GND), MOTB3-4.2 (GND), MOTB5-6.1 (GND), MOTB5-6.2 (GND), MOTB7-8.1 (GND), MOTB7-8.2 (GND), R75.1, R77.1, R81.1, R83.1, R85.1; also elsewhere on the board
MOTA1_!FAULT!: MOTA1.15 (!FAULT!); also elsewhere on the board
MOTA1_!SLEEP!: MOTA1.14 (!SLEEP!); also elsewhere on the board
MOTA1_DIR: MOTA1.18 (IN2); also elsewhere on the board
MOTA1_PWM: MOTA1.19 (IN1); also elsewhere on the board
MOTA1_SEN: MOTA1.16 (SENSE); also elsewhere on the board
MOTA2_!FAULT!: MOTA2.15 (!FAULT!); also elsewhere on the board
MOTA2_!SLEEP!: MOTA2.14 (!SLEEP!); also elsewhere on the board
MOTA2_DIR: MOTA2.18 (IN2); also elsewhere on the board
MOTA2_PWM: MOTA2.19 (IN1); also elsewhere on the board
MOTA2_SEN: MOTA2.16 (SENSE); also elsewhere on the board
MOTA3_!FAULT!: MOTA3.15 (!FAULT!); also elsewhere on the board
MOTA3_!SLEEP!: MOTA3.14 (!SLEEP!); also elsewhere on the board
MOTA3_DIR: MOTA3.18 (IN2); also elsewhere on the board
MOTA3_PWM: MOTA3.19 (IN1); also elsewhere on the board
MOTA3_SEN: MOTA3.16 (SENSE); also elsewhere on the board
MOTA_DECAY: MOTA1.17 (DECAY), MOTA2.17 (DECAY), MOTA3.17 (DECAY), P7.2 (S)
MOTA_I0: MOTA1.20 (I0), MOTA2.20 (I0), MOTA3.20 (I0); also elsewhere on the board
MOTA_I1: MOTA1.21 (I1), MOTA2.21 (I1), MOTA3.21 (I1); also elsewhere on the board
MOTA_I2: MOTA1.22 (I2), MOTA2.22 (I2), MOTA3.22 (I2); also elsewhere on the board
MOTA_I3: MOTA1.23 (I3), MOTA2.23 (I3), MOTA3.23 (I3); also elsewhere on the board
MOTA_I4: MOTA1.24 (I4), MOTA2.24 (I4), MOTA3.24 (I4); also elsewhere on the board
MOTB1-2_!FAULT!: MOTB1-2.15 (!FAULT!); also elsewhere on the board
MOTB1-2_!SLEEP!: MOTB1-2.14 (!SLEEP!); also elsewhere on the board
MOTB1-2_DECAY: MOTB1-2.18 (DECAY), P8.2 (S)
MOTB1-2_I0: MOTB1-2.23 (I0); also elsewhere on the board
MOTB1-2_I1: MOTB1-2.24 (I1); also elsewhere on the board
MOTB1_DIR: MOTB1-2.19 (AIN2); also elsewhere on the board
MOTB1_PWM: MOTB1-2.20 (AIN1); also elsewhere on the board
MOTB1_SEN: MOTB1-2.17 (ISENA); also elsewhere on the board
MOTB2_DIR: MOTB1-2.22 (BIN2); also elsewhere on the board
MOTB2_PWM: MOTB1-2.21 (BIN1); also elsewhere on the board
MOTB2_SEN: MOTB1-2.16 (ISENB); also elsewhere on the board
MOTB3-4_!FAULT!: MOTB3-4.15 (!FAULT!); also elsewhere on the board
MOTB3-4_!SLEEP!: MOTB3-4.14 (!SLEEP!); also elsewhere on the board
MOTB3-4_DECAY: MOTB3-4.18 (DECAY), P9.2 (S)
MOTB3-4_I0: MOTB3-4.23 (I0); also elsewhere on the board
MOTB3-4_I1: MOTB3-4.24 (I1); also elsewhere on the board
MOTB3_DIR: MOTB3-4.19 (AIN2); also elsewhere on the board
MOTB3_PWM: MOTB3-4.20 (AIN1); also elsewhere on the board
MOTB3_SEN: MOTB3-4.17 (ISENA); also elsewhere on the board
MOTB4_DIR: MOTB3-4.22 (BIN2); also elsewhere on the board
MOTB4_PWM: MOTB3-4.21 (BIN1); also elsewhere on the board
MOTB4_SEN: MOTB3-4.16 (ISENB); also elsewhere on the board
MOTB5-6_!FAULT!: MOTB5-6.15 (!FAULT!); also elsewhere on the board
MOTB5-6_!SLEEP!: MOTB5-6.14 (!SLEEP!); also elsewhere on the board
MOTB5-6_DECAY: MOTB5-6.18 (DECAY), P10.2 (S)
MOTB5-6_I0: MOTB5-6.23 (I0); also elsewhere on the board
MOTB5-6_I1: MOTB5-6.24 (I1); also elsewhere on the board
MOTB5_DIR: MOTB5-6.19 (AIN2); also elsewhere on the board
MOTB5_PWM: MOTB5-6.20 (AIN1); also elsewhere on the board
MOTB5_SEN: MOTB5-6.17 (ISENA); also elsewhere on the board
MOTB6_DIR: MOTB5-6.22 (BIN2); also elsewhere on the board
MOTB6_PWM: MOTB5-6.21 (BIN1); also elsewhere on the board
MOTB6_SEN: MOTB5-6.16 (ISENB); also elsewhere on the board
MOTB7-8_!FAULT!: MOTB7-8.15 (!FAULT!); also elsewhere on the board
MOTB7-8_!SLEEP!: MOTB7-8.14 (!SLEEP!); also elsewhere on the board
MOTB7-8_DECAY: MOTB7-8.18 (DECAY), P11.2 (S)
MOTB7-8_I0: MOTB7-8.23 (I0); also elsewhere on the board
MOTB7-8_I1: MOTB7-8.24 (I1); also elsewhere on the board
MOTB7_DIR: MOTB7-8.19 (AIN2); also elsewhere on the board
MOTB7_PWM: MOTB7-8.20 (AIN1); also elsewhere on the board
MOTB7_SEN: MOTB7-8.17 (ISENA); also elsewhere on the board
MOTB8_DIR: MOTB7-8.22 (BIN2); also elsewhere on the board
MOTB8_PWM: MOTB7-8.21 (BIN1); also elsewhere on the board
MOTB8_SEN: MOTB7-8.16 (ISENB); also elsewhere on the board
MOT_!RESET!: MOTA1.13 (!RESET!), MOTA2.13 (!RESET!), MOTA3.13 (!RESET!), MOTB1-2.13 (!RESET!), MOTB3-4.13 (!RESET!), MOTB5-6.13 (!RESET!), MOTB7-8.13 (!RESET!); also elsewhere on the board
unnamed: JA1.2, MOTA1.7 (OUT1), MOTA1.8 (OUT1), MOTA1.9 (OUT1)
unnamed: JA2.2, MOTA2.7 (OUT1), MOTA2.8 (OUT1), MOTA2.9 (OUT1)
unnamed: JB3.1, MOTB3-4.3 (AOUT1), MOTB3-4.4 (AOUT1)
unnamed: JB3.2, MOTB3-4.5 (AOUT2), MOTB3-4.6 (AOUT2)
unnamed: JB4.1, MOTB3-4.7 (BOUT2), MOTB3-4.8 (BOUT2)
unnamed: JA2.1, MOTA2.4 (OUT2), MOTA2.5 (OUT2), MOTA2.6 (OUT2)
unnamed: JA1.1, MOTA1.4 (OUT2), MOTA1.5 (OUT2), MOTA1.6 (OUT2)
unnamed: JB1.1, MOTB1-2.3 (AOUT1), MOTB1-2.4 (AOUT1)
unnamed: JB1.2, MOTB1-2.5 (AOUT2), MOTB1-2.6 (AOUT2)
unnamed: JB2.2, MOTB1-2.9 (BOUT1), MOTB1-2.10 (BOUT1)
unnamed: JA3.1, MOTA3.4 (OUT2), MOTA3.5 (OUT2), MOTA3.6 (OUT2)
unnamed: JA3.2, MOTA3.7 (OUT1), MOTA3.8 (OUT1), MOTA3.9 (OUT1)
unnamed: JB4.2, MOTB3-4.9 (BOUT1), MOTB3-4.10 (BOUT1)
unnamed: JB5.1, MOTB5-6.3 (AOUT1), MOTB5-6.4 (AOUT1)
unnamed: JB5.2, MOTB5-6.5 (AOUT2), MOTB5-6.6 (AOUT2)
unnamed: JB6.2, MOTB5-6.9 (BOUT1), MOTB5-6.10 (BOUT1)
unnamed: JB2.1, MOTB1-2.7 (BOUT2), MOTB1-2.8 (BOUT2)
unnamed: JB6.1, MOTB5-6.7 (BOUT2), MOTB5-6.8 (BOUT2)
unnamed: JB7.1, MOTB7-8.3 (AOUT1), MOTB7-8.4 (AOUT1)
unnamed: JB7.2, MOTB7-8.5 (AOUT2), MOTB7-8.6 (AOUT2)
unnamed: JB8.2, MOTB7-8.9 (BOUT1), MOTB7-8.10 (BOUT1)
unnamed: JB8.1, MOTB7-8.7 (BOUT2), MOTB7-8.8 (BOUT2)
unnamed: P7.3 (E), R75.2
unnamed: P7.1 (A), R74.1
unnamed: P8.3 (E), R77.2
unnamed: P8.1 (A), R76.1
unnamed: P9.3 (E), R81.2
unnamed: P9.1 (A), R80.1
unnamed: P10.3 (E), R83.2
unnamed: P10.1 (A), R82.1
unnamed: P11.3 (E), R85.2
unnamed: P11.1 (A), R84.1

Notes on the sheet:
3 x Type A Motors (main), 5A
Ichop_max = Vref / (5 x RIsense) = 3.3 / (5 x 0.135) = 4.8A
Ichop_max = Vref / (5 x RIsense) = 3.3 / (5 x 0.27) = 2.4A
PRmax = R x I² = 0.27 x 2.4² = 1.55W < 2W
PRmax = R x I² = 0.135 x 4.8² = 3.1W < 4W
Shunt resistors are 2 x 0.27; 2W (stacked)
8 x Type B Motors (auxilliary), 3A
Supplied straight from battery (+VP)
Supplied from +VP3 (12V)
Mixed decay mode :
MOTA_DECAY = 0.7V to 2.2V
MOTA_DECAY < 0.8V => Slow decay mode
MOTA_DECAY > 2.0V => Fast decay mode

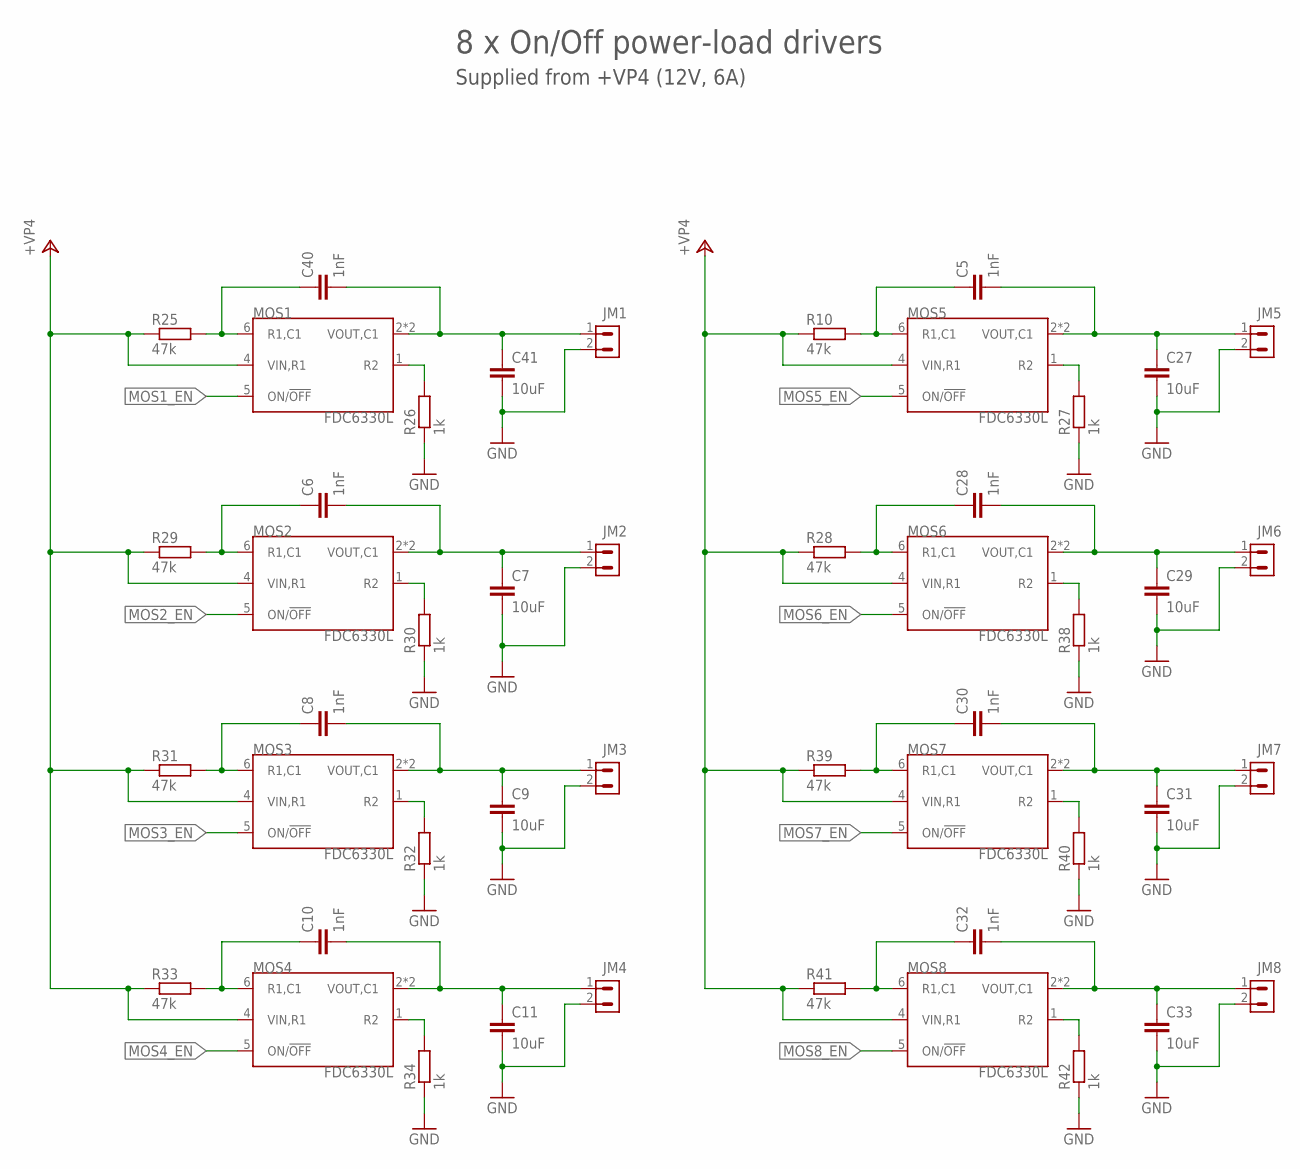
[picture p23: schematic microBoard_power.sch, sheet 4, On/Off Load Drivers]

Parts:
C5, C6, C8, C10, C28, C30, C32, C40: 1nF; C0603
C7, C9, C11, C27, C29, C31, C33, C41: 10uF; C1210
JM1, JM2, JM3, JM4, JM5, JM6, JM7, JM8: CON_2.54_H_2
MOS1, MOS2, MOS3, MOS4, MOS5, MOS6, MOS7, MOS8: FDC6330L; SSOT-6
R10, R25, R28, R29, R31, R33, R39, R41: 47k; R0603
R26, R27, R30, R32, R34, R38, R40, R42: 1k; R0603

Connections:
+VP4: MOS1.4 (VIN,R1), MOS2.4 (VIN,R1), MOS3.4 (VIN,R1), MOS4.4 (VIN,R1), MOS5.4 (VIN,R1), MOS6.4 (VIN,R1), MOS7.4 (VIN,R1), MOS8.4 (VIN,R1), R10.1, R25.1, R28.1, R29.1, R31.1, R33.1, R39.1, R41.1; also elsewhere on the board
GND: C7.2, C9.2, C11.2, C27.2, C29.2, C31.2, C33.2, C41.2, JM1.2, JM2.2, JM3.2, JM4.2, JM5.2, JM6.2, JM7.2, JM8.2, R26.1, R27.1, R30.1, R32.1, R34.1, R38.1, R40.1, R42.1; also elsewhere on the board
MOS1_EN: MOS1.5 (ON/!OFF!); also elsewhere on the board
MOS1_OUT: C40.2, C41.1, JM1.1, MOS1.2 (VOUT,C1), MOS1.3 (VOUT,C1)
MOS2_EN: MOS2.5 (ON/!OFF!); also elsewhere on the board
MOS2_OUT: C6.2, C7.1, JM2.1, MOS2.2 (VOUT,C1), MOS2.3 (VOUT,C1)
MOS3_EN: MOS3.5 (ON/!OFF!); also elsewhere on the board
MOS3_OUT: C8.2, C9.1, JM3.1, MOS3.2 (VOUT,C1), MOS3.3 (VOUT,C1)
MOS4_EN: MOS4.5 (ON/!OFF!); also elsewhere on the board
MOS4_OUT: C10.2, C11.1, JM4.1, MOS4.2 (VOUT,C1), MOS4.3 (VOUT,C1)
MOS5_EN: MOS5.5 (ON/!OFF!); also elsewhere on the board
MOS5_OUT: C5.2, C27.1, JM5.1, MOS5.2 (VOUT,C1), MOS5.3 (VOUT,C1)
MOS6_EN: MOS6.5 (ON/!OFF!); also elsewhere on the board
MOS6_OUT: C28.2, C29.1, JM6.1, MOS6.2 (VOUT,C1), MOS6.3 (VOUT,C1)
MOS7_EN: MOS7.5 (ON/!OFF!); also elsewhere on the board
MOS7_OUT: C30.2, C31.1, JM7.1, MOS7.2 (VOUT,C1), MOS7.3 (VOUT,C1)
MOS8_EN: MOS8.5 (ON/!OFF!); also elsewhere on the board
MOS8_OUT: C32.2, C33.1, JM8.1, MOS8.2 (VOUT,C1), MOS8.3 (VOUT,C1)
unnamed: MOS1.1 (R2), R26.2
unnamed: C5.1, MOS5.6 (R1,C1), R10.2
unnamed: C40.1, MOS1.6 (R1,C1), R25.2
unnamed: MOS5.1 (R2), R27.2
unnamed: C28.1, MOS6.6 (R1,C1), R28.2
unnamed: MOS6.1 (R2), R38.2
unnamed: C6.1, MOS2.6 (R1,C1), R29.2
unnamed: MOS2.1 (R2), R30.2
unnamed: C8.1, MOS3.6 (R1,C1), R31.2
unnamed: MOS3.1 (R2), R32.2
unnamed: C10.1, MOS4.6 (R1,C1), R33.2
unnamed: MOS4.1 (R2), R34.2
unnamed: C30.1, MOS7.6 (R1,C1), R39.2
unnamed: MOS7.1 (R2), R40.2
unnamed: C32.1, MOS8.6 (R1,C1), R41.2
unnamed: MOS8.1 (R2), R42.2

Notes on the sheet:
8 x On/Off power-load drivers
Supplied from +VP4 (12V, 6A)

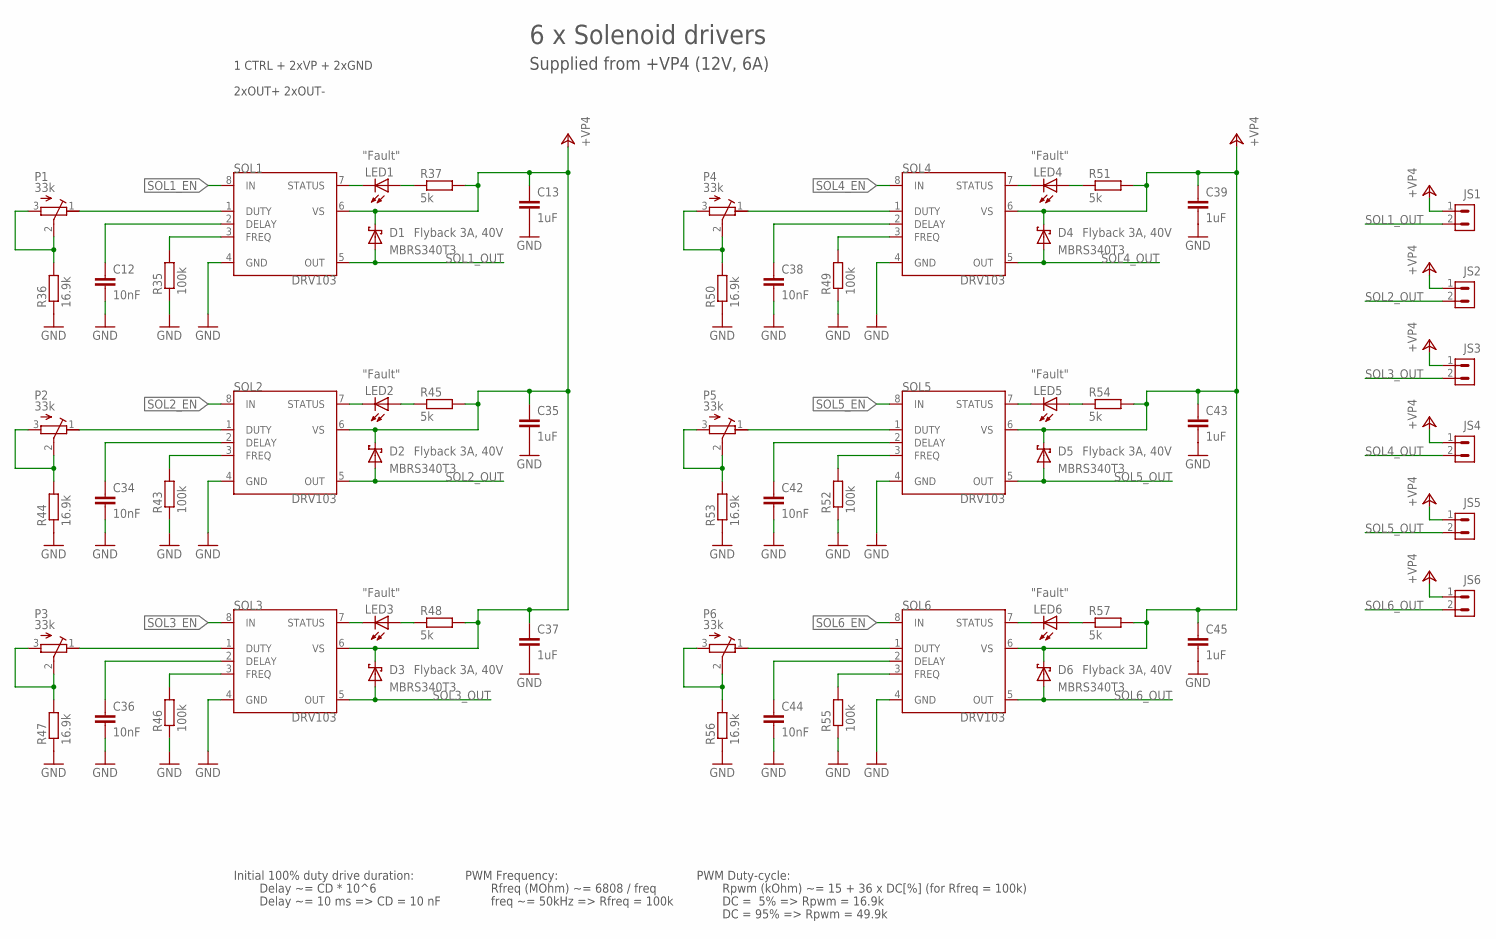
[picture p24: schematic microBoard_power.sch, sheet 5, Solenoid Drivers]

Parts:
C12, C34, C36, C38, C42, C44: 10nF; C0603
C13, C35, C37, C39, C43, C45: 1uF; C1210
D1, D2, D3, D4, D5, D6: MBRS340T3; SMC
JS1, JS2, JS3, JS4, JS5, JS6: CON_2.54_H_2
LED1, LED2, LED3, LED4, LED5, LED6: LEDCHIPLED_0805; CHIPLED_0805
P1, P2, P3, P4, P5, P6: 33k; RTRIMT93XB
R35, R43, R46, R49, R52, R55: 100k; R0603
R36, R44, R47, R50, R53, R56: 16.9k; R0603
R37, R45, R48, R51, R54, R57: 5k; R0603
SOL1, SOL2, SOL3, SOL4, SOL5, SOL6: DRV103; PWP_8

Connections:
+VP4: C13.1, C35.1, C37.1, C39.1, C43.1, C45.1, D1.C, D2.C, D3.C, D4.C, D5.C, D6.C, JS1.1, JS2.1, JS3.1, JS4.1, JS5.1, JS6.1, R37.2, R45.2, R48.2, R51.2, R54.2, R57.2, SOL1.6 (VS), SOL2.6 (VS), SOL3.6 (VS), SOL4.6 (VS), SOL5.6 (VS), SOL6.6 (VS); also elsewhere on the board
GND: C12.2, C13.2, C34.2, C35.2, C36.2, C37.2, C38.2, C39.2, C42.2, C43.2, C44.2, C45.2, R35.1, R36.1, R43.1, R44.1, R46.1, R47.1, R49.1, R50.1, R52.1, R53.1, R55.1, R56.1, SOL1.4 (GND), SOL2.4 (GND), SOL3.4 (GND), SOL4.4 (GND), SOL5.4 (GND), SOL6.4 (GND); also elsewhere on the board
unnamed: C38.1, SOL4.2 (DELAY)
unnamed: C34.1, SOL2.2 (DELAY)
unnamed: R43.2, SOL2.3 (FREQ)
unnamed: P2.1 (A), SOL2.1 (DUTY)
unnamed: P2.2 (S), P2.3 (E), R44.2
unnamed: LED2.C, SOL2.7 (STATUS)
unnamed: C12.1, SOL1.2 (DELAY)
unnamed: R35.2, SOL1.3 (FREQ)
unnamed: P1.1 (A), SOL1.1 (DUTY)
unnamed: P1.2 (S), P1.3 (E), R36.2
unnamed: LED1.C, SOL1.7 (STATUS)
unnamed: LED1.A, R37.1
unnamed: LED2.A, R45.1
unnamed: R49.2, SOL4.3 (FREQ)
unnamed: C36.1, SOL3.2 (DELAY)
unnamed: R46.2, SOL3.3 (FREQ)
unnamed: P3.1 (A), SOL3.1 (DUTY)
unnamed: P3.2 (S), P3.3 (E), R47.2
unnamed: LED3.C, SOL3.7 (STATUS)
unnamed: LED3.A, R48.1
unnamed: P4.1 (A), SOL4.1 (DUTY)
unnamed: P4.2 (S), P4.3 (E), R50.2
unnamed: LED4.C, SOL4.7 (STATUS)
unnamed: LED4.A, R51.1
unnamed: C42.1, SOL5.2 (DELAY)
unnamed: R52.2, SOL5.3 (FREQ)
unnamed: P5.1 (A), SOL5.1 (DUTY)
unnamed: P5.2 (S), P5.3 (E), R53.2
unnamed: LED5.C, SOL5.7 (STATUS)
unnamed: LED5.A, R54.1
unnamed: C44.1, SOL6.2 (DELAY)
unnamed: R55.2, SOL6.3 (FREQ)
unnamed: P6.1 (A), SOL6.1 (DUTY)
unnamed: P6.2 (S), P6.3 (E), R56.2
unnamed: LED6.C, SOL6.7 (STATUS)
unnamed: LED6.A, R57.1
SOL1_EN: SOL1.8 (IN); also elsewhere on the board
SOL1_OUT: D1.A, JS1.2, SOL1.5 (OUT)
SOL2_EN: SOL2.8 (IN); also elsewhere on the board
SOL2_OUT: D2.A, JS2.2, SOL2.5 (OUT)
SOL3_EN: SOL3.8 (IN); also elsewhere on the board
SOL3_OUT: D3.A, JS3.2, SOL3.5 (OUT)
SOL4_EN: SOL4.8 (IN); also elsewhere on the board
SOL4_OUT: D4.A, JS4.2, SOL4.5 (OUT)
SOL5_EN: SOL5.8 (IN); also elsewhere on the board
SOL5_OUT: D5.A, JS5.2, SOL5.5 (OUT)
SOL6_EN: SOL6.8 (IN); also elsewhere on the board
SOL6_OUT: D6.A, JS6.2, SOL6.5 (OUT)

Notes on the sheet:
Initial 100% duty drive duration:
Delay ~= CD * 10^6
Delay ~= 10 ms => CD = 10 nF
PWM Frequency:
Rfreq (MOhm) ~= 6808 / freq
freq ~= 50kHz => Rfreq = 100k
PWM Duty-cycle:
Rpwm (kOhm) ~= 15 + 36 x DC[%] (for Rfreq = 100k)
DC = 5% => Rpwm = 16.9k
DC = 95% => Rpwm = 49.9k
Flyback 3A, 40V
"Fault"
6 x Solenoid drivers
Supplied from +VP4 (12V, 6A)
1 CTRL + 2xVP + 2xGND
2xOUT+ 2xOUT-

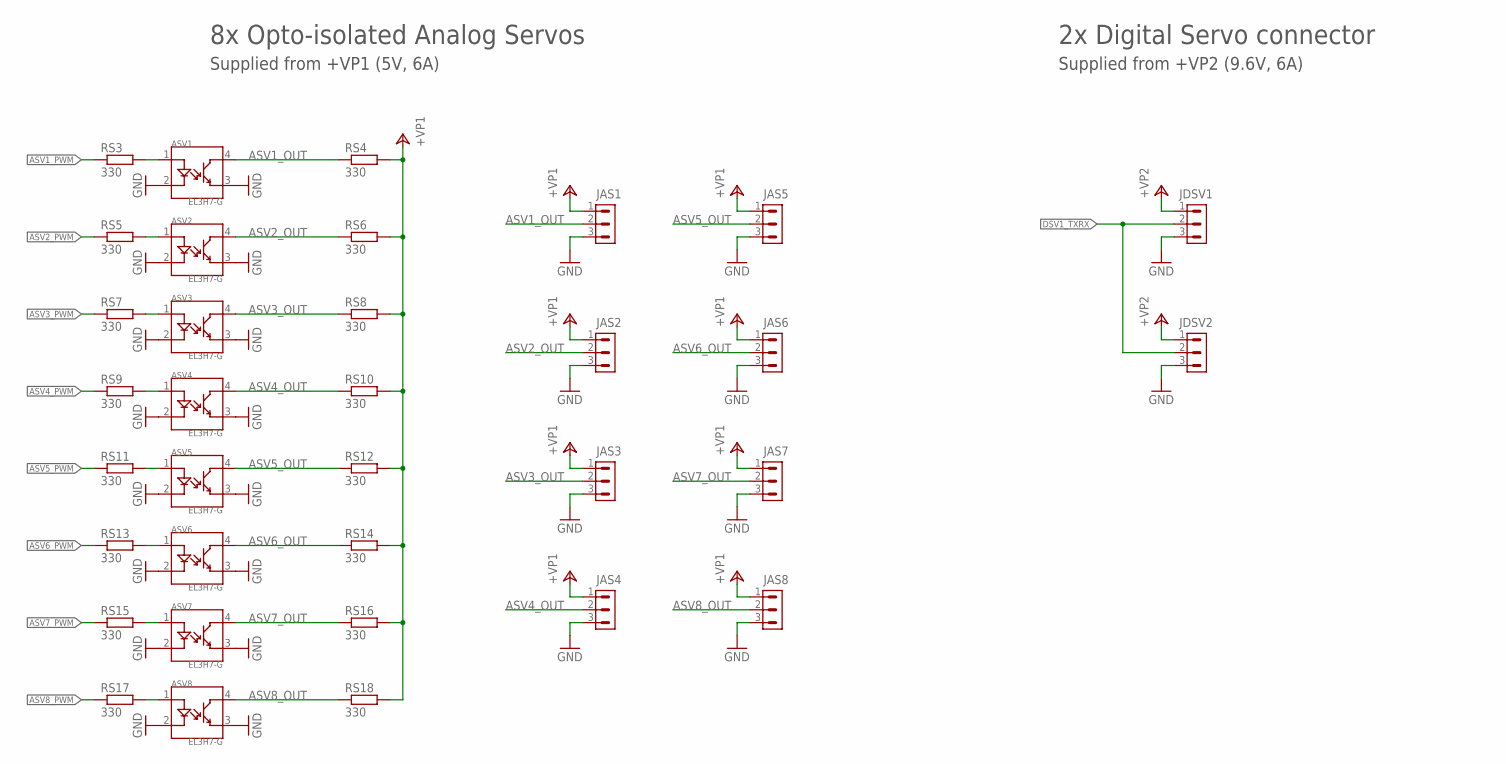
[picture p25: schematic microBoard_power.sch, sheet 6, Servos]

Parts:
ASV1, ASV2, ASV3, ASV4, ASV5, ASV6, ASV7, ASV8: EL3H7-G; SSOP_4
JAS1, JAS2, JAS3, JAS4, JAS5, JAS6, JAS7, JAS8: HE14_H_3
JDSV1, JDSV2: HE14_H_3
RS3, RS4, RS5, RS6, RS7, RS8, RS9, RS10, RS11, RS12, RS13, RS14, RS15, RS16, RS17, RS18: 330; R0603

Connections:
+VP1: JAS1.1, JAS2.1, JAS3.1, JAS4.1, JAS5.1, JAS6.1, JAS7.1, JAS8.1, RS4.2, RS6.2, RS8.2, RS10.2, RS12.2, RS14.2, RS16.2, RS18.2; also elsewhere on the board
+VP2: JDSV1.1, JDSV2.1; also elsewhere on the board
ASV1_OUT: ASV1.4, JAS1.2, RS4.1
ASV1_PWM: RS3.1; also elsewhere on the board
ASV2_OUT: ASV2.4, JAS2.2, RS6.1
ASV2_PWM: RS5.1; also elsewhere on the board
ASV3_OUT: ASV3.4, JAS3.2, RS8.1
ASV3_PWM: RS7.1; also elsewhere on the board
ASV4_OUT: ASV4.4, JAS4.2, RS10.1
ASV4_PWM: RS9.1; also elsewhere on the board
ASV5_OUT: ASV5.4, JAS5.2, RS12.1
ASV5_PWM: RS11.1; also elsewhere on the board
ASV6_OUT: ASV6.4, JAS6.2, RS14.1
ASV6_PWM: RS13.1; also elsewhere on the board
ASV7_OUT: ASV7.4, JAS7.2, RS16.1
ASV7_PWM: RS15.1; also elsewhere on the board
ASV8_OUT: ASV8.4, JAS8.2, RS18.1
ASV8_PWM: RS17.1; also elsewhere on the board
DSV1_TXRX: JDSV1.2, JDSV2.2; also elsewhere on the board
GND: ASV1.2, ASV1.3, ASV2.2, ASV2.3, ASV3.2, ASV3.3, ASV4.2, ASV4.3, ASV5.2, ASV5.3, ASV6.2, ASV6.3, ASV7.2, ASV7.3, ASV8.2, ASV8.3, JAS1.3, JAS2.3, JAS3.3, JAS4.3, JAS5.3, JAS6.3, JAS7.3, JAS8.3, JDSV1.3, JDSV2.3; also elsewhere on the board
unnamed: ASV1.1, RS3.2
unnamed: ASV2.1, RS5.2
unnamed: ASV3.1, RS7.2
unnamed: ASV4.1, RS9.2
unnamed: ASV5.1, RS11.2
unnamed: ASV6.1, RS13.2
unnamed: ASV7.1, RS15.2
unnamed: ASV8.1, RS17.2

Notes on the sheet:
8x Opto-isolated Analog Servos
Supplied from +VP1 (5V, 6A)
2x Digital Servo connector
Supplied from +VP2 (9.6V, 6A)

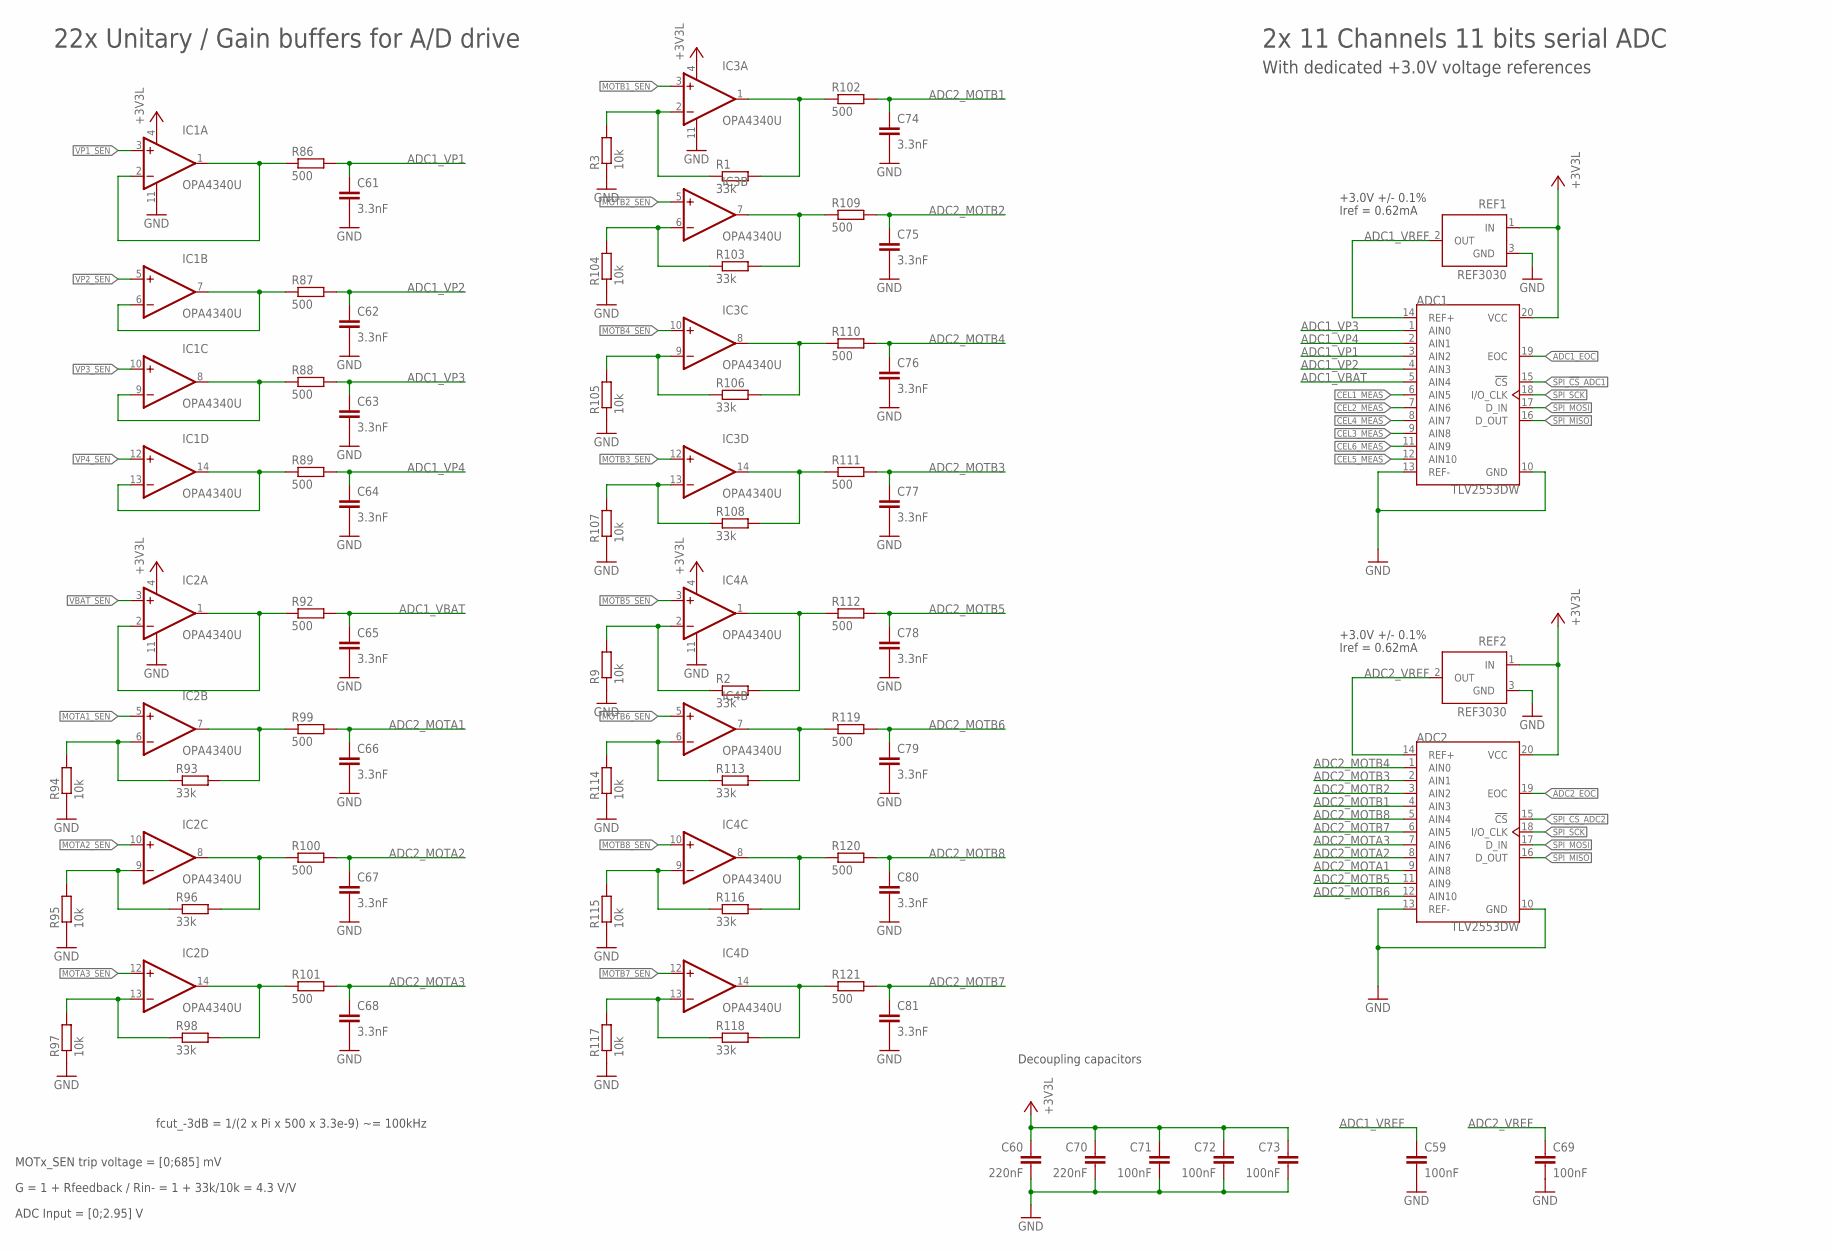
[picture p26: schematic microBoard_power.sch, sheet 7, ADC]

Parts:
ADC1, ADC2: TLV2553DW; SSOP_20
C59, C69, C71, C72, C73: 100nF; C0603
C60, C70: 220nF; C0603
C61, C62, C63, C64, C65, C66, C67, C68, C74, C75, C76, C77, C78, C79, C80, C81: 3.3nF; C0603
IC1, IC2, IC3, IC4: OPA4340U; SO14
R1, R2, R93, R96, R98, R103, R106, R108, R113, R116, R118: 33k; R0603
R3, R9, R94, R95, R97, R104, R105, R107, R114, R115, R117: 10k; R0603
R86, R87, R88, R89, R92, R99, R100, R101, R102, R109, R110, R111, R112, R119, R120, R121: 500; R0603
REF1, REF2: REF3030; SOT23

Connections:
+3V3L: ADC1.20 (VCC), ADC2.20 (VCC), C60.1, C70.1, C71.1, C72.1, C73.1, IC1.4 (V+), IC2.4 (V+), IC3.4 (V+), IC4.4 (V+), REF1.1 (IN), REF2.1 (IN); also elsewhere on the board
ADC1_EOC: ADC1.19 (EOC); also elsewhere on the board
ADC1_VBAT: ADC1.5 (AIN4), C65.1, R92.2
ADC1_VP1: ADC1.3 (AIN2), C61.1, R86.2
ADC1_VP2: ADC1.4 (AIN3), C62.1, R87.2
ADC1_VP3: ADC1.1 (AIN0), C63.1, R88.2
ADC1_VP4: ADC1.2 (AIN1), C64.1, R89.2
ADC1_VREF: ADC1.14 (REF+), C59.1, REF1.2 (OUT)
ADC2_EOC: ADC2.19 (EOC); also elsewhere on the board
ADC2_MOTA1: ADC2.9 (AIN8), C66.1, R99.2
ADC2_MOTA2: ADC2.8 (AIN7), C67.1, R100.2
ADC2_MOTA3: ADC2.7 (AIN6), C68.1, R101.2
ADC2_MOTB1: ADC2.4 (AIN3), C74.1, R102.2
ADC2_MOTB2: ADC2.3 (AIN2), C75.1, R109.2
ADC2_MOTB3: ADC2.2 (AIN1), C77.1, R111.2
ADC2_MOTB4: ADC2.1 (AIN0), C76.1, R110.2
ADC2_MOTB5: ADC2.11 (AIN9), C78.1, R112.2
ADC2_MOTB6: ADC2.12 (AIN10), C79.1, R119.2
ADC2_MOTB7: ADC2.6 (AIN5), C81.1, R121.2
ADC2_MOTB8: ADC2.5 (AIN4), C80.1, R120.2
ADC2_VREF: ADC2.14 (REF+), C69.1, REF2.2 (OUT)
CEL1_MEAS: ADC1.6 (AIN5); also elsewhere on the board
CEL2_MEAS: ADC1.7 (AIN6); also elsewhere on the board
CEL3_MEAS: ADC1.9 (AIN8); also elsewhere on the board
CEL4_MEAS: ADC1.8 (AIN7); also elsewhere on the board
CEL5_MEAS: ADC1.12 (AIN10); also elsewhere on the board
CEL6_MEAS: ADC1.11 (AIN9); also elsewhere on the board
GND: ADC1.10 (GND), ADC1.13 (REF-), ADC2.10 (GND), ADC2.13 (REF-), C59.2, C60.2, C61.2, C62.2, C63.2, C64.2, C65.2, C66.2, C67.2, C68.2, C69.2, C70.2, C71.2, C72.2, C73.2, C74.2, C75.2, C76.2, C77.2, C78.2, C79.2, C80.2, C81.2, IC1.11 (V-), IC2.11 (V-), IC3.11 (V-), IC4.11 (V-), R3.1, R9.1, R94.1, R95.1, R97.1, R104.1, R105.1, R107.1, R114.1, R115.1, R117.1, REF1.3 (GND), REF2.3 (GND); also elsewhere on the board
MOTA1_SEN: IC2.5 (+IN); also elsewhere on the board
MOTA2_SEN: IC2.10 (+IN); also elsewhere on the board
MOTA3_SEN: IC2.12 (+IN); also elsewhere on the board
MOTB1_SEN: IC3.3 (+IN); also elsewhere on the board
MOTB2_SEN: IC3.5 (+IN); also elsewhere on the board
MOTB3_SEN: IC3.12 (+IN); also elsewhere on the board
MOTB4_SEN: IC3.10 (+IN); also elsewhere on the board
MOTB5_SEN: IC4.3 (+IN); also elsewhere on the board
MOTB6_SEN: IC4.5 (+IN); also elsewhere on the board
MOTB7_SEN: IC4.12 (+IN); also elsewhere on the board
MOTB8_SEN: IC4.10 (+IN); also elsewhere on the board
unnamed: IC3.2 (-IN), R1.1, R3.2
unnamed: IC4.2 (-IN), R2.1, R9.2
unnamed: IC1.6 (-IN), IC1.7 (OUT), R87.1
unnamed: IC1.8 (OUT), IC1.9 (-IN), R88.1
unnamed: IC1.13 (-IN), IC1.14 (OUT), R89.1
unnamed: IC1.1 (OUT), IC1.2 (-IN), R86.1
unnamed: IC2.1 (OUT), IC2.2 (-IN), R92.1
unnamed: IC2.7 (OUT), R93.2, R99.1
unnamed: IC2.8 (OUT), R96.2, R100.1
unnamed: IC2.14 (OUT), R98.2, R101.1
unnamed: IC2.6 (-IN), R93.1, R94.2
unnamed: IC2.9 (-IN), R95.2, R96.1
unnamed: IC2.13 (-IN), R97.2, R98.1
unnamed: IC3.1 (OUT), R1.2, R102.1
unnamed: IC3.7 (OUT), R103.2, R109.1
unnamed: IC3.8 (OUT), R106.2, R110.1
unnamed: IC3.14 (OUT), R108.2, R111.1
unnamed: IC3.6 (-IN), R103.1, R104.2
unnamed: IC3.9 (-IN), R105.2, R106.1
unnamed: IC3.13 (-IN), R107.2, R108.1
unnamed: IC4.1 (OUT), R2.2, R112.1
unnamed: IC4.7 (OUT), R113.2, R119.1
unnamed: IC4.8 (OUT), R116.2, R120.1
unnamed: IC4.14 (OUT), R118.2, R121.1
unnamed: IC4.6 (-IN), R113.1, R114.2
unnamed: IC4.9 (-IN), R115.2, R116.1
unnamed: IC4.13 (-IN), R117.2, R118.1
SPI_!CS!_ADC1: ADC1.15 (!CS!); also elsewhere on the board
SPI_!CS!_ADC2: ADC2.15 (!CS!); also elsewhere on the board
SPI_MISO: ADC1.16 (D_OUT), ADC2.16 (D_OUT); also elsewhere on the board
SPI_MOSI: ADC1.17 (D_IN), ADC2.17 (D_IN); also elsewhere on the board
SPI_SCK: ADC1.18 (I/O_CLK), ADC2.18 (I/O_CLK); also elsewhere on the board
VBAT_SEN: IC2.3 (+IN); also elsewhere on the board
VP1_SEN: IC1.3 (+IN); also elsewhere on the board
VP2_SEN: IC1.5 (+IN); also elsewhere on the board
VP3_SEN: IC1.10 (+IN); also elsewhere on the board
VP4_SEN: IC1.12 (+IN); also elsewhere on the board

Notes on the sheet:
+3.0V +/- 0.1%
Iref = 0.62mA
Decoupling capacitors
fcut_-3dB = 1/(2 x Pi x 500 x 3.3e-9) ~= 100kHz
G = 1 + Rfeedback / Rin- = 1 + 33k/10k = 4.3 V/V
MOTx_SEN trip voltage = [0;685] mV
ADC Input = [0;2.95] V
22x Unitary / Gain buffers for A/D drive
2x 11 Channels 11 bits serial ADC
With dedicated +3.0V voltage references
