I-Grebot/elec_microboard/src/Power/microBoard_power.brd

## EAGLE design src/Power/microBoard_power.brd (continued)

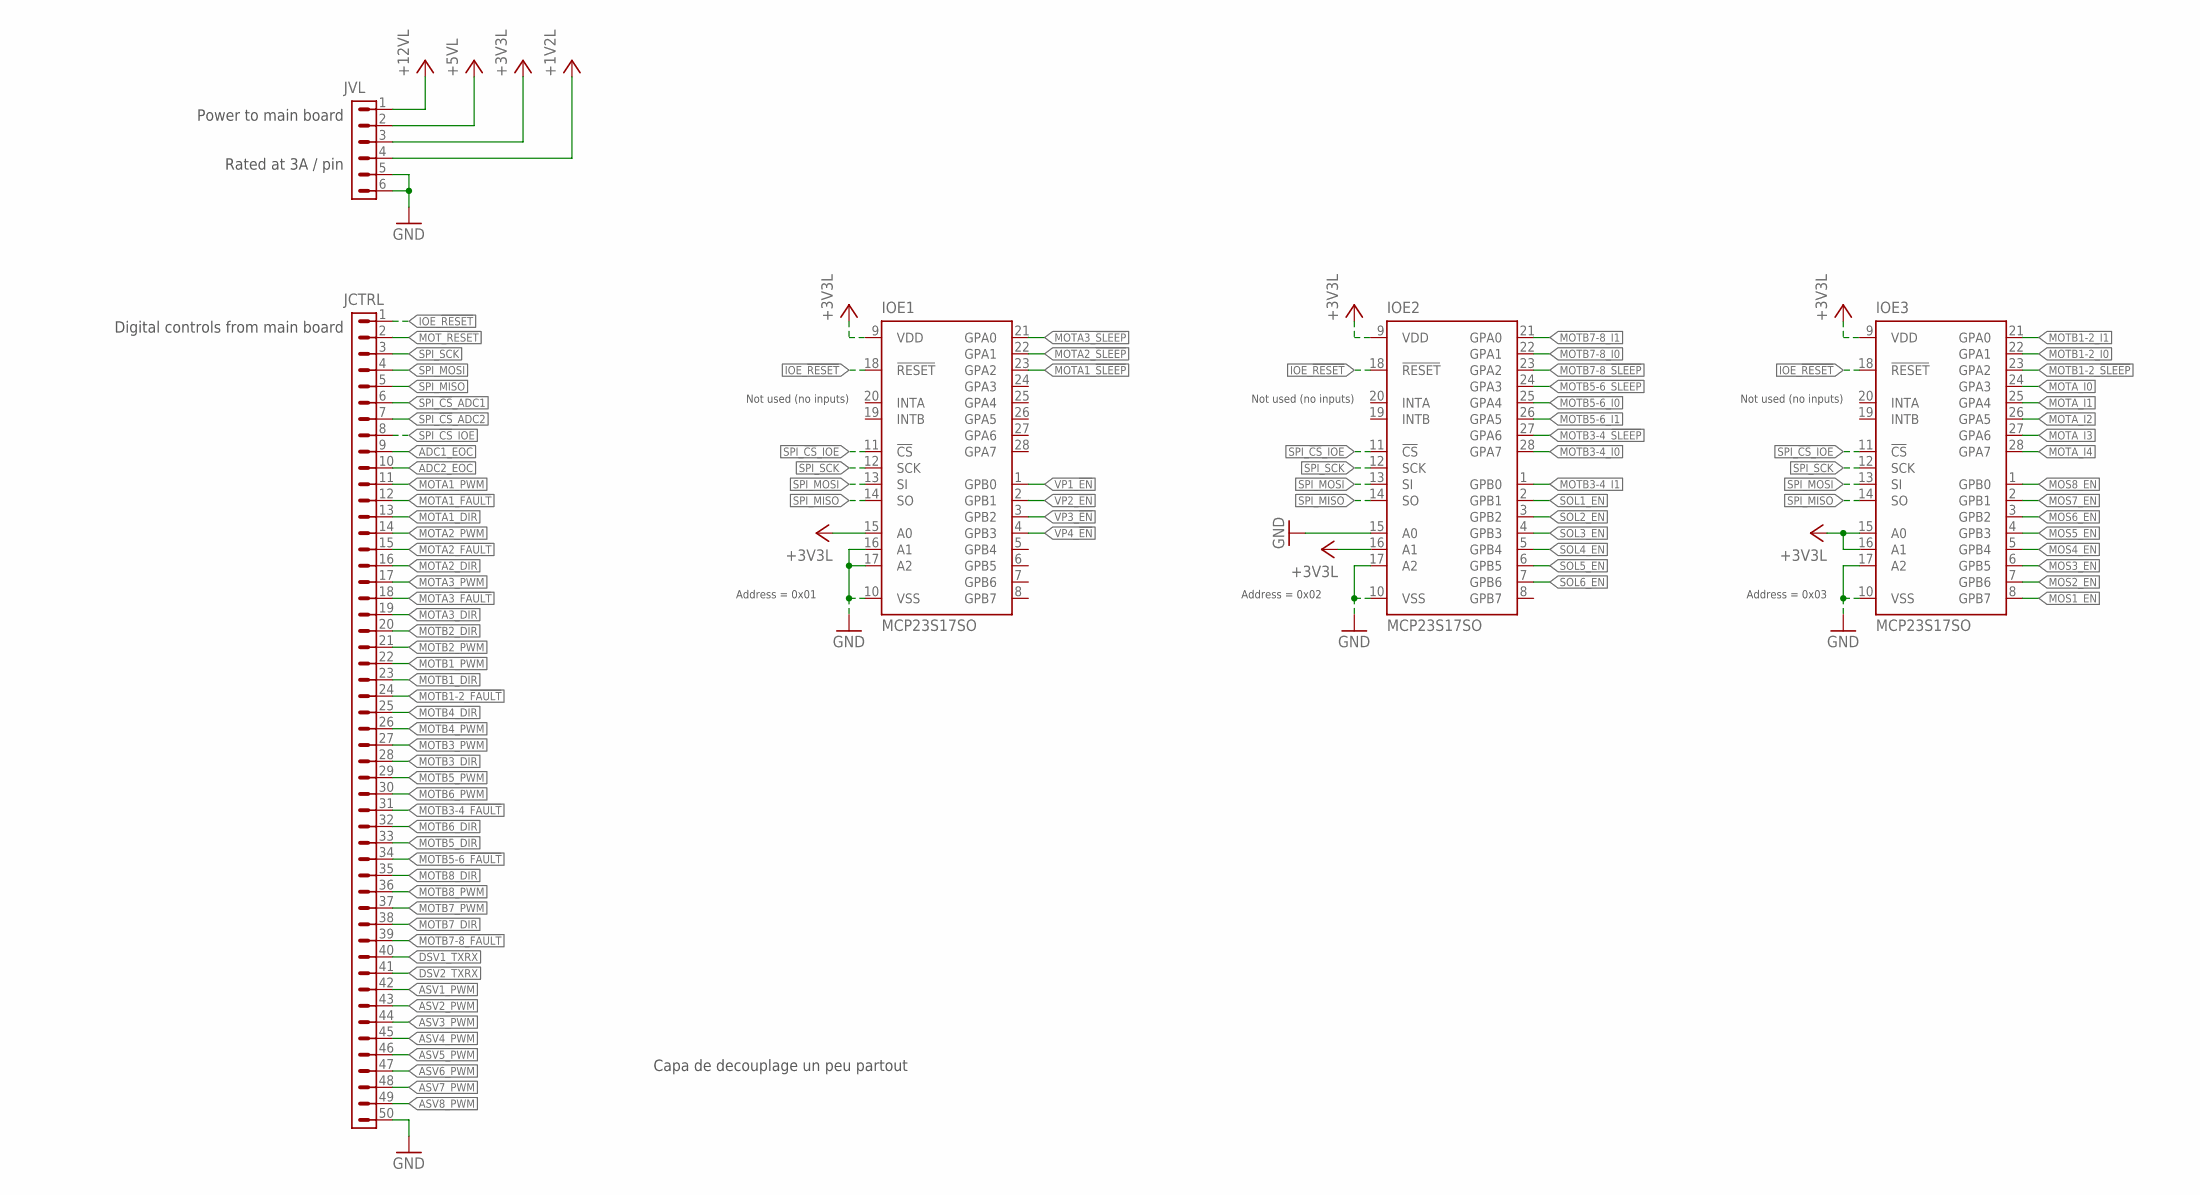
[picture p27: schematic microBoard_power.sch, sheet 8, Main board interface]

Parts:
IOE1, IOE2, IOE3: MCP23S17SO; SO28W
JCTRL: FFC-0.5_50; FFC-SMD-0.5_50
JVL: HE14_H_6

Connections:
+1V2L: JVL.4; also elsewhere on the board
+3V3L: IOE1.9 (VDD), IOE1.15 (A0), IOE2.9 (VDD), IOE2.16 (A1), IOE3.9 (VDD), IOE3.15 (A0), IOE3.16 (A1), JVL.3; also elsewhere on the board
+5VL: JVL.2; also elsewhere on the board
+12VL: JVL.1; also elsewhere on the board
ADC1_EOC: JCTRL.9; also elsewhere on the board
ADC2_EOC: JCTRL.10; also elsewhere on the board
ASV1_PWM: JCTRL.42; also elsewhere on the board
ASV2_PWM: JCTRL.43; also elsewhere on the board
ASV3_PWM: JCTRL.44; also elsewhere on the board
ASV4_PWM: JCTRL.45; also elsewhere on the board
ASV5_PWM: JCTRL.46; also elsewhere on the board
ASV6_PWM: JCTRL.47; also elsewhere on the board
ASV7_PWM: JCTRL.48; also elsewhere on the board
ASV8_PWM: JCTRL.49; also elsewhere on the board
DSV1_TXRX: JCTRL.40; also elsewhere on the board
DSV2_TXRX: JCTRL.41
GND: IOE1.10 (VSS), IOE1.16 (A1), IOE1.17 (A2), IOE2.10 (VSS), IOE2.15 (A0), IOE2.17 (A2), IOE3.10 (VSS), IOE3.17 (A2), JCTRL.50, JVL.5, JVL.6; also elsewhere on the board
IOE_!RESET!: IOE1.18 (!RESET), IOE2.18 (!RESET), IOE3.18 (!RESET), JCTRL.1
MOS1_EN: IOE3.8 (GPB7); also elsewhere on the board
MOS2_EN: IOE3.7 (GPB6); also elsewhere on the board
MOS3_EN: IOE3.6 (GPB5); also elsewhere on the board
MOS4_EN: IOE3.5 (GPB4); also elsewhere on the board
MOS5_EN: IOE3.4 (GPB3); also elsewhere on the board
MOS6_EN: IOE3.3 (GPB2); also elsewhere on the board
MOS7_EN: IOE3.2 (GPB1); also elsewhere on the board
MOS8_EN: IOE3.1 (GPB0); also elsewhere on the board
MOTA1_!FAULT!: JCTRL.12; also elsewhere on the board
MOTA1_!SLEEP!: IOE1.23 (GPA2); also elsewhere on the board
MOTA1_DIR: JCTRL.13; also elsewhere on the board
MOTA1_PWM: JCTRL.11; also elsewhere on the board
MOTA2_!FAULT!: JCTRL.15; also elsewhere on the board
MOTA2_!SLEEP!: IOE1.22 (GPA1); also elsewhere on the board
MOTA2_DIR: JCTRL.16; also elsewhere on the board
MOTA2_PWM: JCTRL.14; also elsewhere on the board
MOTA3_!FAULT!: JCTRL.18; also elsewhere on the board
MOTA3_!SLEEP!: IOE1.21 (GPA0); also elsewhere on the board
MOTA3_DIR: JCTRL.19; also elsewhere on the board
MOTA3_PWM: JCTRL.17; also elsewhere on the board
MOTA_I0: IOE3.24 (GPA3); also elsewhere on the board
MOTA_I1: IOE3.25 (GPA4); also elsewhere on the board
MOTA_I2: IOE3.26 (GPA5); also elsewhere on the board
MOTA_I3: IOE3.27 (GPA6); also elsewhere on the board
MOTA_I4: IOE3.28 (GPA7); also elsewhere on the board
MOTB1-2_!FAULT!: JCTRL.24; also elsewhere on the board
MOTB1-2_!SLEEP!: IOE3.23 (GPA2); also elsewhere on the board
MOTB1-2_I0: IOE3.22 (GPA1); also elsewhere on the board
MOTB1-2_I1: IOE3.21 (GPA0); also elsewhere on the board
MOTB1_DIR: JCTRL.23; also elsewhere on the board
MOTB1_PWM: JCTRL.22; also elsewhere on the board
MOTB2_DIR: JCTRL.20; also elsewhere on the board
MOTB2_PWM: JCTRL.21; also elsewhere on the board
MOTB3-4_!FAULT!: JCTRL.31; also elsewhere on the board
MOTB3-4_!SLEEP!: IOE2.27 (GPA6); also elsewhere on the board
MOTB3-4_I0: IOE2.28 (GPA7); also elsewhere on the board
MOTB3-4_I1: IOE2.1 (GPB0); also elsewhere on the board
MOTB3_DIR: JCTRL.28; also elsewhere on the board
MOTB3_PWM: JCTRL.27; also elsewhere on the board
MOTB4_DIR: JCTRL.25; also elsewhere on the board
MOTB4_PWM: JCTRL.26; also elsewhere on the board
MOTB5-6_!FAULT!: JCTRL.34; also elsewhere on the board
MOTB5-6_!SLEEP!: IOE2.24 (GPA3); also elsewhere on the board
MOTB5-6_I0: IOE2.25 (GPA4); also elsewhere on the board
MOTB5-6_I1: IOE2.26 (GPA5); also elsewhere on the board
MOTB5_DIR: JCTRL.33; also elsewhere on the board
MOTB5_PWM: JCTRL.29; also elsewhere on the board
MOTB6_DIR: JCTRL.32; also elsewhere on the board
MOTB6_PWM: JCTRL.30; also elsewhere on the board
MOTB7-8_!FAULT!: JCTRL.39; also elsewhere on the board
MOTB7-8_!SLEEP!: IOE2.23 (GPA2); also elsewhere on the board
MOTB7-8_I0: IOE2.22 (GPA1); also elsewhere on the board
MOTB7-8_I1: IOE2.21 (GPA0); also elsewhere on the board
MOTB7_DIR: JCTRL.38; also elsewhere on the board
MOTB7_PWM: JCTRL.37; also elsewhere on the board
MOTB8_DIR: JCTRL.35; also elsewhere on the board
MOTB8_PWM: JCTRL.36; also elsewhere on the board
MOT_!RESET!: JCTRL.2; also elsewhere on the board
SOL1_EN: IOE2.2 (GPB1); also elsewhere on the board
SOL2_EN: IOE2.3 (GPB2); also elsewhere on the board
SOL3_EN: IOE2.4 (GPB3); also elsewhere on the board
SOL4_EN: IOE2.5 (GPB4); also elsewhere on the board
SOL5_EN: IOE2.6 (GPB5); also elsewhere on the board
SOL6_EN: IOE2.7 (GPB6); also elsewhere on the board
SPI_!CS!_ADC1: JCTRL.6; also elsewhere on the board
SPI_!CS!_ADC2: JCTRL.7; also elsewhere on the board
SPI_!CS!_IOE: IOE1.11 (!CS), IOE2.11 (!CS), IOE3.11 (!CS), JCTRL.8
SPI_MISO: IOE1.14 (SO), IOE2.14 (SO), IOE3.14 (SO), JCTRL.5; also elsewhere on the board
SPI_MOSI: IOE1.13 (SI), IOE2.13 (SI), IOE3.13 (SI), JCTRL.4; also elsewhere on the board
SPI_SCK: IOE1.12 (SCK), IOE2.12 (SCK), IOE3.12 (SCK), JCTRL.3; also elsewhere on the board
VP1_!EN!: IOE1.1 (GPB0); also elsewhere on the board
VP2_!EN!: IOE1.2 (GPB1); also elsewhere on the board
VP3_!EN!: IOE1.3 (GPB2); also elsewhere on the board
VP4_!EN!: IOE1.4 (GPB3); also elsewhere on the board

Notes on the sheet:
Not used (no inputs)
Power to main board
Rated at 3A / pin
Digital controls from main board
Address = 0x01
Address = 0x02
Address = 0x03
Capa de decouplage un peu partout

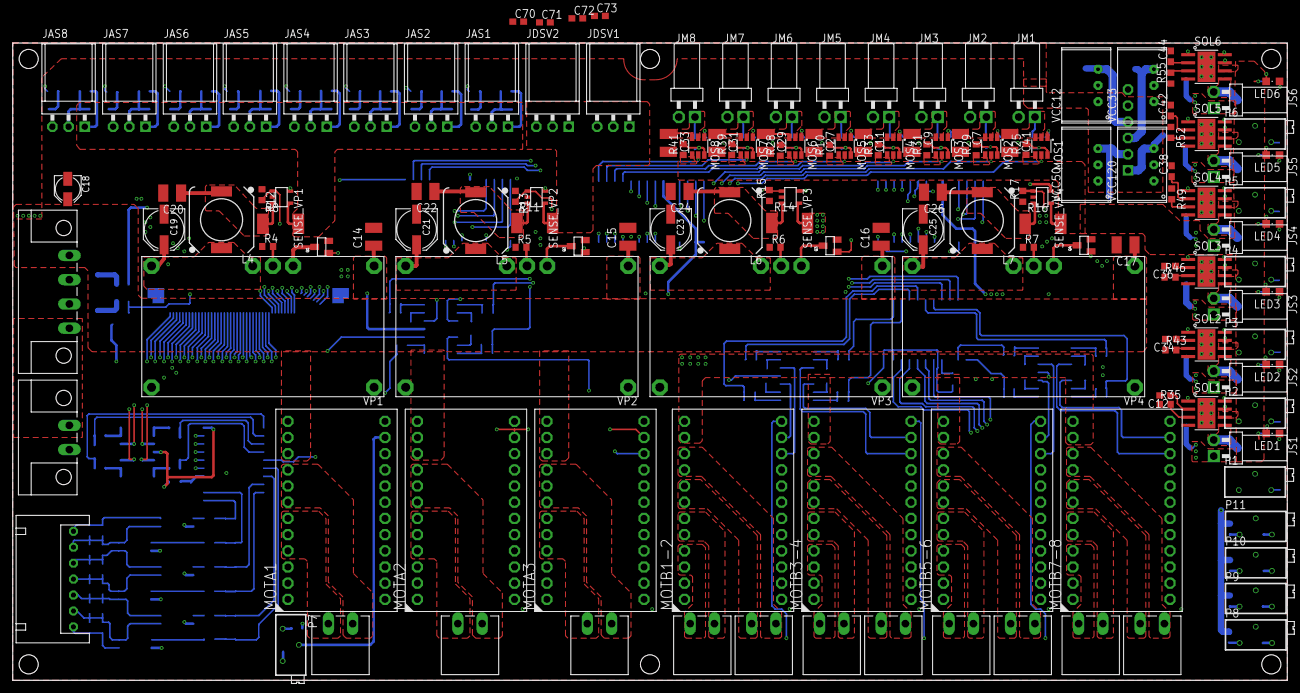
[picture p28: board microBoard_power.brd from above]

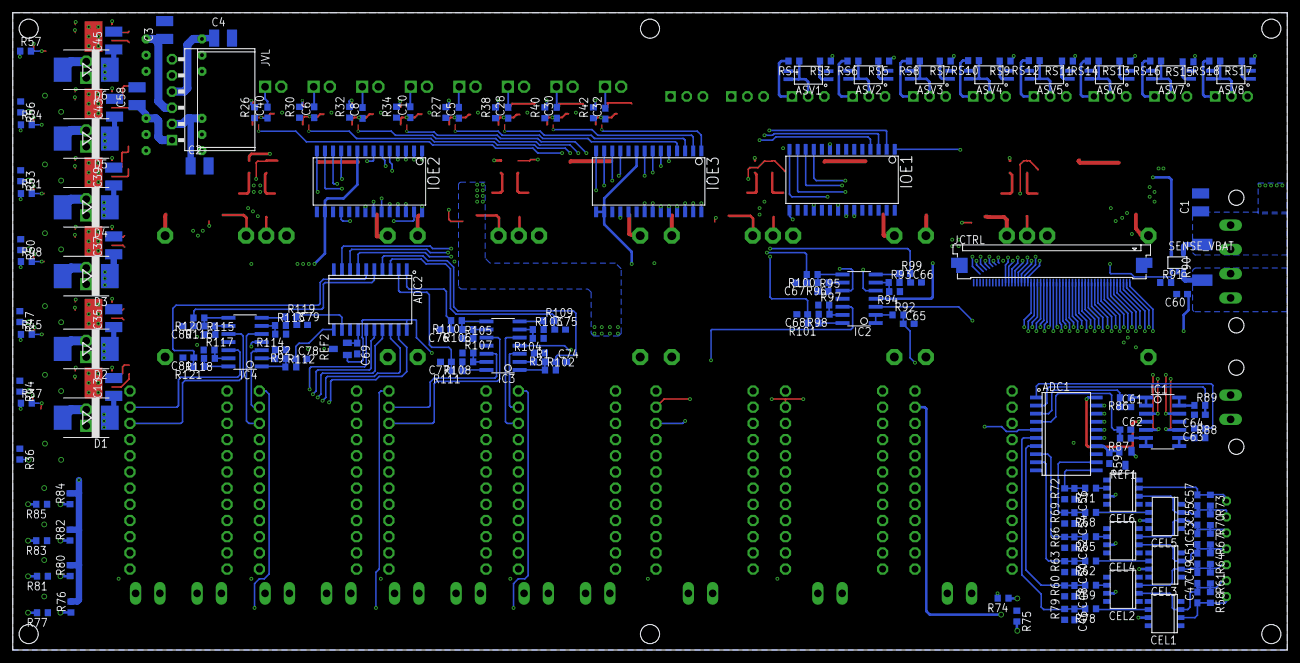
[picture p29: board microBoard_power.brd from below]

Board: 4 copper layers, 200.0 x 100.0 mm, 341 parts (188 on the bottom side), 314 nets.
