I-Grebot/elec_microboard/src/_old/microBoard.brd

## EAGLE design src/_old/microBoard.brd (2016-11-11, an earlier design)

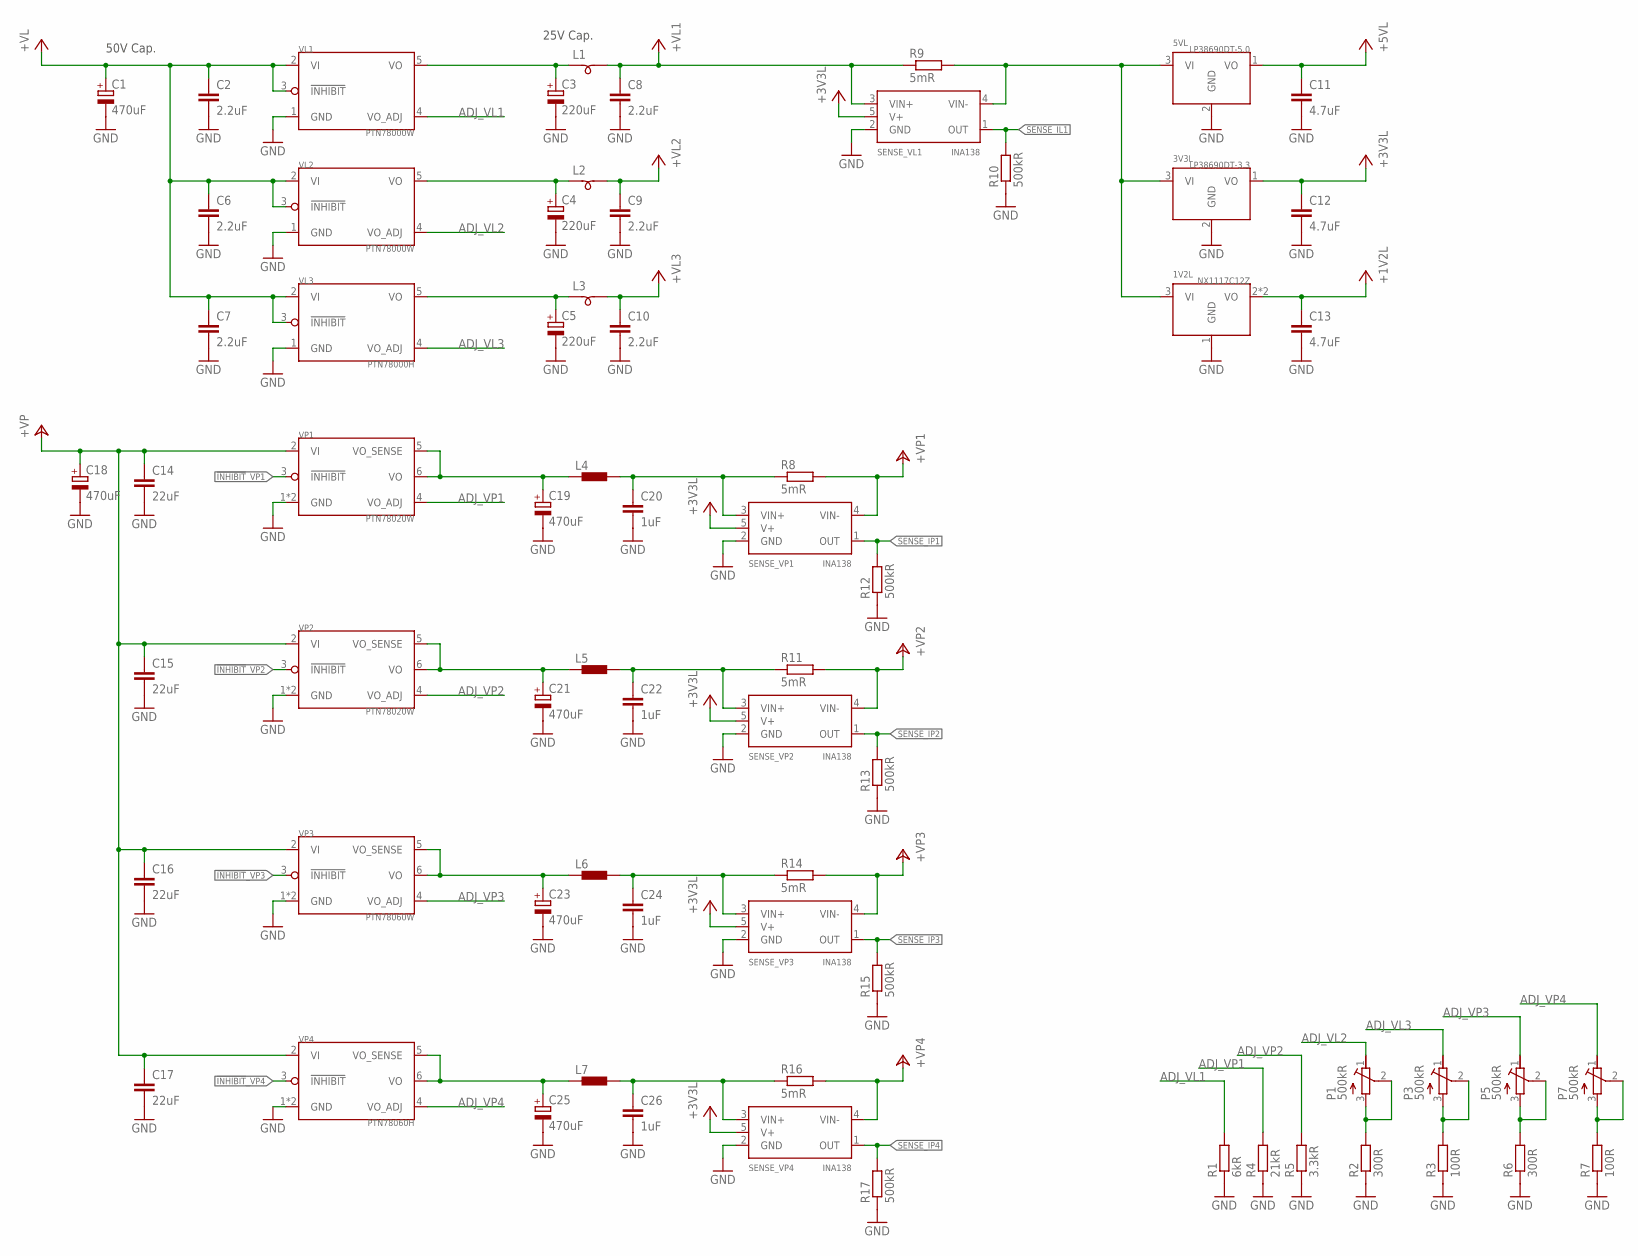
[picture p30: schematic microBoard.sch, sheet 1, Power supplies]

Parts:
1V2L: NX1117C12Z; SOT_223
3V3L: LP38690DT-3.3; NDP_0003B
5VL: LP38690DT-5.0; NDP_0003B
C1, C18: 470uF; PANASONIC_B
C2, C6, C7, C8, C9, C10: 2.2uF; C3225
C3, C4, C5: 220uF; PANASONIC_B
C11, C12, C13: 4.7uF; C3225
C14, C15, C16, C17: 22uF; C3225
C19, C21, C23, C25: 470uF; PANASONIC_D
C20, C22, C24, C26: 1uF; C3225
L1, L2, L3: SM-B9
L4, L5, L6, L7: DR1030
P1, P3, P5, P7: 500kR; RTRIMT93XB
R1: 6kR; R0603
R2, R6: 300R; R0603
R3, R7: 100R; R0603
R4: 21kR; R0603
R5: 3.3kR; R0603
R8, R9, R11, R14, R16: 5mR; R2512
R10, R12, R13, R15, R17: 500kR; R0603
SENSE_VL1: INA138; DBV_05
SENSE_VP1, SENSE_VP2, SENSE_VP3, SENSE_VP4: INA138; DBV_05
VL1, VL2: PTN78000W; PTN78000
VL3: PTN78000H; PTN78000
VP1, VP2: PTN78020W; PTN78020
VP3: PTN78060W; PTN78060
VP4: PTN78060H; PTN78060

Connections:
!INHIBIT!_VP1: VP1.3 (!INHIBIT!)
!INHIBIT!_VP2: VP2.3 (!INHIBIT!)
!INHIBIT!_VP3: VP3.3 (!INHIBIT!)
!INHIBIT!_VP4: VP4.3 (!INHIBIT!)
+1V2L: 1V2L.2 (VO), 1V2L.4 (VO), C13.1; also elsewhere on the board
+3V3L: 3V3L.1 (VO), C12.1, SENSE_VL1.5 (V+), SENSE_VP1.5 (V+), SENSE_VP2.5 (V+), SENSE_VP3.5 (V+), SENSE_VP4.5 (V+); also elsewhere on the board
+5VL: 5VL.1 (VO), C11.1; also elsewhere on the board
+VL: C1.+, C2.1, C6.1, C7.1, VL1.2 (VI), VL1.3 (!INHIBIT!), VL2.2 (VI), VL2.3 (!INHIBIT!), VL3.2 (VI), VL3.3 (!INHIBIT!)
+VL1: C8.1, L1.2, R9.1, SENSE_VL1.3 (VIN+)
+VL2: C9.1, L2.2; also elsewhere on the board
+VL3: C10.1, L3.2
+VP: C14.1, C15.1, C16.1, C17.1, C18.+, VP1.2 (VI), VP2.2 (VI), VP3.2 (VI), VP4.2 (VI); also elsewhere on the board
+VP1: R8.2, SENSE_VP1.4 (VIN-); also elsewhere on the board
+VP2: R11.2, SENSE_VP2.4 (VIN-)
+VP3: R14.2, SENSE_VP3.4 (VIN-); also elsewhere on the board
+VP4: R16.2, SENSE_VP4.4 (VIN-); also elsewhere on the board
ADJ_VL1: R1.2, VL1.4 (VO_ADJ)
ADJ_VL2: P1.1 (A), VL2.4 (VO_ADJ)
ADJ_VL3: P3.1 (A), VL3.4 (VO_ADJ)
ADJ_VP1: R4.2, VP1.4 (VO_ADJ)
ADJ_VP2: R5.2, VP2.4 (VO_ADJ)
ADJ_VP3: P5.1 (A), VP3.4 (VO_ADJ)
ADJ_VP4: P7.1 (A), VP4.4 (VO_ADJ)
GND: 1V2L.1 (GND), 3V3L.2 (GND), 5VL.2 (GND), C1.-, C2.2, C3.-, C4.-, C5.-, C6.2, C7.2, C8.2, C9.2, C10.2, C11.2, C12.2, C13.2, C14.2, C15.2, C16.2, C17.2, C18.-, C19.-, C20.2, C21.-, C22.2, C23.-, C24.2, C25.-, C26.2, R1.1, R2.1, R3.1, R4.1, R5.1, R6.1, R7.1, R10.1, R12.1, R13.1, R15.1, R17.1, SENSE_VL1.2 (GND), SENSE_VP1.2 (GND), SENSE_VP2.2 (GND), SENSE_VP3.2 (GND), SENSE_VP4.2 (GND), VL1.1 (GND), VL2.1 (GND), VL3.1 (GND), VP1.1 (GND), VP1.7 (GND), VP2.1 (GND), VP2.7 (GND), VP3.1 (GND), VP3.7 (GND), VP4.1 (GND), VP4.7 (GND); also elsewhere on the board
unnamed: C19.+, L4.1, VP1.5 (VO_SENSE), VP1.6 (VO)
unnamed: P1.2 (S), P1.3 (E), R2.2
unnamed: C20.1, L4.2, R8.1, SENSE_VP1.3 (VIN+)
unnamed: P3.2 (S), P3.3 (E), R3.2
unnamed: P5.2 (S), P5.3 (E), R6.2
unnamed: C21.+, L5.1, VP2.5 (VO_SENSE), VP2.6 (VO)
unnamed: C3.+, L1.1, VL1.5 (VO)
unnamed: C4.+, L2.1, VL2.5 (VO)
unnamed: C5.+, L3.1, VL3.5 (VO)
unnamed: P7.2 (S), P7.3 (E), R7.2
unnamed: C22.1, L5.2, R11.1, SENSE_VP2.3 (VIN+)
unnamed: C23.+, L6.1, VP3.5 (VO_SENSE), VP3.6 (VO)
unnamed: C24.1, L6.2, R14.1, SENSE_VP3.3 (VIN+)
unnamed: C25.+, L7.1, VP4.5 (VO_SENSE), VP4.6 (VO)
unnamed: C26.1, L7.2, R16.1, SENSE_VP4.3 (VIN+)
SENSE_IL1: R10.2, SENSE_VL1.1 (OUT); also elsewhere on the board
SENSE_IP1: R12.2, SENSE_VP1.1 (OUT); also elsewhere on the board
SENSE_IP2: R13.2, SENSE_VP2.1 (OUT); also elsewhere on the board
SENSE_IP3: R15.2, SENSE_VP3.1 (OUT); also elsewhere on the board
SENSE_IP4: R17.2, SENSE_VP4.1 (OUT); also elsewhere on the board
VS1: 1V2L.3 (VI), 3V3L.3 (VI), 5VL.3 (VI), R9.2, SENSE_VL1.4 (VIN-)

Notes on the sheet:
50V Cap.
25V Cap.

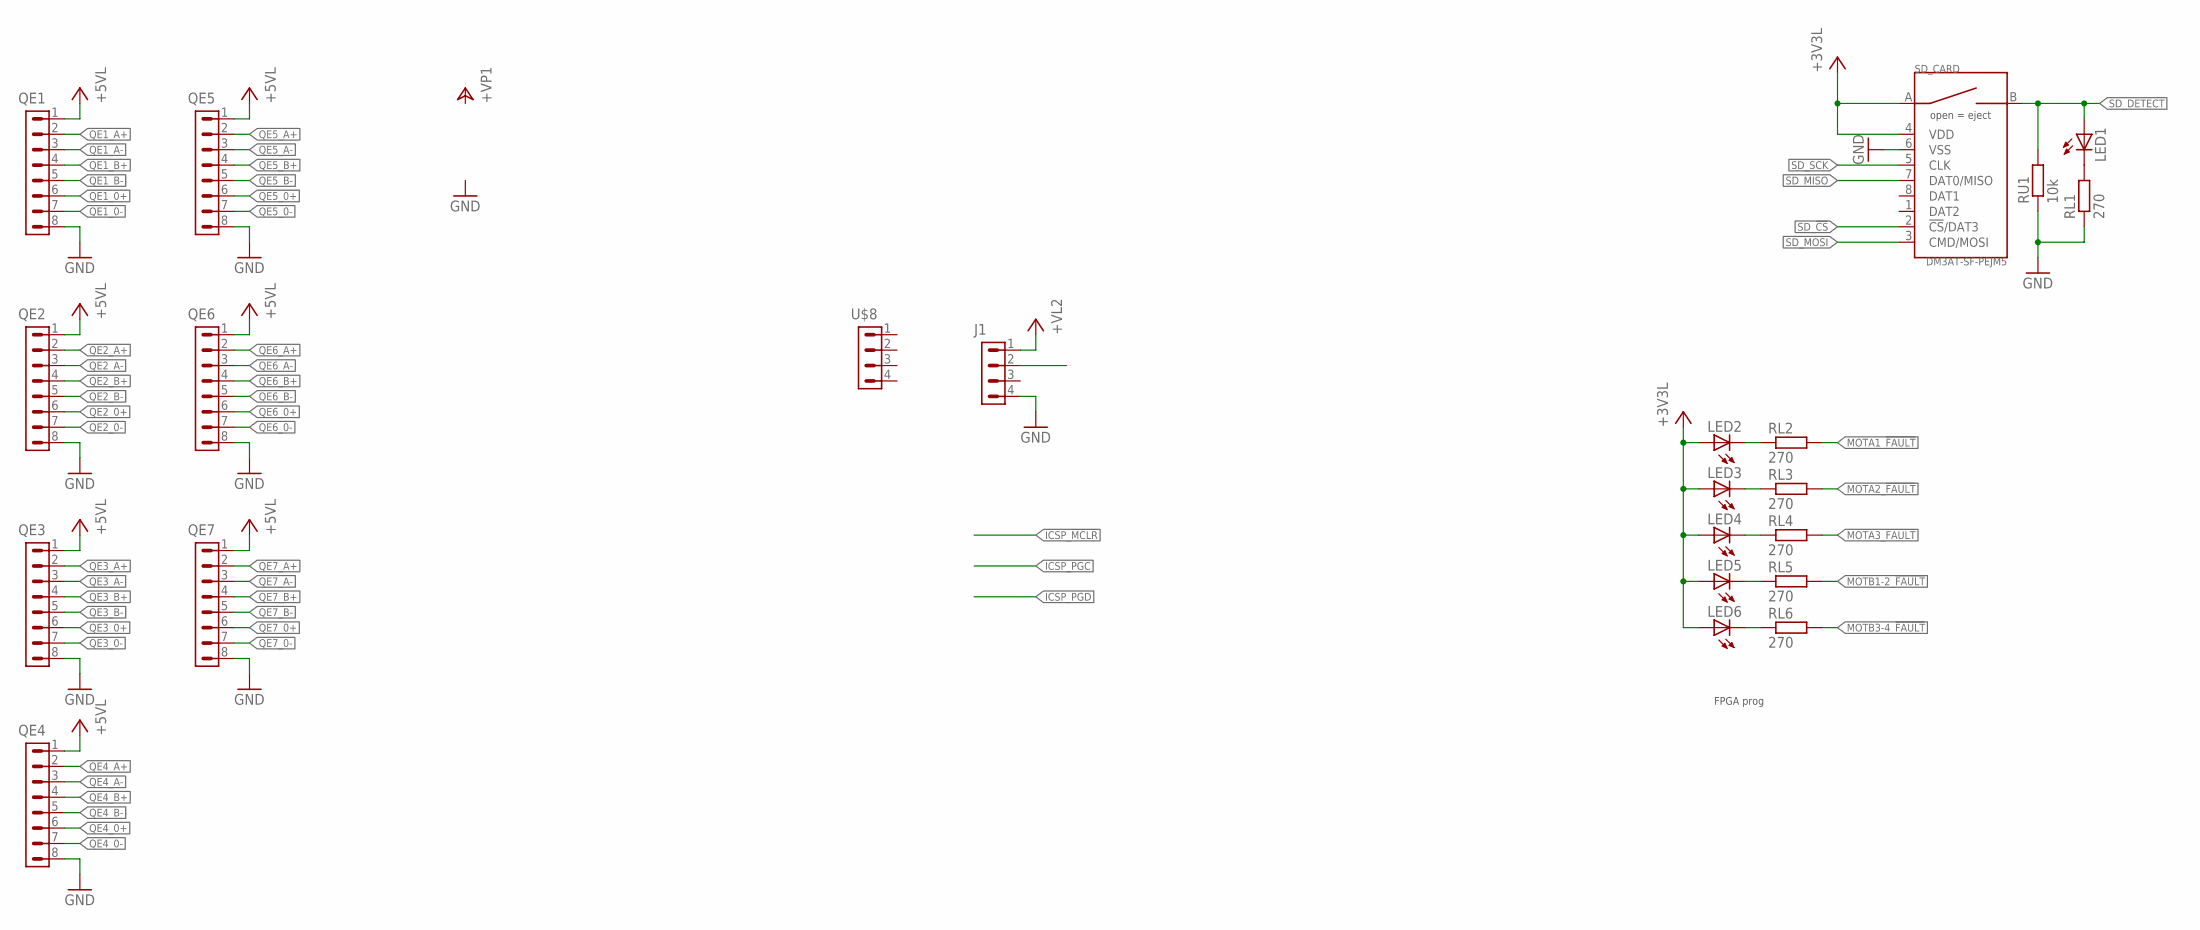
[picture p31: schematic microBoard.sch, sheet 2, Connectors & User-Interface]

Parts:
J1: CON_1.27_4
LED1, LED2, LED3, LED4, LED5, LED6: LEDCHIP-LED0805; CHIP-LED0805
QE1, QE2, QE3, QE4, QE5, QE6, QE7: CON_1.27_8
RL1, RL2, RL3, RL4, RL5, RL6: 270; R0603
RU1: 10k; R0603
SD_CARD: DM3AT-SF-PEJM5; DM3AT
U$8: CON_1.25_4

Connections:
+3V3L: LED2.A, LED3.A, LED4.A, LED5.A, LED6.A, SD_CARD.4 (VDD), SD_CARD.A; also elsewhere on the board
+5VL: QE1.1, QE2.1, QE3.1, QE4.1, QE5.1, QE6.1, QE7.1; also elsewhere on the board
+VL2: J1.1; also elsewhere on the board
GND: J1.4, QE1.8, QE2.8, QE3.8, QE4.8, QE5.8, QE6.8, QE7.8, RL1.1, RU1.1, SD_CARD.6 (VSS); also elsewhere on the board
MOTA1_!FAULT!: RL2.2; also elsewhere on the board
MOTA2_!FAULT!: RL3.2; also elsewhere on the board
MOTA3_!FAULT!: RL4.2; also elsewhere on the board
MOTB1-2_!FAULT!: RL5.2; also elsewhere on the board
MOTB3-4_!FAULT!: RL6.2; also elsewhere on the board
unnamed: LED1.C, RL1.2
unnamed: LED2.C, RL2.1
unnamed: LED3.C, RL3.1
unnamed: LED4.C, RL4.1
unnamed: LED5.C, RL5.1
unnamed: LED6.C, RL6.1
QE1_0+: QE1.6; also elsewhere on the board
QE1_0-: QE1.7; also elsewhere on the board
QE1_A+: QE1.2; also elsewhere on the board
QE1_A-: QE1.3; also elsewhere on the board
QE1_B+: QE1.4; also elsewhere on the board
QE1_B-: QE1.5; also elsewhere on the board
QE2_0+: QE2.6; also elsewhere on the board
QE2_0-: QE2.7; also elsewhere on the board
QE2_A+: QE2.2; also elsewhere on the board
QE2_A-: QE2.3; also elsewhere on the board
QE2_B+: QE2.4; also elsewhere on the board
QE2_B-: QE2.5; also elsewhere on the board
QE3_0+: QE3.6; also elsewhere on the board
QE3_0-: QE3.7; also elsewhere on the board
QE3_A+: QE3.2; also elsewhere on the board
QE3_A-: QE3.3; also elsewhere on the board
QE3_B+: QE3.4; also elsewhere on the board
QE3_B-: QE3.5; also elsewhere on the board
QE4_0+: QE4.6; also elsewhere on the board
QE4_0-: QE4.7; also elsewhere on the board
QE4_A+: QE4.2; also elsewhere on the board
QE4_A-: QE4.3; also elsewhere on the board
QE4_B+: QE4.4; also elsewhere on the board
QE4_B-: QE4.5; also elsewhere on the board
QE5_0+: QE5.6; also elsewhere on the board
QE5_0-: QE5.7; also elsewhere on the board
QE5_A+: QE5.2; also elsewhere on the board
QE5_A-: QE5.3; also elsewhere on the board
QE5_B+: QE5.4; also elsewhere on the board
QE5_B-: QE5.5; also elsewhere on the board
QE6_0+: QE6.6; also elsewhere on the board
QE6_0-: QE6.7; also elsewhere on the board
QE6_A+: QE6.2; also elsewhere on the board
QE6_A-: QE6.3; also elsewhere on the board
QE6_B+: QE6.4; also elsewhere on the board
QE6_B-: QE6.5; also elsewhere on the board
QE7_0+: QE7.6; also elsewhere on the board
QE7_0-: QE7.7; also elsewhere on the board
QE7_A+: QE7.2; also elsewhere on the board
QE7_A-: QE7.3; also elsewhere on the board
QE7_B+: QE7.4; also elsewhere on the board
QE7_B-: QE7.5; also elsewhere on the board
SD_!CS!: SD_CARD.2 (!CS!/DAT3); also elsewhere on the board
SD_DETECT: LED1.A, RU1.2, SD_CARD.B
SD_MISO: SD_CARD.7 (DAT0/MISO); also elsewhere on the board
SD_MOSI: SD_CARD.3 (CMD/MOSI); also elsewhere on the board
SD_SCK: SD_CARD.5 (CLK); also elsewhere on the board

Notes on the sheet:
FPGA prog

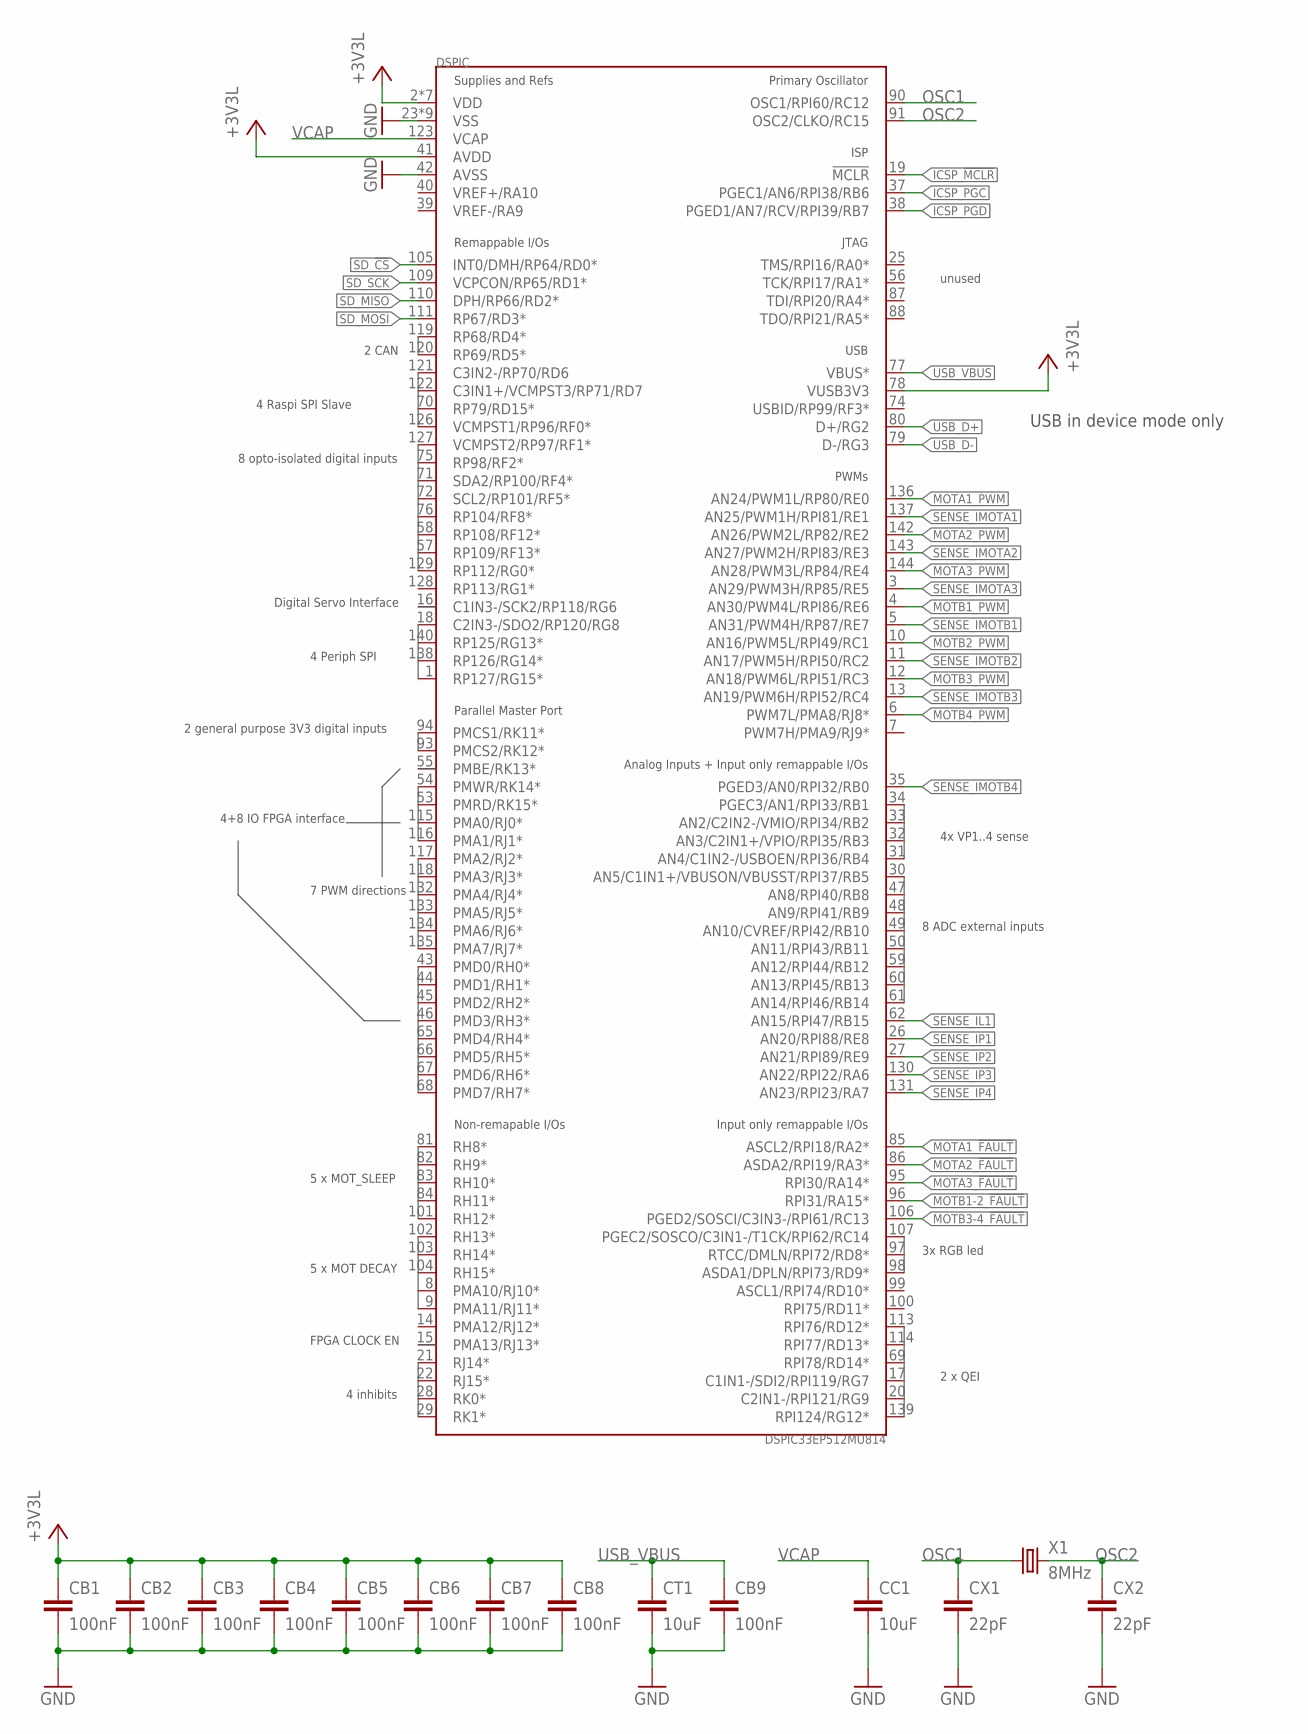
[picture p32: schematic microBoard.sch, sheet 3, µC dsPIC33E]

Parts:
CB1, CB2, CB3, CB4, CB5, CB6, CB7, CB8, CB9: 100nF; C0603
CC1: 10uF; C1210
CT1: 10uF; C1210
CX1, CX2: 22pF; C0603
DSPIC: DSPIC33EP512MU814; TQFP_144
X1: 8MHz; CTS406

Connections:
+3V3L: CB1.1, CB2.1, CB3.1, CB4.1, CB5.1, CB6.1, CB7.1, CB8.1, DSPIC.2 (VDD), DSPIC.24 (VDD), DSPIC.41 (AVDD), DSPIC.52 (VDD), DSPIC.64 (VDD), DSPIC.78 (VUSB3V3), DSPIC.89 (VDD), DSPIC.112 (VDD), DSPIC.124 (VDD); also elsewhere on the board
GND: CB1.2, CB2.2, CB3.2, CB4.2, CB5.2, CB6.2, CB7.2, CB8.2, CB9.2, CC1.2, CT1.2, CX1.2, CX2.2, DSPIC.23 (VSS), DSPIC.36 (VSS), DSPIC.42 (AVSS), DSPIC.51 (VSS), DSPIC.63 (VSS), DSPIC.73 (VSS), DSPIC.92 (VSS), DSPIC.108 (VSS), DSPIC.125 (VSS), DSPIC.141 (VSS); also elsewhere on the board
ICSP_!MCLR!: DSPIC.19 (!MCLR!)
ICSP_PGC: DSPIC.37 (PGEC1/AN6/RPI38/RB6)
ICSP_PGD: DSPIC.38 (PGED1/AN7/RCV/RPI39/RB7)
MOTA1_!FAULT!: DSPIC.85 (ASCL2/RPI18/RA2*); also elsewhere on the board
MOTA1_PWM: DSPIC.136 (AN24/PWM1L/RP80/RE0); also elsewhere on the board
MOTA2_!FAULT!: DSPIC.86 (ASDA2/RPI19/RA3*); also elsewhere on the board
MOTA2_PWM: DSPIC.142 (AN26/PWM2L/RP82/RE2); also elsewhere on the board
MOTA3_!FAULT!: DSPIC.95 (RPI30/RA14*); also elsewhere on the board
MOTA3_PWM: DSPIC.144 (AN28/PWM3L/RP84/RE4); also elsewhere on the board
MOTB1-2_!FAULT!: DSPIC.96 (RPI31/RA15*); also elsewhere on the board
MOTB1_PWM: DSPIC.4 (AN30/PWM4L/RPI86/RE6); also elsewhere on the board
MOTB2_PWM: DSPIC.10 (AN16/PWM5L/RPI49/RC1); also elsewhere on the board
MOTB3-4_!FAULT!: DSPIC.106 (PGED2/SOSCI/C3IN3-/RPI61/RC13); also elsewhere on the board
MOTB3_PWM: DSPIC.12 (AN18/PWM6L/RPI51/RC3); also elsewhere on the board
MOTB4_PWM: DSPIC.6 (PWM7L/PMA8/RJ8*); also elsewhere on the board
OSC1: CX1.1, DSPIC.90 (OSC1/RPI60/RC12), X1.1
OSC2: CX2.1, DSPIC.91 (OSC2/CLKO/RC15), X1.3 (2)
SD_!CS!: DSPIC.105 (INT0/DMH/RP64/RD0*); also elsewhere on the board
SD_MISO: DSPIC.110 (DPH/RP66/RD2*); also elsewhere on the board
SD_MOSI: DSPIC.111 (RP67/RD3*); also elsewhere on the board
SD_SCK: DSPIC.109 (VCPCON/RP65/RD1*); also elsewhere on the board
SENSE_IL1: DSPIC.62 (AN15/RPI47/RB15); also elsewhere on the board
SENSE_IMOTA1: DSPIC.137 (AN25/PWM1H/RPI81/RE1); also elsewhere on the board
SENSE_IMOTA2: DSPIC.143 (AN27/PWM2H/RPI83/RE3); also elsewhere on the board
SENSE_IMOTA3: DSPIC.3 (AN29/PWM3H/RP85/RE5); also elsewhere on the board
SENSE_IMOTB1: DSPIC.5 (AN31/PWM4H/RP87/RE7); also elsewhere on the board
SENSE_IMOTB2: DSPIC.11 (AN17/PWM5H/RPI50/RC2); also elsewhere on the board
SENSE_IMOTB3: DSPIC.13 (AN19/PWM6H/RPI52/RC4); also elsewhere on the board
SENSE_IMOTB4: DSPIC.35 (PGED3/AN0/RPI32/RB0); also elsewhere on the board
SENSE_IP1: DSPIC.26 (AN20/RPI88/RE8); also elsewhere on the board
SENSE_IP2: DSPIC.27 (AN21/RPI89/RE9); also elsewhere on the board
SENSE_IP3: DSPIC.130 (AN22/RPI22/RA6); also elsewhere on the board
SENSE_IP4: DSPIC.131 (AN23/RPI23/RA7); also elsewhere on the board
USB_D+: DSPIC.80 (D+/RG2)
USB_D-: DSPIC.79 (D-/RG3)
USB_VBUS: CB9.1, CT1.1, DSPIC.77 (VBUS*)
VCAP: CC1.1, DSPIC.123 (VCAP)

Notes on the sheet:
USB in device mode only
unused
2 x QEI
4 inhibits
4+8 IO FPGA interface
FPGA CLOCK EN
8 opto-isolated digital inputs
2 general purpose 3V3 digital inputs
Digital Servo Interface
2 CAN
4 Raspi SPI Slave
4 Periph SPI
7 PWM directions
8 ADC external inputs
4x VP1..4 sense
3x RGB led
5 x MOT_SLEEP
5 x MOT DECAY

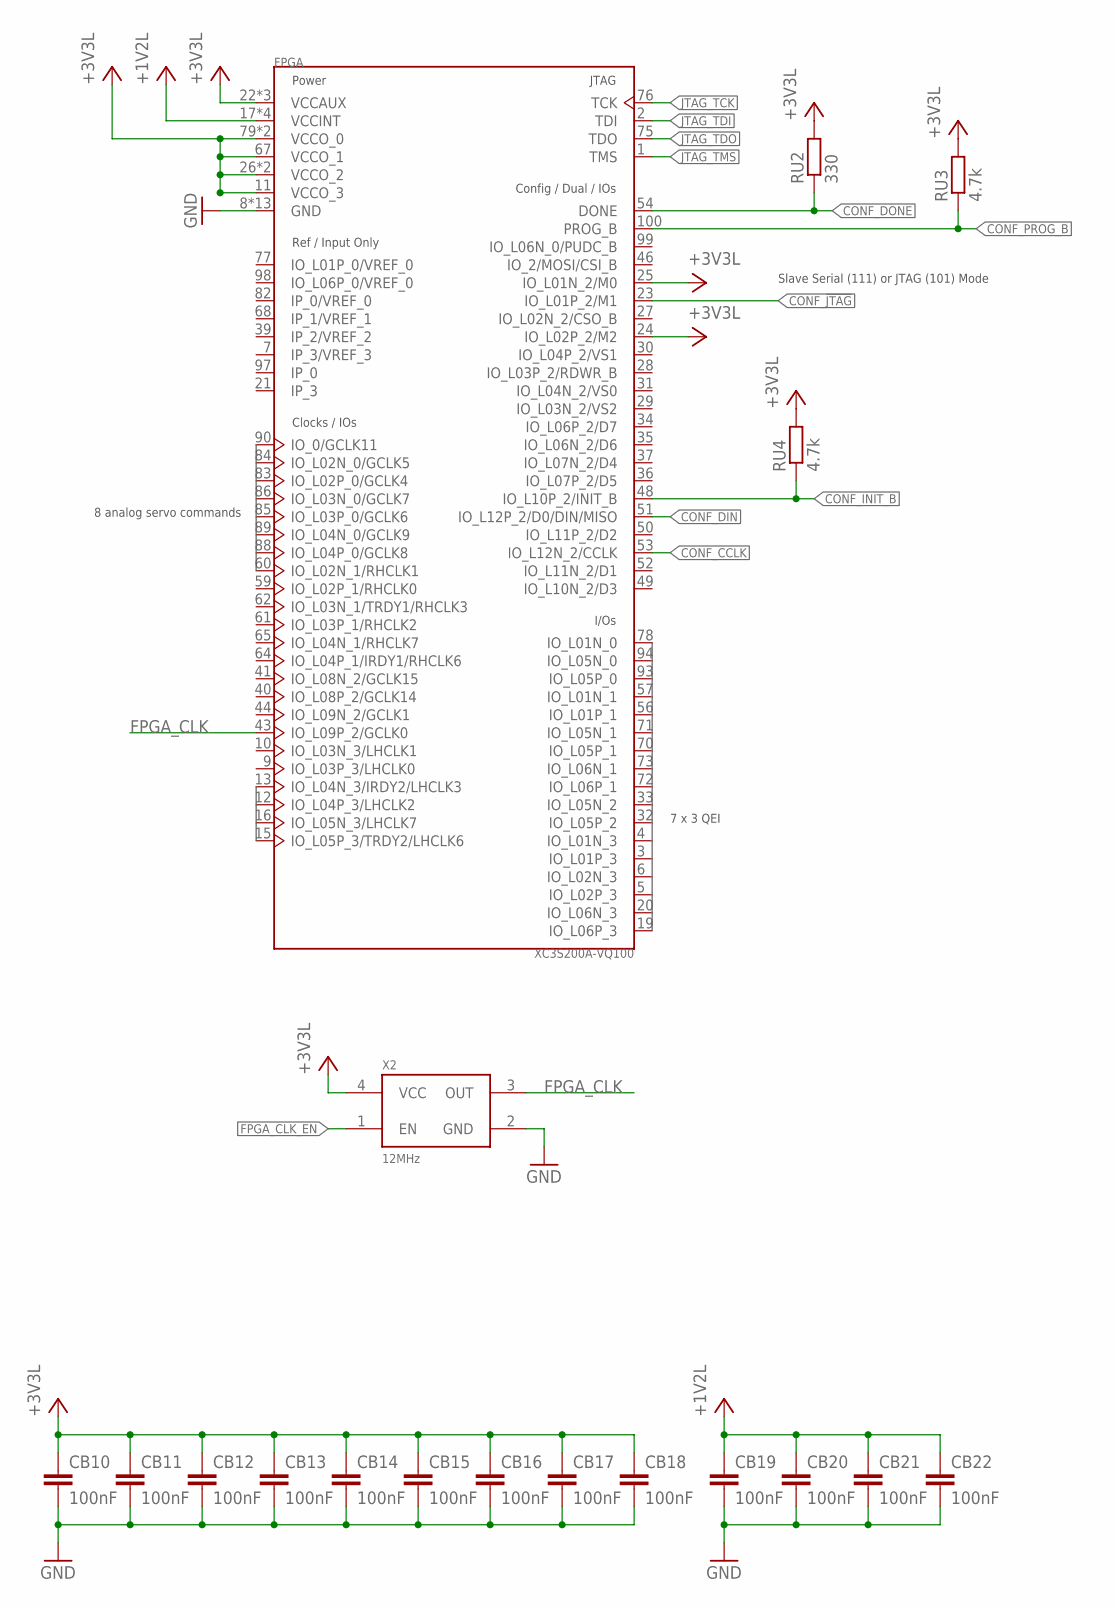
[picture p33: schematic microBoard.sch, sheet 4, FPGA XC3S200A]

Parts:
CB10, CB11, CB12, CB13, CB14, CB15, CB16, CB17, CB18, CB19, CB20, CB21, CB22: 100nF; C0603
FPGA: XC3S200A-VQ100; VQFP_100
RU2: 330; R0603
RU3, RU4: 4.7k; R0603
X2: 12MHz; CRYSTAL-SMD-5X3

Connections:
+1V2L: CB19.1, CB20.1, CB21.1, CB22.1, FPGA.17 (VCCINT), FPGA.38 (VCCINT), FPGA.66 (VCCINT), FPGA.81 (VCCINT); also elsewhere on the board
+3V3L: CB10.1, CB11.1, CB12.1, CB13.1, CB14.1, CB15.1, CB16.1, CB17.1, CB18.1, FPGA.11 (VCCO_3), FPGA.22 (VCCAUX), FPGA.24 (IO_L02P_2/M2), FPGA.25 (IO_L01N_2/M0), FPGA.26 (VCCO_2), FPGA.45 (VCCO_2), FPGA.55 (VCCAUX), FPGA.67 (VCCO_1), FPGA.79 (VCCO_0), FPGA.92 (VCCAUX), FPGA.96 (VCCO_0), RU2.2, RU3.2, RU4.2, X2.4 (VCC); also elsewhere on the board
CONF_!JTAG!: FPGA.23 (IO_L01P_2/M1)
CONF_CCLK: FPGA.53 (IO_L12N_2/CCLK)
CONF_DIN: FPGA.51 (IO_L12P_2/D0/DIN/MISO)
CONF_DONE: FPGA.54 (DONE), RU2.1
CONF_INIT_B: FPGA.48 (IO_L10P_2/INIT_B), RU4.1
CONF_PROG_B: FPGA.100 (PROG_B), RU3.1
FPGA_CLK: FPGA.43 (IO_L09P_2/GCLK0), X2.3 (OUT)
FPGA_CLK_EN: X2.1 (EN)
GND: CB10.2, CB11.2, CB12.2, CB13.2, CB14.2, CB15.2, CB16.2, CB17.2, CB18.2, CB19.2, CB20.2, CB21.2, CB22.2, FPGA.8 (GND), FPGA.14 (GND), FPGA.18 (GND), FPGA.42 (GND), FPGA.47 (GND), FPGA.58 (GND), FPGA.63 (GND), FPGA.69 (GND), FPGA.74 (GND), FPGA.80 (GND), FPGA.87 (GND), FPGA.91 (GND), FPGA.95 (GND), X2.2 (GND); also elsewhere on the board
JTAG_TCK: FPGA.76 (TCK)
JTAG_TDI: FPGA.2 (TDI)
JTAG_TDO: FPGA.75 (TDO)
JTAG_TMS: FPGA.1 (TMS)

Notes on the sheet:
7 x 3 QEI
Slave Serial (111) or JTAG (101) Mode
8 analog servo commands
