I-Grebot/elec_microboard/src/_old/microBoard.brd

## EAGLE design src/_old/microBoard.brd (continued)

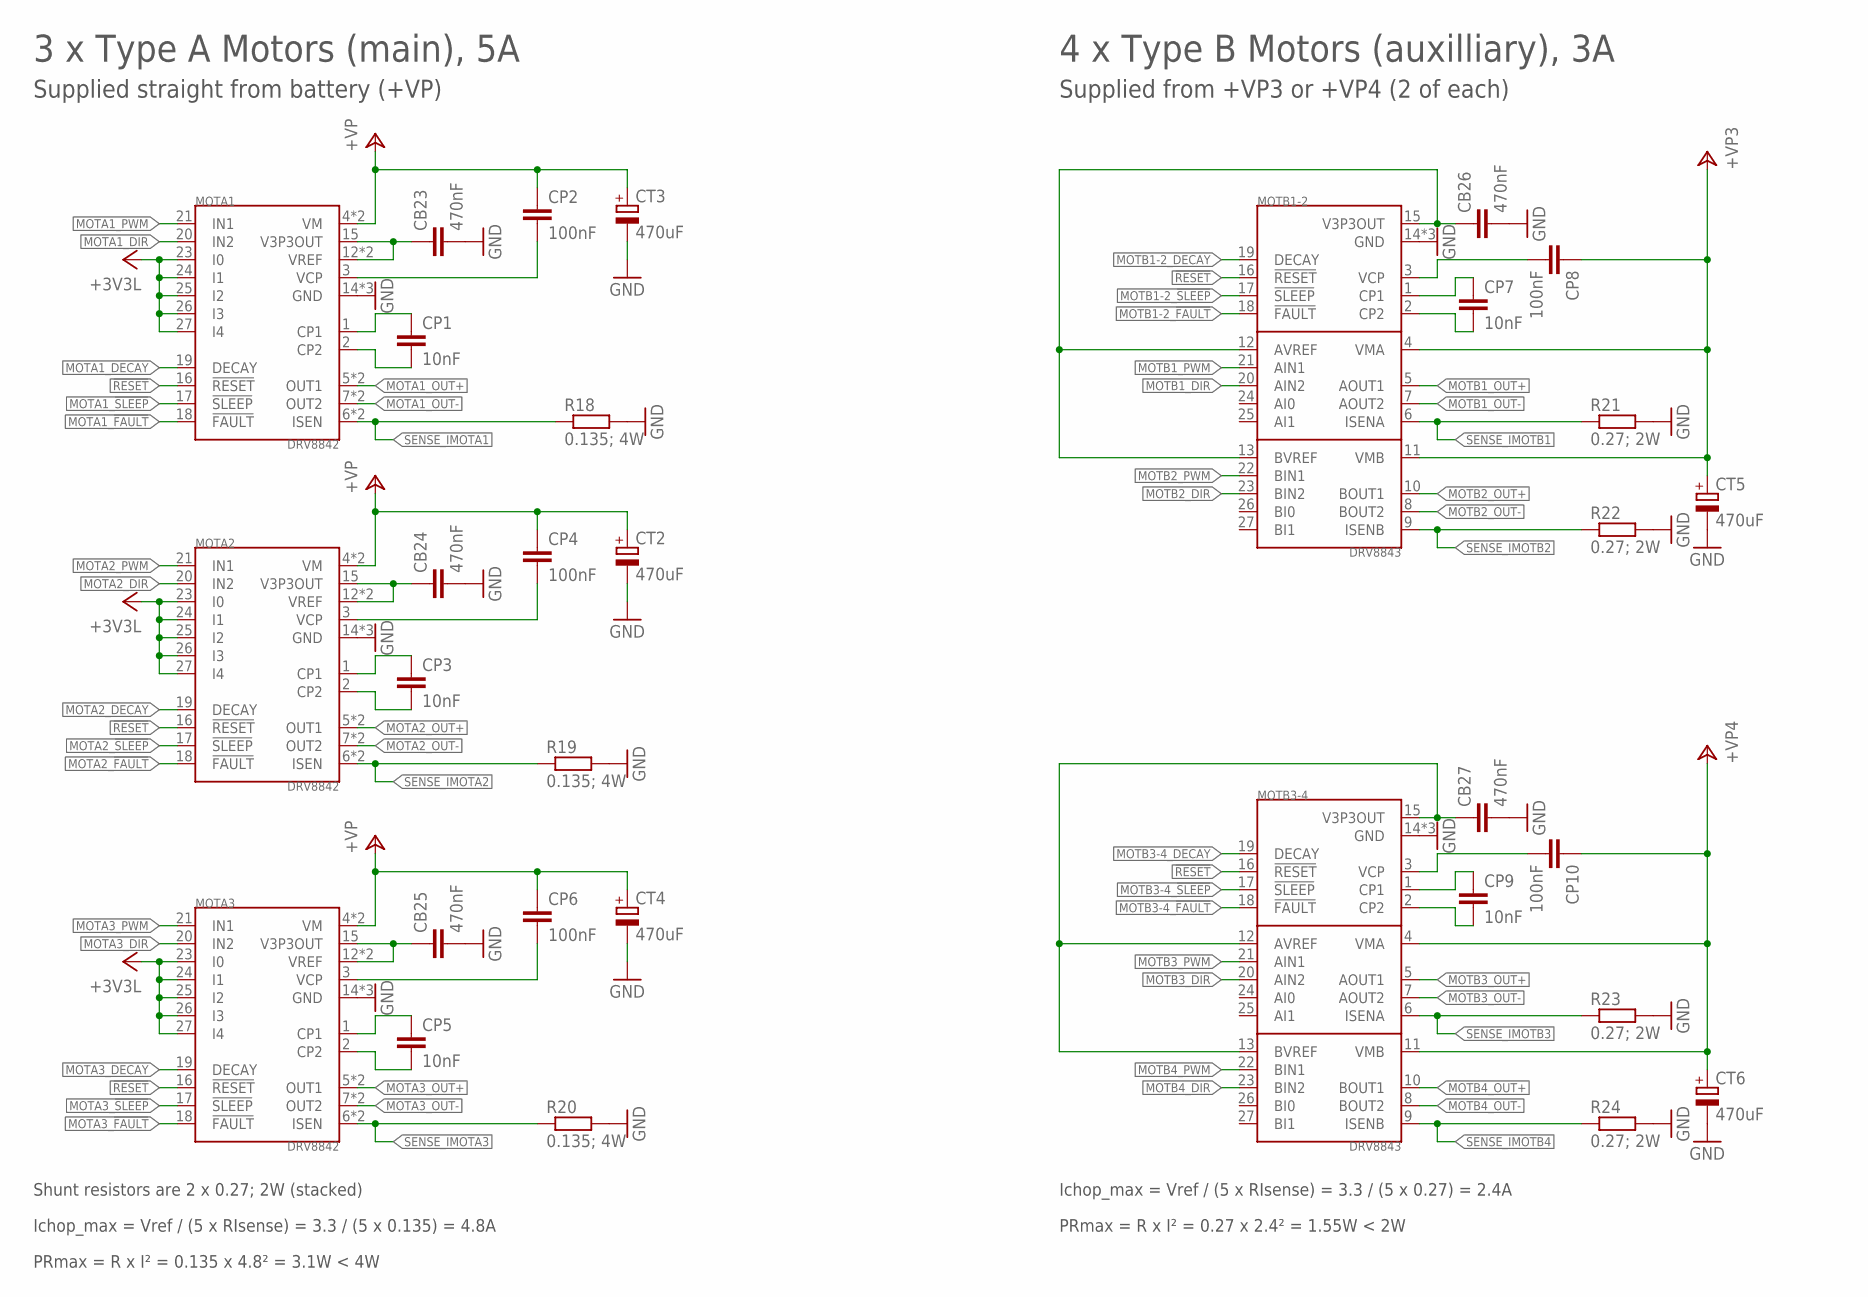
[picture p34: schematic microBoard.sch, sheet 5, H-Bridges]

Parts:
CB23, CB24, CB25, CB26, CB27: 470nF; C0603
CP1, CP3, CP5, CP7, CP9: 10nF; C0603
CP2, CP4, CP6, CP8, CP10: 100nF; C0603
CT2, CT3, CT4, CT5, CT6: 470uF; PANASONIC_D
MOTA1, MOTA2, MOTA3: DRV8842; PWP_28
MOTB1-2, MOTB3-4: DRV8843; PWP_28
R18, R19, R20: 0.135; 4W; R2512
R21, R22, R23, R24: 0.27; 2W; R2512

Connections:
!RESET!: MOTA1.16 (!RESET!), MOTA2.16 (!RESET!), MOTA3.16 (!RESET!), MOTB1-2.16 (!RESET!), MOTB3-4.16 (!RESET!)
+3V3L: MOTA1.23 (I0), MOTA1.24 (I1), MOTA1.25 (I2), MOTA1.26 (I3), MOTA1.27 (I4), MOTA2.23 (I0), MOTA2.24 (I1), MOTA2.25 (I2), MOTA2.26 (I3), MOTA2.27 (I4), MOTA3.23 (I0), MOTA3.24 (I1), MOTA3.25 (I2), MOTA3.26 (I3), MOTA3.27 (I4); also elsewhere on the board
+VP: CP2.1, CP4.1, CP6.1, CT2.+, CT3.+, CT4.+, MOTA1.4 (VM), MOTA1.11 (VM), MOTA2.4 (VM), MOTA2.11 (VM), MOTA3.4 (VM), MOTA3.11 (VM); also elsewhere on the board
+VP3: CP8.1, CT5.+, MOTB1-2.4 (VMA), MOTB1-2.11 (VMB); also elsewhere on the board
+VP4: CP10.1, CT6.+, MOTB3-4.4 (VMA), MOTB3-4.11 (VMB); also elsewhere on the board
GND: CB23.2, CB24.2, CB25.2, CB26.2, CB27.2, CT2.-, CT3.-, CT4.-, CT5.-, CT6.-, MOTA1.14 (GND), MOTA1.28 (GND), MOTA1.PPAD (GND), MOTA2.14 (GND), MOTA2.28 (GND), MOTA2.PPAD (GND), MOTA3.14 (GND), MOTA3.28 (GND), MOTA3.PPAD (GND), MOTB1-2.14 (GND), MOTB1-2.28 (GND), MOTB1-2.PPAD (GND), MOTB3-4.14 (GND), MOTB3-4.28 (GND), MOTB3-4.PPAD (GND), R18.2, R19.2, R20.2, R21.2, R22.2, R23.2, R24.2; also elsewhere on the board
MOTA1_!FAULT!: MOTA1.18 (!FAULT!); also elsewhere on the board
MOTA1_!SLEEP!: MOTA1.17 (!SLEEP!)
MOTA1_DECAY: MOTA1.19 (DECAY)
MOTA1_DIR: MOTA1.20 (IN2)
MOTA1_OUT+: MOTA1.5 (OUT1), MOTA1.10 (OUT1)
MOTA1_OUT-: MOTA1.7 (OUT2), MOTA1.8 (OUT2)
MOTA1_PWM: MOTA1.21 (IN1); also elsewhere on the board
MOTA2_!FAULT!: MOTA2.18 (!FAULT!); also elsewhere on the board
MOTA2_!SLEEP!: MOTA2.17 (!SLEEP!)
MOTA2_DECAY: MOTA2.19 (DECAY)
MOTA2_DIR: MOTA2.20 (IN2)
MOTA2_OUT+: MOTA2.5 (OUT1), MOTA2.10 (OUT1)
MOTA2_OUT-: MOTA2.7 (OUT2), MOTA2.8 (OUT2)
MOTA2_PWM: MOTA2.21 (IN1); also elsewhere on the board
MOTA3_!FAULT!: MOTA3.18 (!FAULT!); also elsewhere on the board
MOTA3_!SLEEP!: MOTA3.17 (!SLEEP!)
MOTA3_DECAY: MOTA3.19 (DECAY)
MOTA3_DIR: MOTA3.20 (IN2)
MOTA3_OUT+: MOTA3.5 (OUT1), MOTA3.10 (OUT1)
MOTA3_OUT-: MOTA3.7 (OUT2), MOTA3.8 (OUT2)
MOTA3_PWM: MOTA3.21 (IN1); also elsewhere on the board
MOTB1-2_!FAULT!: MOTB1-2.18 (!FAULT!); also elsewhere on the board
MOTB1-2_!SLEEP!: MOTB1-2.17 (!SLEEP!)
MOTB1-2_DECAY: MOTB1-2.19 (DECAY)
MOTB1_DIR: MOTB1-2.20 (AIN2)
MOTB1_OUT+: MOTB1-2.5 (AOUT1)
MOTB1_OUT-: MOTB1-2.7 (AOUT2)
MOTB1_PWM: MOTB1-2.21 (AIN1); also elsewhere on the board
MOTB2_DIR: MOTB1-2.23 (BIN2)
MOTB2_OUT+: MOTB1-2.10 (BOUT1)
MOTB2_OUT-: MOTB1-2.8 (BOUT2)
MOTB2_PWM: MOTB1-2.22 (BIN1); also elsewhere on the board
MOTB3-4_!FAULT!: MOTB3-4.18 (!FAULT!); also elsewhere on the board
MOTB3-4_!SLEEP!: MOTB3-4.17 (!SLEEP!)
MOTB3-4_DECAY: MOTB3-4.19 (DECAY)
MOTB3_DIR: MOTB3-4.20 (AIN2)
MOTB3_OUT+: MOTB3-4.5 (AOUT1)
MOTB3_OUT-: MOTB3-4.7 (AOUT2)
MOTB3_PWM: MOTB3-4.21 (AIN1); also elsewhere on the board
MOTB4_DIR: MOTB3-4.23 (BIN2)
MOTB4_OUT+: MOTB3-4.10 (BOUT1)
MOTB4_OUT-: MOTB3-4.8 (BOUT2)
MOTB4_PWM: MOTB3-4.22 (BIN1); also elsewhere on the board
unnamed: CP3.1, MOTA2.1 (CP1)
unnamed: CP3.2, MOTA2.2 (CP2)
unnamed: CP1.1, MOTA1.1 (CP1)
unnamed: CP1.2, MOTA1.2 (CP2)
unnamed: CP2.2, MOTA1.3 (VCP)
unnamed: CB23.1, MOTA1.12 (VREF), MOTA1.13 (VREF), MOTA1.15 (V3P3OUT)
unnamed: CP4.2, MOTA2.3 (VCP)
unnamed: CB24.1, MOTA2.12 (VREF), MOTA2.13 (VREF), MOTA2.15 (V3P3OUT)
unnamed: CP5.1, MOTA3.1 (CP1)
unnamed: CP5.2, MOTA3.2 (CP2)
unnamed: CP6.2, MOTA3.3 (VCP)
unnamed: CB25.1, MOTA3.12 (VREF), MOTA3.13 (VREF), MOTA3.15 (V3P3OUT)
unnamed: CP7.2, MOTB1-2.2 (CP2)
unnamed: CP7.1, MOTB1-2.1 (CP1)
unnamed: CP8.2, MOTB1-2.3 (VCP)
unnamed: CB26.1, MOTB1-2.12 (AVREF), MOTB1-2.13 (BVREF), MOTB1-2.15 (V3P3OUT)
unnamed: CP9.2, MOTB3-4.2 (CP2)
unnamed: CP9.1, MOTB3-4.1 (CP1)
unnamed: CP10.2, MOTB3-4.3 (VCP)
unnamed: CB27.1, MOTB3-4.12 (AVREF), MOTB3-4.13 (BVREF), MOTB3-4.15 (V3P3OUT)
SENSE_IMOTA1: MOTA1.6 (ISEN), MOTA1.9 (ISEN), R18.1; also elsewhere on the board
SENSE_IMOTA2: MOTA2.6 (ISEN), MOTA2.9 (ISEN), R19.1; also elsewhere on the board
SENSE_IMOTA3: MOTA3.6 (ISEN), MOTA3.9 (ISEN), R20.1; also elsewhere on the board
SENSE_IMOTB1: MOTB1-2.6 (ISENA), R21.1; also elsewhere on the board
SENSE_IMOTB2: MOTB1-2.9 (ISENB), R22.1; also elsewhere on the board
SENSE_IMOTB3: MOTB3-4.6 (ISENA), R23.1; also elsewhere on the board
SENSE_IMOTB4: MOTB3-4.9 (ISENB), R24.1; also elsewhere on the board

Notes on the sheet:
3 x Type A Motors (main), 5A
Ichop_max = Vref / (5 x RIsense) = 3.3 / (5 x 0.135) = 4.8A
Ichop_max = Vref / (5 x RIsense) = 3.3 / (5 x 0.27) = 2.4A
PRmax = R x I² = 0.27 x 2.4² = 1.55W < 2W
PRmax = R x I² = 0.135 x 4.8² = 3.1W < 4W
Shunt resistors are 2 x 0.27; 2W (stacked)
4 x Type B Motors (auxilliary), 3A
Supplied straight from battery (+VP)
Supplied from +VP3 or +VP4 (2 of each)

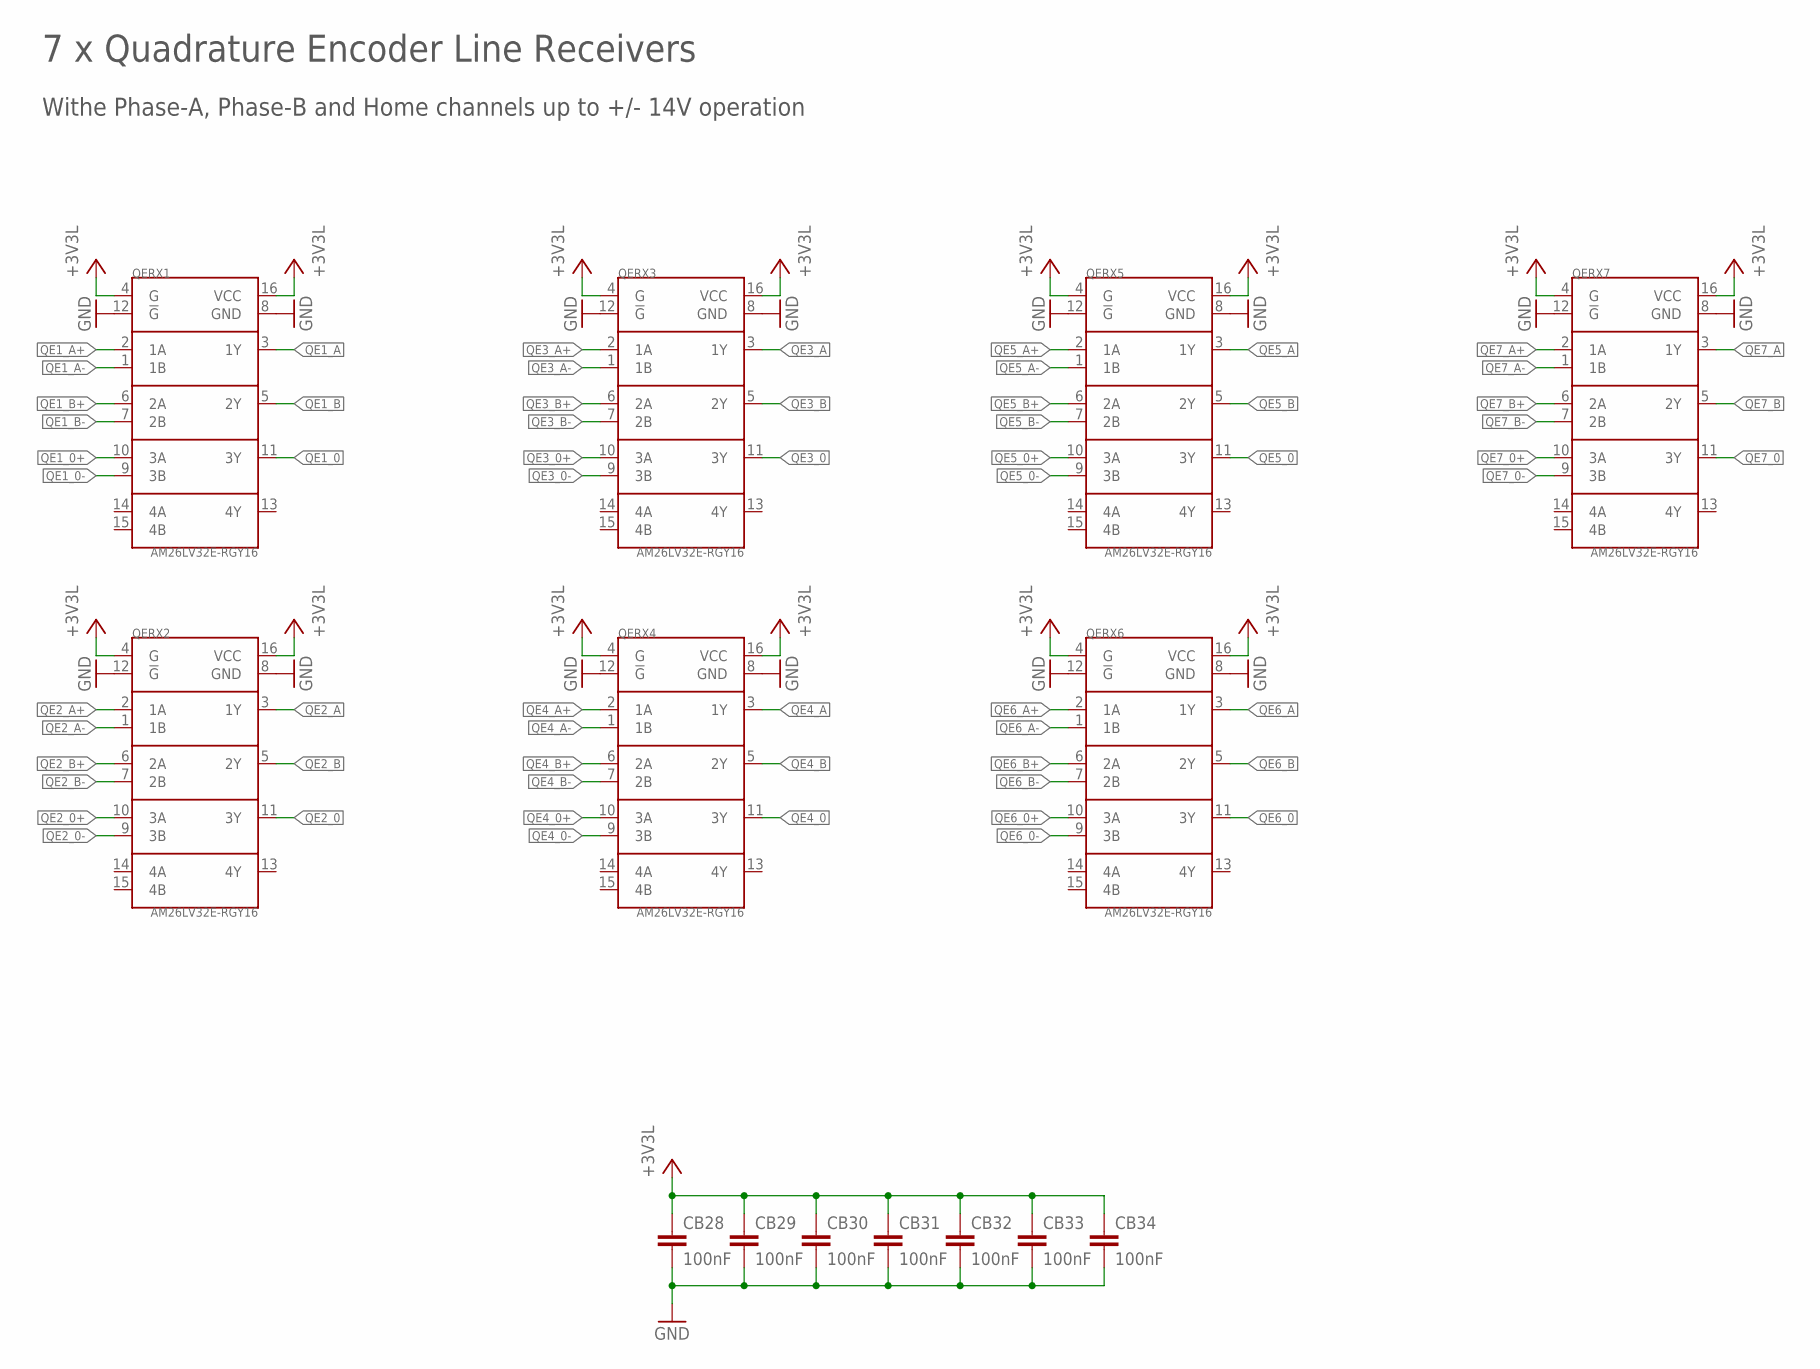
[picture p35: schematic microBoard.sch, sheet 6, Quadrature encoders]

Parts:
CB28, CB29, CB30, CB31, CB32, CB33, CB34: 100nF; C0603
QERX1, QERX2, QERX3, QERX4, QERX5, QERX6, QERX7: AM26LV32E-RGY16; RGY_16

Connections:
+3V3L: CB28.1, CB29.1, CB30.1, CB31.1, CB32.1, CB33.1, CB34.1, QERX1.4 (G), QERX1.16 (VCC), QERX2.4 (G), QERX2.16 (VCC), QERX3.4 (G), QERX3.16 (VCC), QERX4.4 (G), QERX4.16 (VCC), QERX5.4 (G), QERX5.16 (VCC), QERX6.4 (G), QERX6.16 (VCC), QERX7.4 (G), QERX7.16 (VCC); also elsewhere on the board
GND: CB28.2, CB29.2, CB30.2, CB31.2, CB32.2, CB33.2, CB34.2, QERX1.8 (GND), QERX1.12 (!G!), QERX2.8 (GND), QERX2.12 (!G!), QERX3.8 (GND), QERX3.12 (!G!), QERX4.8 (GND), QERX4.12 (!G!), QERX5.8 (GND), QERX5.12 (!G!), QERX6.8 (GND), QERX6.12 (!G!), QERX7.8 (GND), QERX7.12 (!G!); also elsewhere on the board
QE1_0: QERX1.11 (3Y)
QE1_0+: QERX1.10 (3A); also elsewhere on the board
QE1_0-: QERX1.9 (3B); also elsewhere on the board
QE1_A: QERX1.3 (1Y)
QE1_A+: QERX1.2 (1A); also elsewhere on the board
QE1_A-: QERX1.1 (1B); also elsewhere on the board
QE1_B: QERX1.5 (2Y)
QE1_B+: QERX1.6 (2A); also elsewhere on the board
QE1_B-: QERX1.7 (2B); also elsewhere on the board
QE2_0: QERX2.11 (3Y)
QE2_0+: QERX2.10 (3A); also elsewhere on the board
QE2_0-: QERX2.9 (3B); also elsewhere on the board
QE2_A: QERX2.3 (1Y)
QE2_A+: QERX2.2 (1A); also elsewhere on the board
QE2_A-: QERX2.1 (1B); also elsewhere on the board
QE2_B: QERX2.5 (2Y)
QE2_B+: QERX2.6 (2A); also elsewhere on the board
QE2_B-: QERX2.7 (2B); also elsewhere on the board
QE3_0: QERX3.11 (3Y)
QE3_0+: QERX3.10 (3A); also elsewhere on the board
QE3_0-: QERX3.9 (3B); also elsewhere on the board
QE3_A: QERX3.3 (1Y)
QE3_A+: QERX3.2 (1A); also elsewhere on the board
QE3_A-: QERX3.1 (1B); also elsewhere on the board
QE3_B: QERX3.5 (2Y)
QE3_B+: QERX3.6 (2A); also elsewhere on the board
QE3_B-: QERX3.7 (2B); also elsewhere on the board
QE4_0: QERX4.11 (3Y)
QE4_0+: QERX4.10 (3A); also elsewhere on the board
QE4_0-: QERX4.9 (3B); also elsewhere on the board
QE4_A: QERX4.3 (1Y)
QE4_A+: QERX4.2 (1A); also elsewhere on the board
QE4_A-: QERX4.1 (1B); also elsewhere on the board
QE4_B: QERX4.5 (2Y)
QE4_B+: QERX4.6 (2A); also elsewhere on the board
QE4_B-: QERX4.7 (2B); also elsewhere on the board
QE5_0: QERX5.11 (3Y)
QE5_0+: QERX5.10 (3A); also elsewhere on the board
QE5_0-: QERX5.9 (3B); also elsewhere on the board
QE5_A: QERX5.3 (1Y)
QE5_A+: QERX5.2 (1A); also elsewhere on the board
QE5_A-: QERX5.1 (1B); also elsewhere on the board
QE5_B: QERX5.5 (2Y)
QE5_B+: QERX5.6 (2A); also elsewhere on the board
QE5_B-: QERX5.7 (2B); also elsewhere on the board
QE6_0: QERX6.11 (3Y)
QE6_0+: QERX6.10 (3A); also elsewhere on the board
QE6_0-: QERX6.9 (3B); also elsewhere on the board
QE6_A: QERX6.3 (1Y)
QE6_A+: QERX6.2 (1A); also elsewhere on the board
QE6_A-: QERX6.1 (1B); also elsewhere on the board
QE6_B: QERX6.5 (2Y)
QE6_B+: QERX6.6 (2A); also elsewhere on the board
QE6_B-: QERX6.7 (2B); also elsewhere on the board
QE7_0: QERX7.11 (3Y)
QE7_0+: QERX7.10 (3A); also elsewhere on the board
QE7_0-: QERX7.9 (3B); also elsewhere on the board
QE7_A: QERX7.3 (1Y)
QE7_A+: QERX7.2 (1A); also elsewhere on the board
QE7_A-: QERX7.1 (1B); also elsewhere on the board
QE7_B: QERX7.5 (2Y)
QE7_B+: QERX7.6 (2A); also elsewhere on the board
QE7_B-: QERX7.7 (2B); also elsewhere on the board

Notes on the sheet:
7 x Quadrature Encoder Line Receivers
Withe Phase-A, Phase-B and Home channels up to +/- 14V operation

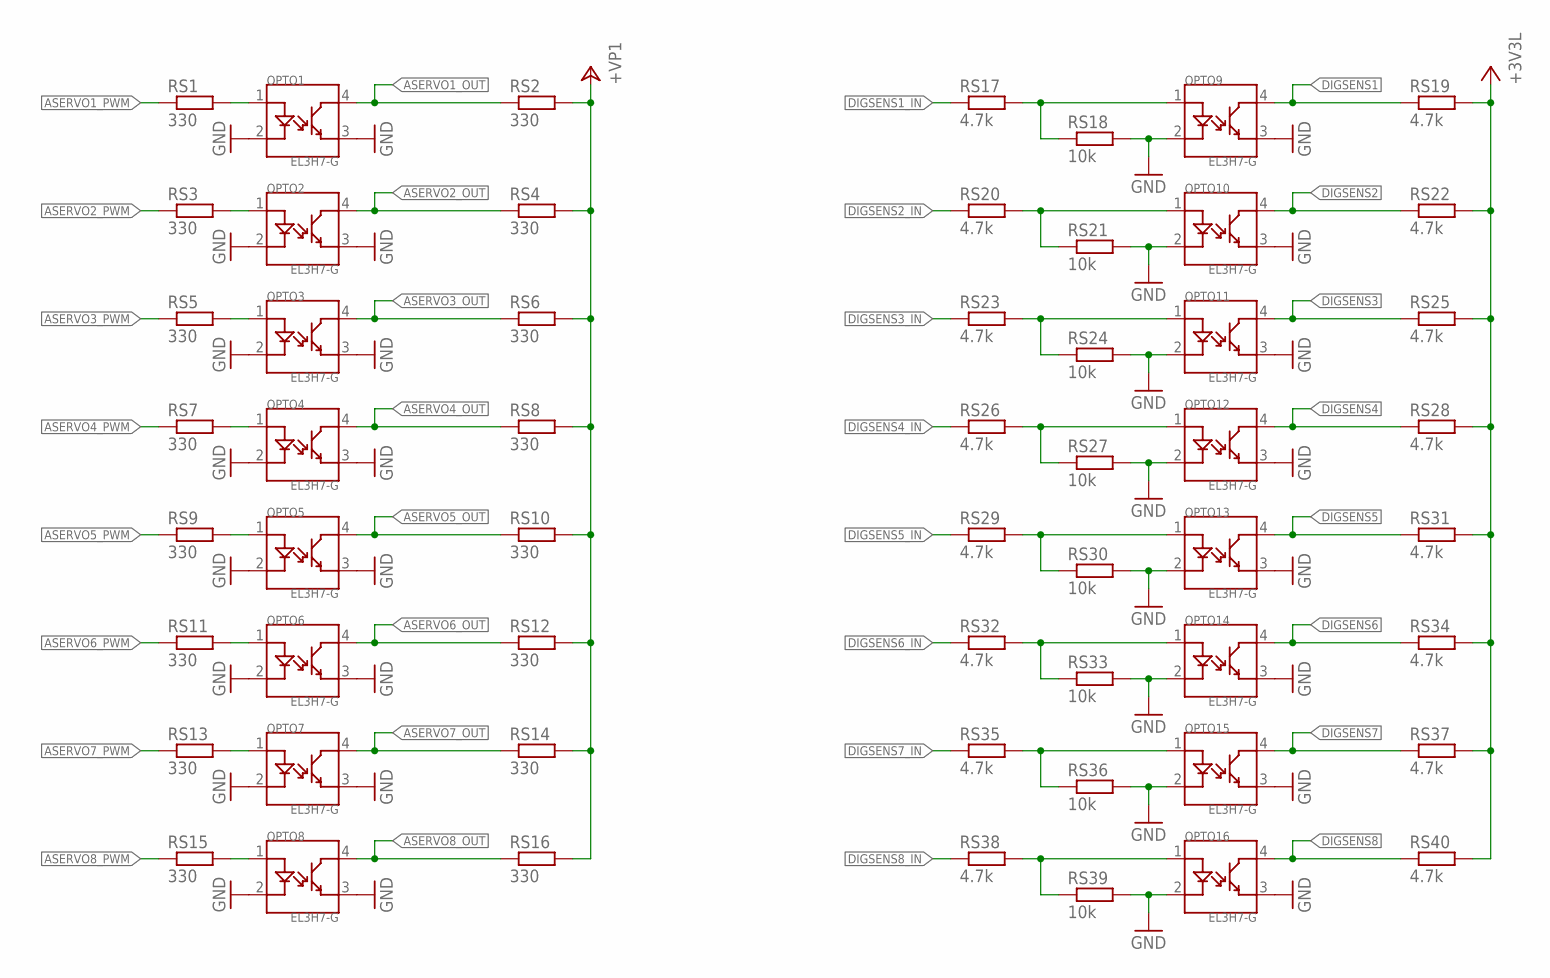
[picture p36: schematic microBoard.sch, sheet 7, Optocouplers]

Parts:
OPTO1, OPTO2, OPTO3, OPTO4, OPTO5, OPTO6, OPTO7, OPTO8, OPTO9, OPTO10, OPTO11, OPTO12, OPTO13, OPTO14, OPTO15, OPTO16: EL3H7-G; SSOP_4
RS1, RS2, RS3, RS4, RS5, RS6, RS7, RS8, RS9, RS10, RS11, RS12, RS13, RS14, RS15, RS16: 330; R0603
RS17, RS19, RS20, RS22, RS23, RS25, RS26, RS28, RS29, RS31, RS32, RS34, RS35, RS37, RS38, RS40: 4.7k; R0603
RS18, RS21, RS24, RS27, RS30, RS33, RS36, RS39: 10k; R0603

Connections:
+3V3L: RS19.2, RS22.2, RS25.2, RS28.2, RS31.2, RS34.2, RS37.2, RS40.2; also elsewhere on the board
+VP1: RS2.2, RS4.2, RS6.2, RS8.2, RS10.2, RS12.2, RS14.2, RS16.2; also elsewhere on the board
ASERVO1_OUT: OPTO1.4, RS2.1
ASERVO1_PWM: RS1.1
ASERVO2_OUT: OPTO2.4, RS4.1
ASERVO2_PWM: RS3.1
ASERVO3_OUT: OPTO3.4, RS6.1
ASERVO3_PWM: RS5.1
ASERVO4_OUT: OPTO4.4, RS8.1
ASERVO4_PWM: RS7.1
ASERVO5_OUT: OPTO5.4, RS10.1
ASERVO5_PWM: RS9.1
ASERVO6_OUT: OPTO6.4, RS12.1
ASERVO6_PWM: RS11.1
ASERVO7_OUT: OPTO7.4, RS14.1
ASERVO7_PWM: RS13.1
ASERVO8_OUT: OPTO8.4, RS16.1
ASERVO8_PWM: RS15.1
DIGSENS1: OPTO9.4, RS19.1
DIGSENS1_IN: RS17.1
DIGSENS2: OPTO10.4, RS22.1
DIGSENS2_IN: RS20.1
DIGSENS3: OPTO11.4, RS25.1
DIGSENS3_IN: RS23.1
DIGSENS4: OPTO12.4, RS28.1
DIGSENS4_IN: RS26.1
DIGSENS5: OPTO13.4, RS31.1
DIGSENS5_IN: RS29.1
DIGSENS6: OPTO14.4, RS34.1
DIGSENS6_IN: RS32.1
DIGSENS7: OPTO15.4, RS37.1
DIGSENS7_IN: RS35.1
DIGSENS8: OPTO16.4, RS40.1
DIGSENS8_IN: RS38.1
GND: OPTO1.2, OPTO1.3, OPTO2.2, OPTO2.3, OPTO3.2, OPTO3.3, OPTO4.2, OPTO4.3, OPTO5.2, OPTO5.3, OPTO6.2, OPTO6.3, OPTO7.2, OPTO7.3, OPTO8.2, OPTO8.3, OPTO9.2, OPTO9.3, OPTO10.2, OPTO10.3, OPTO11.2, OPTO11.3, OPTO12.2, OPTO12.3, OPTO13.2, OPTO13.3, OPTO14.2, OPTO14.3, OPTO15.2, OPTO15.3, OPTO16.2, OPTO16.3, RS18.2, RS21.2, RS24.2, RS27.2, RS30.2, RS33.2, RS36.2, RS39.2; also elsewhere on the board
unnamed: OPTO1.1, RS1.2
unnamed: OPTO2.1, RS3.2
unnamed: OPTO3.1, RS5.2
unnamed: OPTO4.1, RS7.2
unnamed: OPTO5.1, RS9.2
unnamed: OPTO6.1, RS11.2
unnamed: OPTO7.1, RS13.2
unnamed: OPTO8.1, RS15.2
unnamed: OPTO9.1, RS17.2, RS18.1
unnamed: OPTO11.1, RS23.2, RS24.1
unnamed: OPTO10.1, RS20.2, RS21.1
unnamed: OPTO12.1, RS26.2, RS27.1
unnamed: OPTO13.1, RS29.2, RS30.1
unnamed: OPTO14.1, RS32.2, RS33.1
unnamed: OPTO15.1, RS35.2, RS36.1
unnamed: OPTO16.1, RS38.2, RS39.1

Board: 2 copper layers, 227 parts (0 on the bottom side), 180 nets, no tracks yet.
