I-Grebot/elec_microboard/src/Modules/DRV8843/microBoard_DRV8843.brd

## EAGLE design src/Modules/DRV8843/microBoard_DRV8843.brd (2016-11-11)

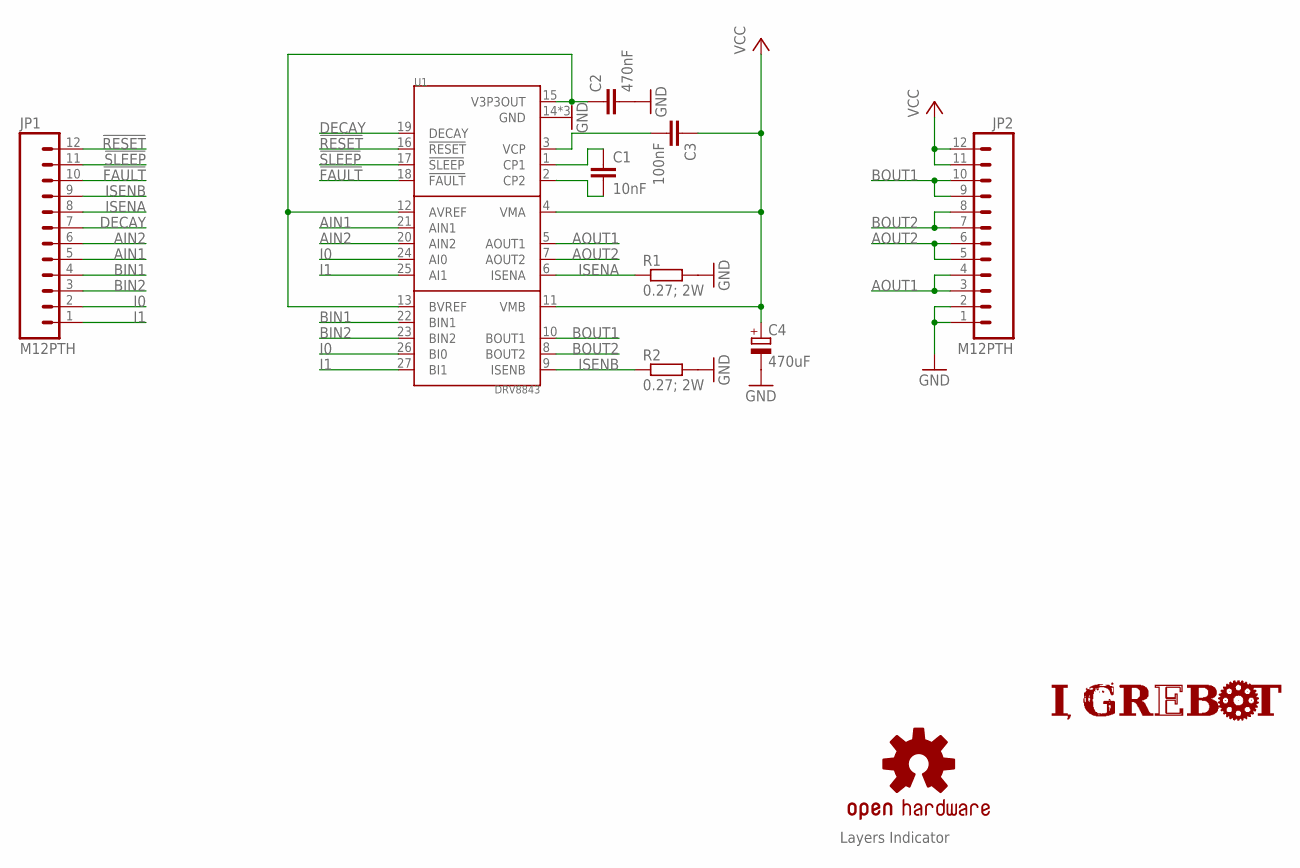
[picture p37: schematic microBoard_DRV8843.sch]

Parts:
C1: 10nF; C0603
C2: 470nF; C0603
C3: 100nF; C0603
C4: 470uF; PANASONIC_D
JP1, JP2: M12PTH; 1X12
LOGO1: OSHW-LOGOS; OSHW-LOGO-S
R1, R2: 0.27; 2W; R2010
U1: DRV8843; PWP_28
U$1: LOGO_IGREBOT12X2MM; IGREBOT_12X2MM
U$2: LAYERS_CHECK4_LAYERS; LAYERS_CHECK_4

Connections:
!FAULT!: JP1.10, U1.18 (!FAULT!)
!RESET!: JP1.12, U1.16 (!RESET!)
!SLEEP!: JP1.11, U1.17 (!SLEEP!)
AIN1: JP1.5, U1.21 (AIN1)
AIN2: JP1.6, U1.20 (AIN2)
AOUT1: JP2.3, JP2.4, U1.5 (AOUT1)
AOUT2: JP2.5, JP2.6, U1.7 (AOUT2)
BIN1: JP1.4, U1.22 (BIN1)
BIN2: JP1.3, U1.23 (BIN2)
BOUT1: JP2.9, JP2.10, U1.10 (BOUT1)
BOUT2: JP2.7, JP2.8, U1.8 (BOUT2)
DECAY: JP1.7, U1.19 (DECAY)
GND: C2.2, C4.-, JP2.1, JP2.2, R1.2, R2.2, U1.14 (GND), U1.28 (GND), U1.PPAD (GND)
I0: JP1.2, U1.24 (AI0), U1.26 (BI0)
I1: JP1.1, U1.25 (AI1), U1.27 (BI1)
ISENA: JP1.8, R1.1, U1.6 (ISENA)
ISENB: JP1.9, R2.1, U1.9 (ISENB)
unnamed: C1.2, U1.2 (CP2)
unnamed: C1.1, U1.1 (CP1)
unnamed: C3.2, U1.3 (VCP)
unnamed: C2.1, U1.12 (AVREF), U1.13 (BVREF), U1.15 (V3P3OUT)
VCC: C3.1, C4.+, JP2.11, JP2.12, U1.4 (VMA), U1.11 (VMB)

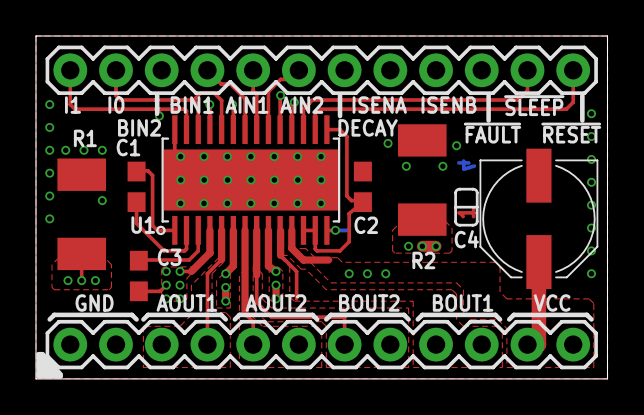
[picture p38: board microBoard_DRV8843.brd from above]

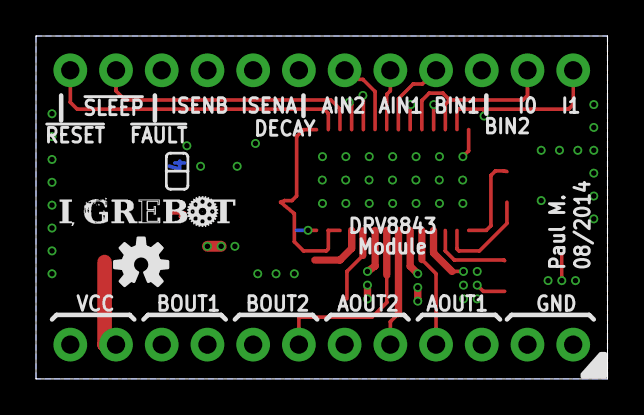
[picture p39: board microBoard_DRV8843.brd from below]

Board: 4 copper layers, 31.8 x 19.1 mm, 12 parts (2 on the bottom side), 22 nets.
