I-Grebot/elec_microboard/src/Modules/DRV8842/microBoard_DRV8842.brd

## EAGLE design src/Modules/DRV8842/microBoard_DRV8842.brd (2016-11-11)

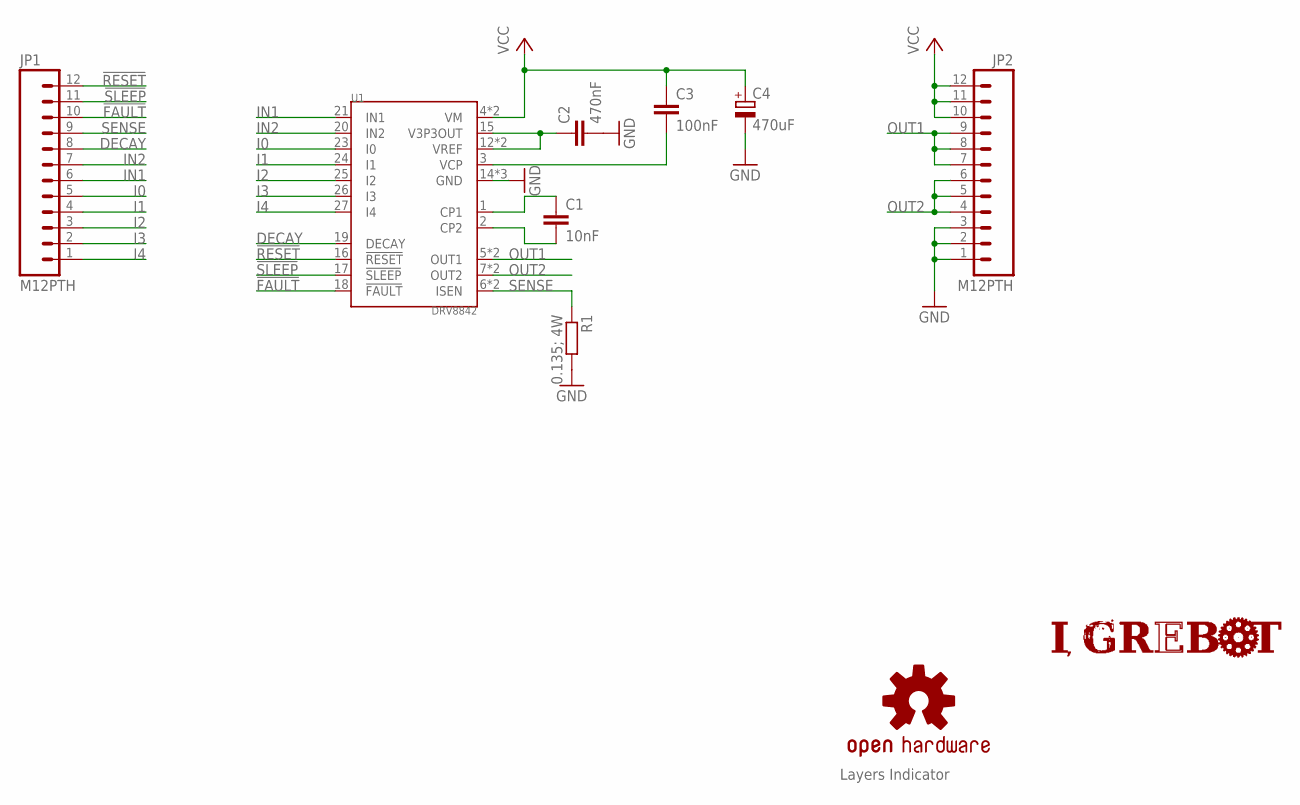
[picture p40: schematic microBoard_DRV8842.sch]

Parts:
C1: 10nF; C0603
C2: 470nF; C0603
C3: 100nF; C0603
C4: 470uF; PANASONIC_D
JP1, JP2: M12PTH; 1X12
LOGO1: OSHW-LOGOS; OSHW-LOGO-S
R1: 0.135; 4W; R2010
U1: DRV8842; PWP_28
U$1: LOGO_IGREBOT12X2MM; IGREBOT_12X2MM
U$2: LAYERS_CHECK4_LAYERS; LAYERS_CHECK_4

Connections:
!FAULT!: JP1.10, U1.18 (!FAULT!)
!RESET!: JP1.12, U1.16 (!RESET!)
!SLEEP!: JP1.11, U1.17 (!SLEEP!)
DECAY: JP1.8, U1.19 (DECAY)
GND: C2.2, C4.-, JP2.1, JP2.2, JP2.3, R1.2, U1.14 (GND), U1.28 (GND), U1.PPAD (GND)
I0: JP1.5, U1.23 (I0)
I1: JP1.4, U1.24 (I1)
I2: JP1.3, U1.25 (I2)
I3: JP1.2, U1.26 (I3)
I4: JP1.1, U1.27 (I4)
IN1: JP1.6, U1.21 (IN1)
IN2: JP1.7, U1.20 (IN2)
unnamed: C1.1, U1.1 (CP1)
unnamed: C1.2, U1.2 (CP2)
unnamed: C3.2, U1.3 (VCP)
unnamed: C2.1, U1.12 (VREF), U1.13 (VREF), U1.15 (V3P3OUT)
OUT1: JP2.7, JP2.8, JP2.9, U1.5 (OUT1), U1.10 (OUT1)
OUT2: JP2.4, JP2.5, JP2.6, U1.7 (OUT2), U1.8 (OUT2)
SENSE: JP1.9, R1.1, U1.6 (ISEN), U1.9 (ISEN)
VCC: C3.1, C4.+, JP2.10, JP2.11, JP2.12, U1.4 (VM), U1.11 (VM)

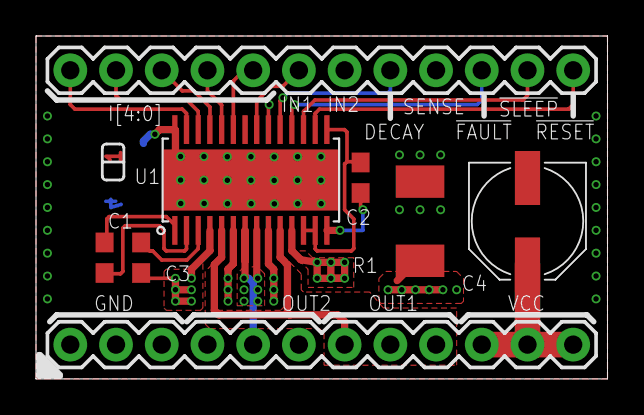
[picture p41: board microBoard_DRV8842.brd from above]

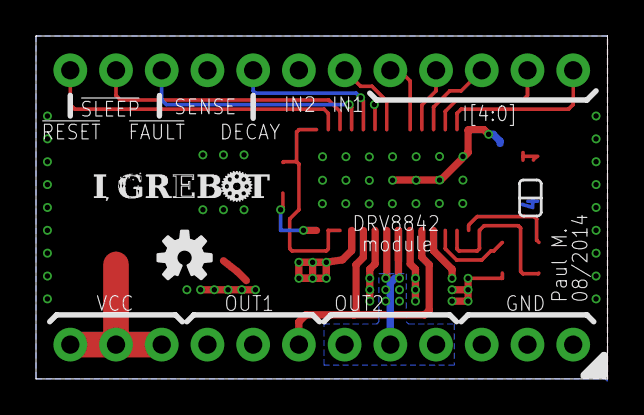
[picture p42: board microBoard_DRV8842.brd from below]

Board: 4 copper layers, 31.8 x 19.1 mm, 11 parts (2 on the bottom side), 20 nets.
