I-Grebot/elec_microboard/src/Main/microBoard_main.brd

## EAGLE design src/Main/microBoard_main.brd (2016-11-11)

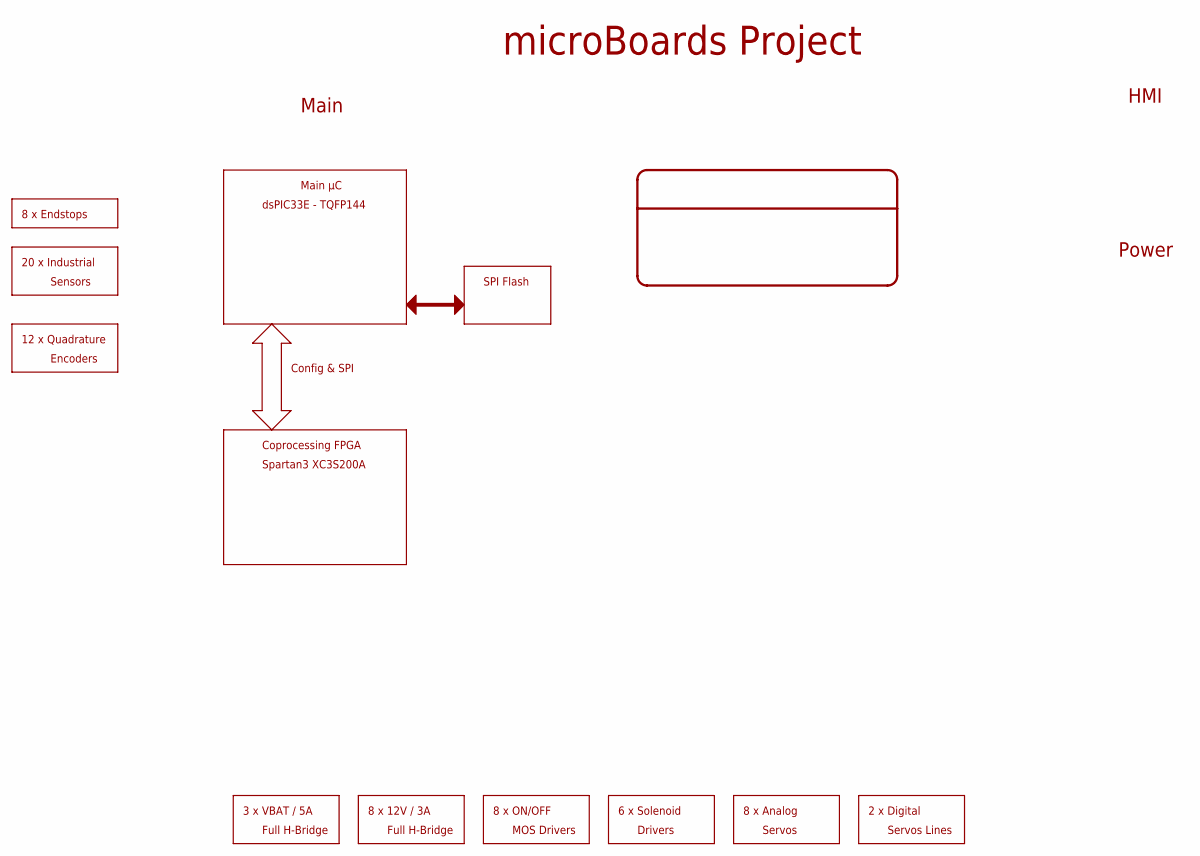
[picture p43: schematic microBoard_main.sch, sheet 1, Project Environment]

Notes on the sheet:
microBoards Project
Main
Power
HMI
dsPIC33E - TQFP144
Main µC
Coprocessing FPGA
Spartan3 XC3S200A
SPI Flash
Config & SPI
12 x Quadrature
Encoders
20 x Industrial
Sensors
8 x Endstops
8 x Analog
Servos
2 x Digital
Servos Lines
3 x VBAT / 5A
Full H-Bridge
8 x 12V / 3A
8 x ON/OFF
MOS Drivers
6 x Solenoid
Drivers

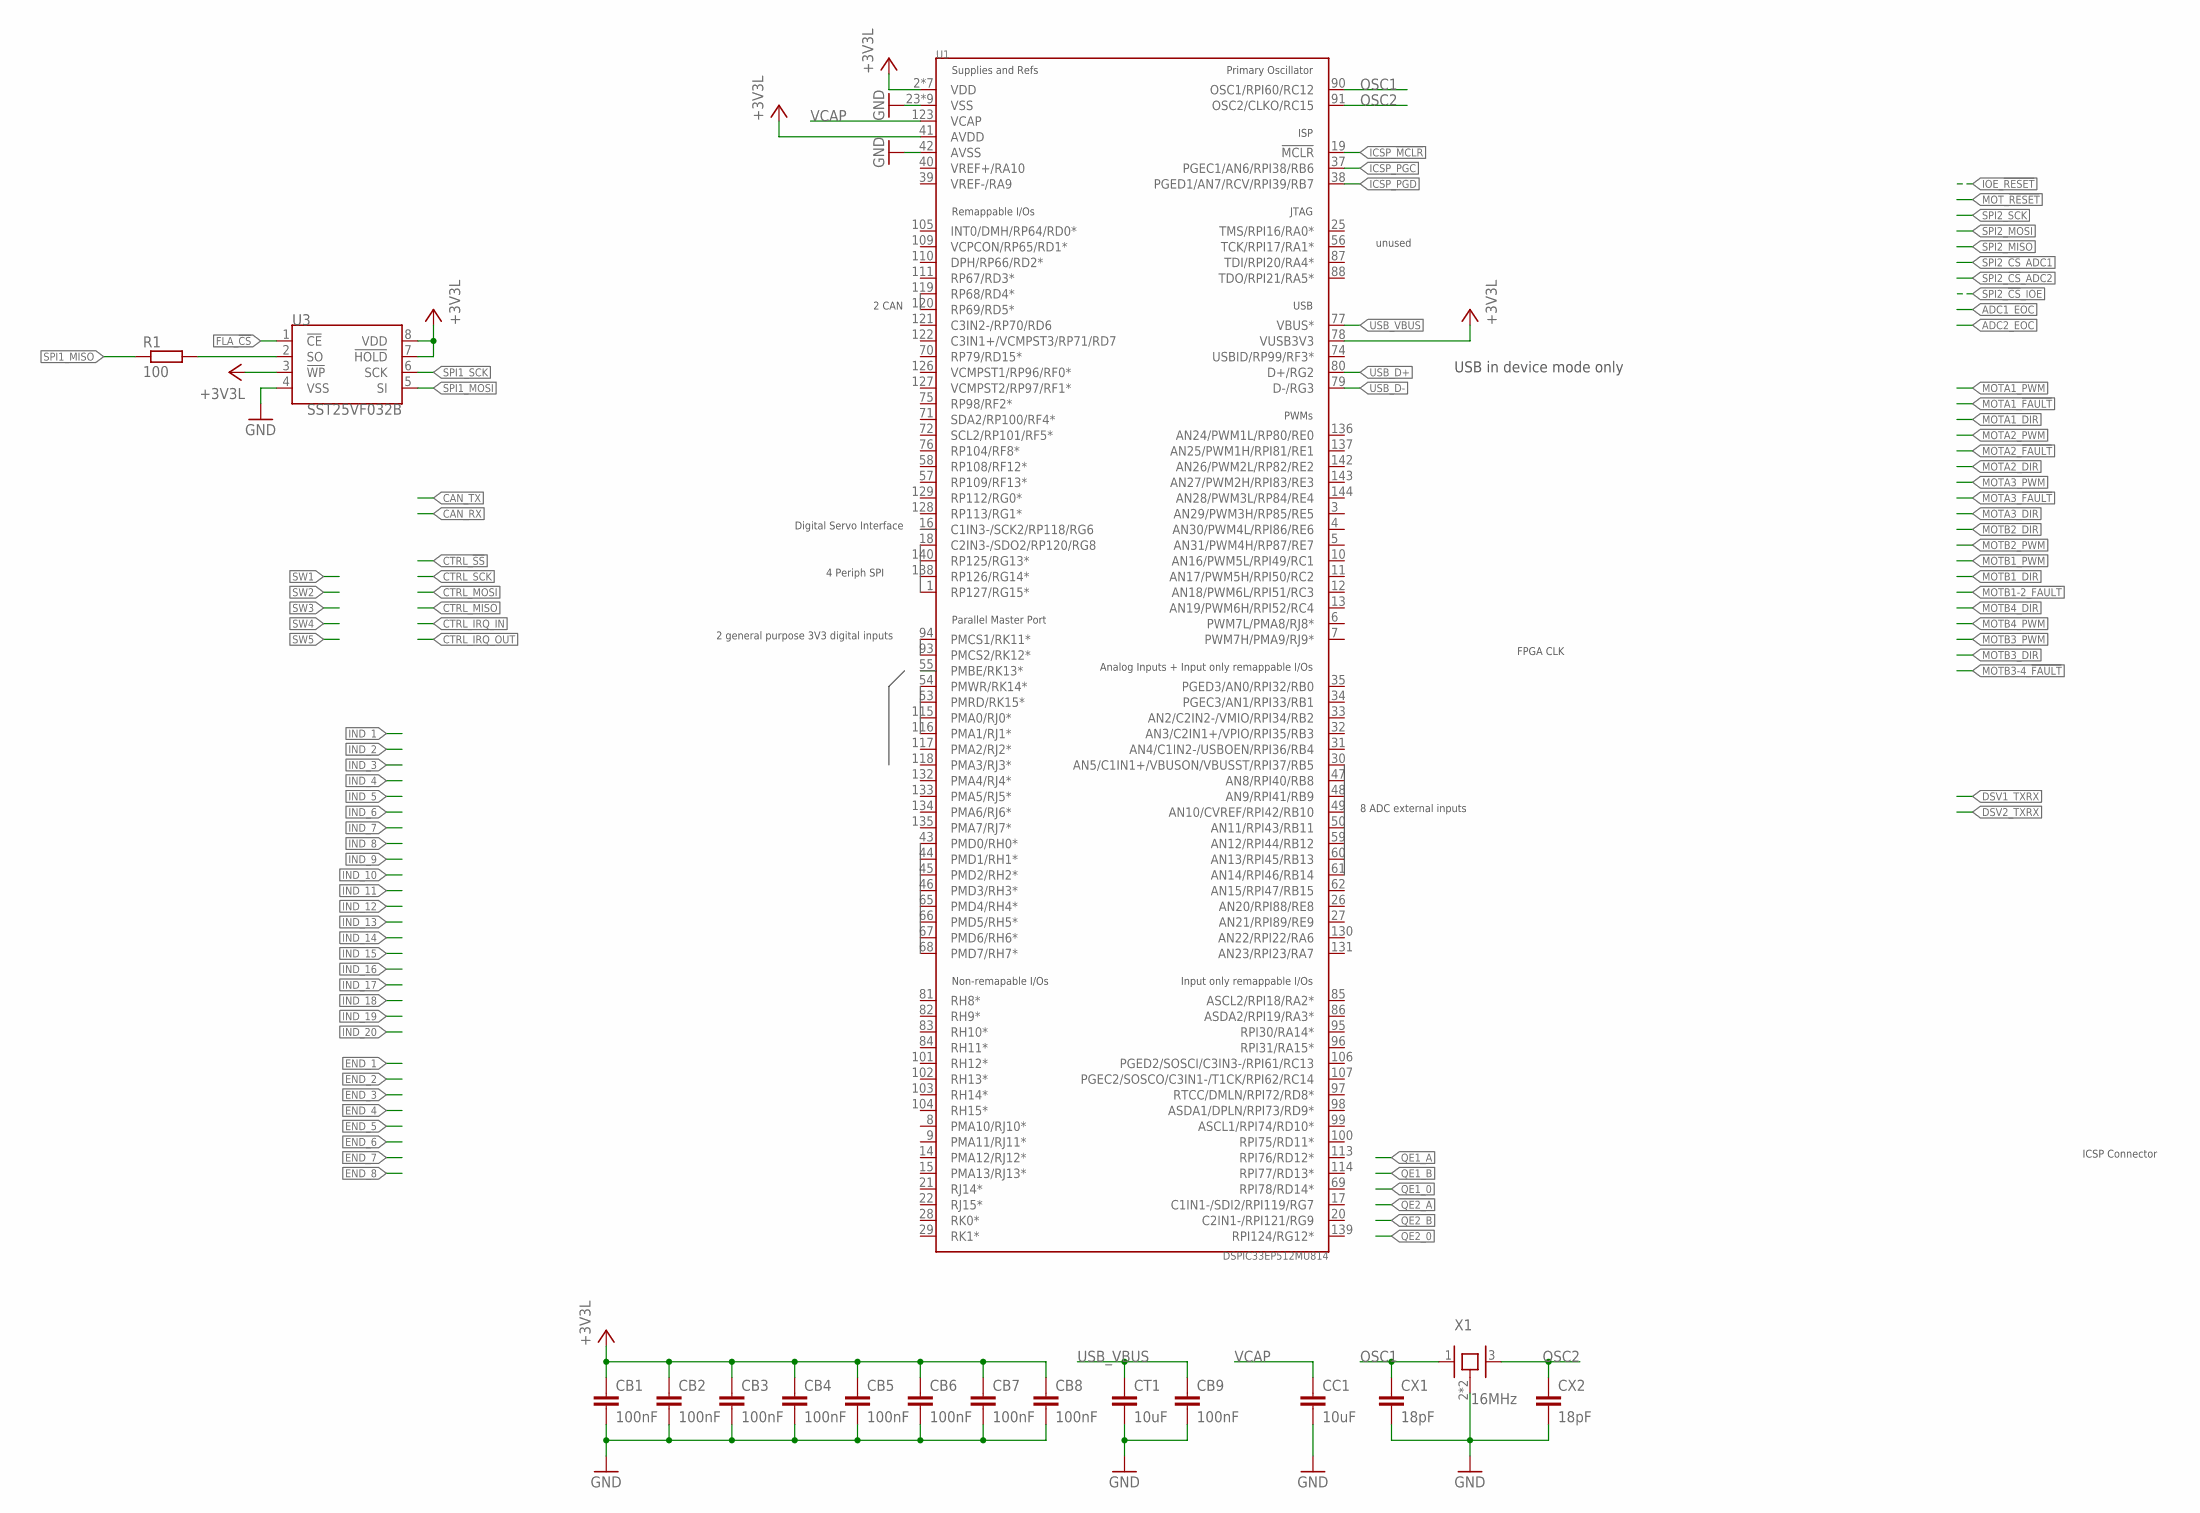
[picture p44: schematic microBoard_main.sch, sheet 2, Main µC dsPIC33E]

Parts:
CB1, CB2, CB3, CB4, CB5, CB6, CB7, CB8, CB9: 100nF; C0603
CC1: 10uF; C1210
CT1: 10uF; C1210
CX1, CX2: 18pF; C0603
R1: 100; R0603
U1: DSPIC33EP512MU814; TQFP_144
U3: SST25VF032B; SOIC_8
X1: 16MHz; CRYSTAL-OSC-SMD-5X3

Connections:
+3V3L: CB1.1, CB2.1, CB3.1, CB4.1, CB5.1, CB6.1, CB7.1, CB8.1, U1.2 (VDD), U1.24 (VDD), U1.41 (AVDD), U1.52 (VDD), U1.64 (VDD), U1.78 (VUSB3V3), U1.89 (VDD), U1.112 (VDD), U1.124 (VDD), U3.3 (!WP!), U3.7 (!HOLD!), U3.8 (VDD); also elsewhere on the board
FLA_!CS!: U3.1 (!CE!)
GND: CB1.2, CB2.2, CB3.2, CB4.2, CB5.2, CB6.2, CB7.2, CB8.2, CB9.2, CC1.2, CT1.2, CX1.2, CX2.2, U1.23 (VSS), U1.36 (VSS), U1.42 (AVSS), U1.51 (VSS), U1.63 (VSS), U1.73 (VSS), U1.92 (VSS), U1.108 (VSS), U1.125 (VSS), U1.141 (VSS), U3.4 (VSS), X1.2, X1.4; also elsewhere on the board
ICSP_!MCLR!: U1.19 (!MCLR!); also elsewhere on the board
ICSP_PGC: U1.37 (PGEC1/AN6/RPI38/RB6); also elsewhere on the board
ICSP_PGD: U1.38 (PGED1/AN7/RCV/RPI39/RB7); also elsewhere on the board
unnamed: R1.2, U3.2 (SO)
OSC1: CX1.1, U1.90 (OSC1/RPI60/RC12), X1.1
OSC2: CX2.1, U1.91 (OSC2/CLKO/RC15), X1.3
SPI1_MISO: R1.1
SPI1_MOSI: U3.5 (SI)
SPI1_SCK: U3.6 (SCK)
USB_D+: U1.80 (D+/RG2)
USB_D-: U1.79 (D-/RG3)
USB_VBUS: CB9.1, CT1.1, U1.77 (VBUS*)
VCAP: CC1.1, U1.123 (VCAP)

Notes on the sheet:
USB in device mode only
unused
2 general purpose 3V3 digital inputs
Digital Servo Interface
2 CAN
4 Periph SPI
8 ADC external inputs
FPGA CLK
ICSP Connector
