I-Grebot/elec_microboard/src/Main/microBoard_main.brd

## EAGLE design src/Main/microBoard_main.brd (continued)

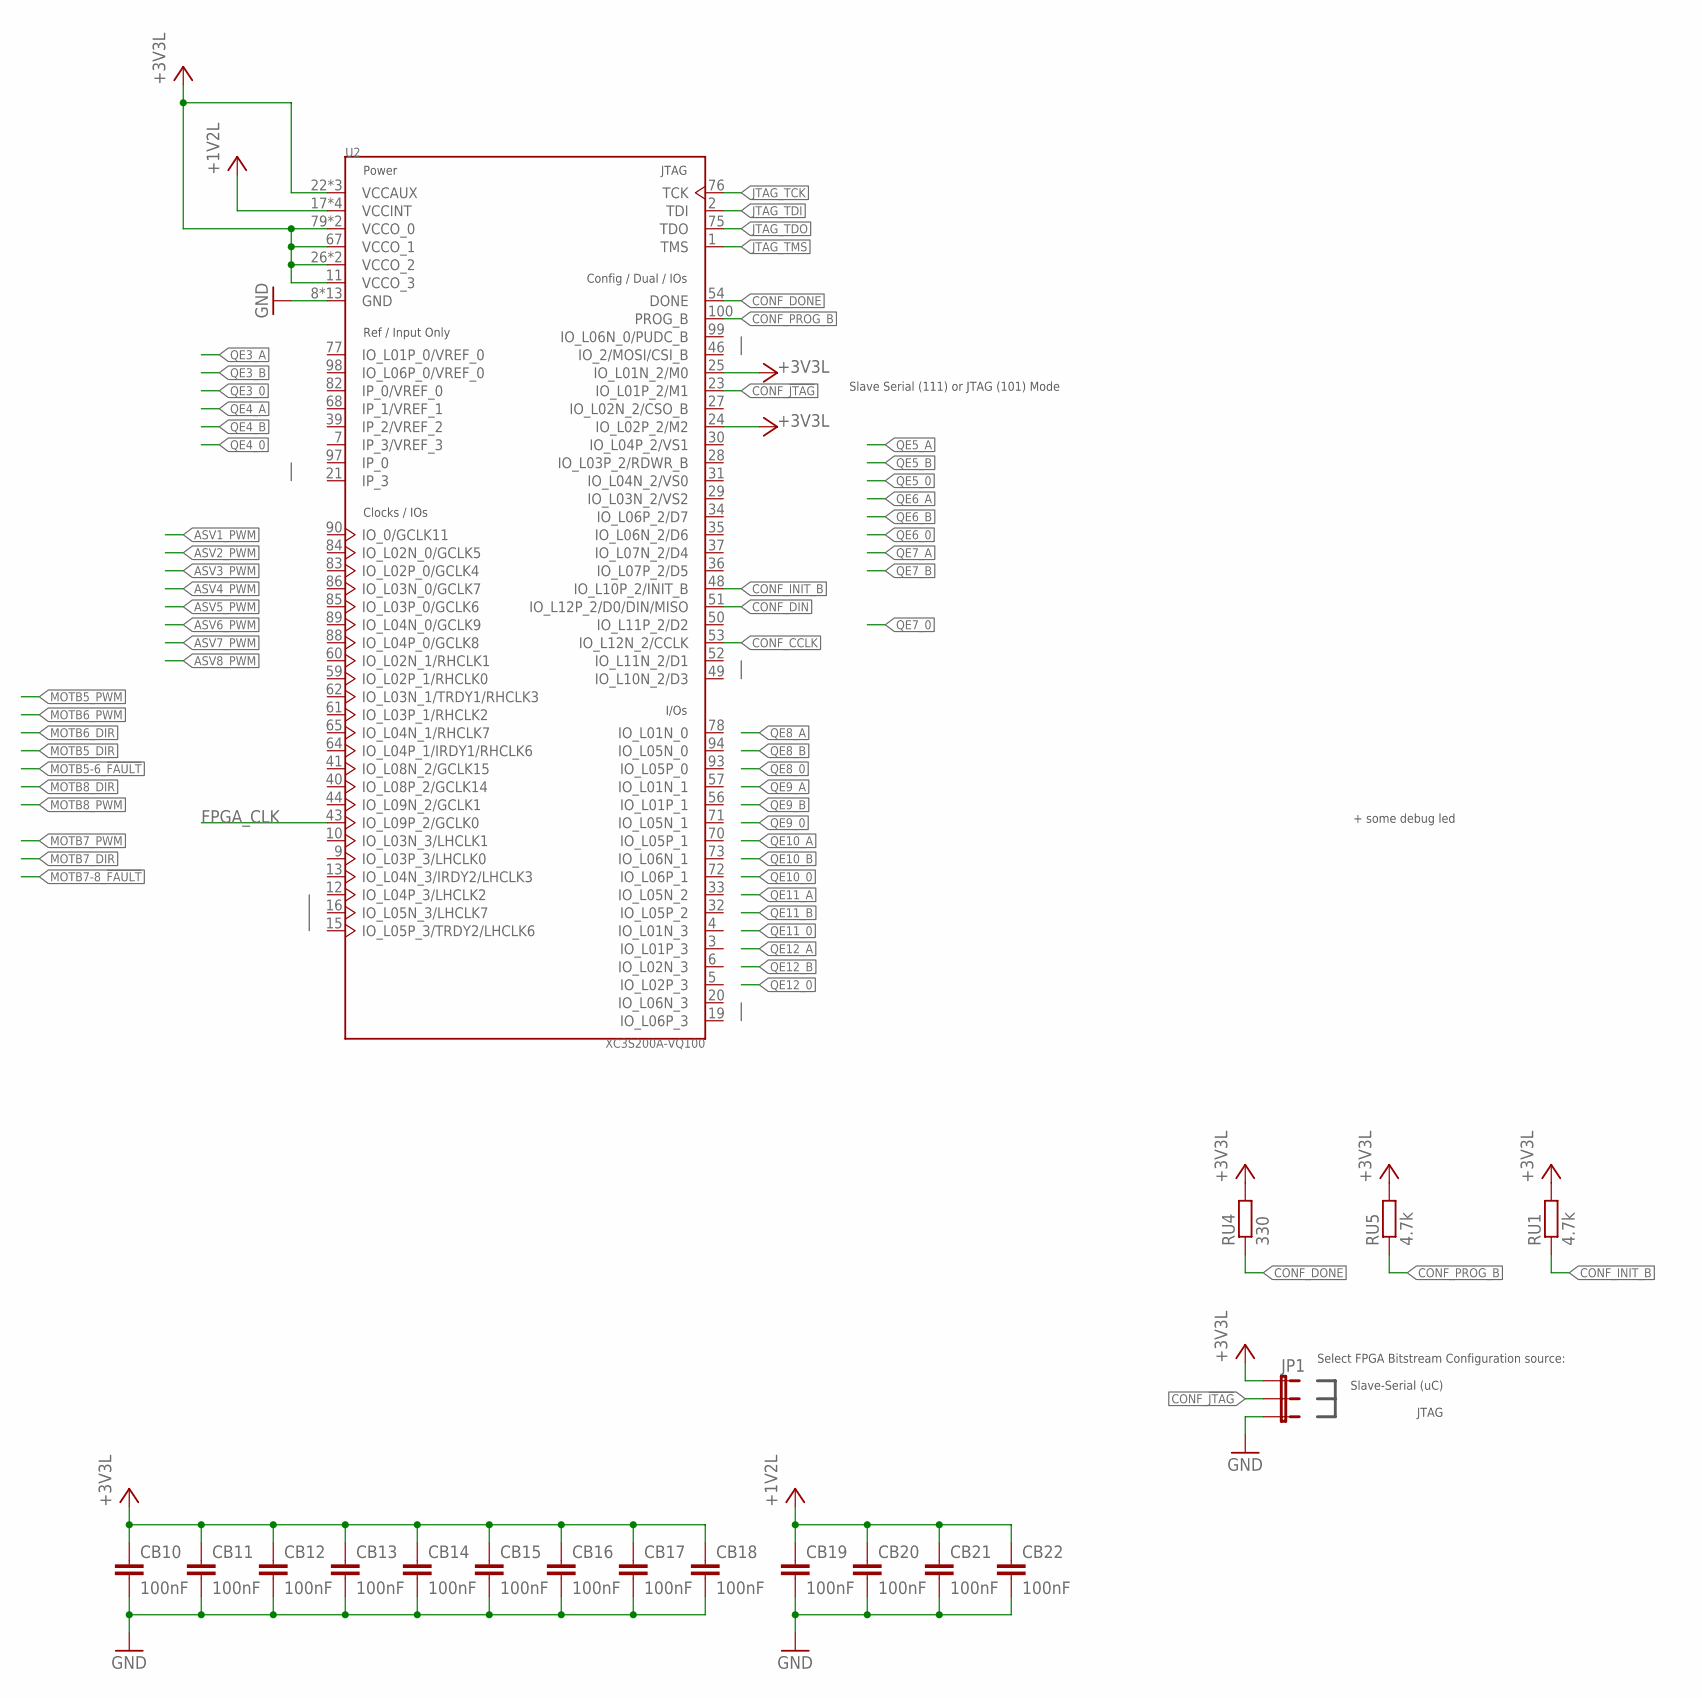
[picture p45: schematic microBoard_main.sch, sheet 3, FPGA Spartan3]

Parts:
CB10, CB11, CB12, CB13, CB14, CB15, CB16, CB17, CB18, CB19, CB20, CB21, CB22: 100nF; C0603
JP1: JUMPER-3PTH; 1X03
RU1, RU5: 4.7k; R0603
RU4: 330; R0603
U2: XC3S200A-VQ100; VQFP_100

Connections:
+1V2L: CB19.1, CB20.1, CB21.1, CB22.1, U2.17 (VCCINT), U2.38 (VCCINT), U2.66 (VCCINT), U2.81 (VCCINT); also elsewhere on the board
+3V3L: CB10.1, CB11.1, CB12.1, CB13.1, CB14.1, CB15.1, CB16.1, CB17.1, CB18.1, JP1.1, RU1.2, RU4.2, RU5.2, U2.11 (VCCO_3), U2.22 (VCCAUX), U2.24 (IO_L02P_2/M2), U2.25 (IO_L01N_2/M0), U2.26 (VCCO_2), U2.45 (VCCO_2), U2.55 (VCCAUX), U2.67 (VCCO_1), U2.79 (VCCO_0), U2.92 (VCCAUX), U2.96 (VCCO_0); also elsewhere on the board
CONF_!JTAG!: JP1.2, U2.23 (IO_L01P_2/M1)
CONF_CCLK: U2.53 (IO_L12N_2/CCLK)
CONF_DIN: U2.51 (IO_L12P_2/D0/DIN/MISO)
CONF_DONE: RU4.1, U2.54 (DONE)
CONF_INIT_B: RU1.1, U2.48 (IO_L10P_2/INIT_B)
CONF_PROG_B: RU5.1, U2.100 (PROG_B)
FPGA_CLK: U2.43 (IO_L09P_2/GCLK0)
GND: CB10.2, CB11.2, CB12.2, CB13.2, CB14.2, CB15.2, CB16.2, CB17.2, CB18.2, CB19.2, CB20.2, CB21.2, CB22.2, JP1.3, U2.8 (GND), U2.14 (GND), U2.18 (GND), U2.42 (GND), U2.47 (GND), U2.58 (GND), U2.63 (GND), U2.69 (GND), U2.74 (GND), U2.80 (GND), U2.87 (GND), U2.91 (GND), U2.95 (GND); also elsewhere on the board
JTAG_TCK: U2.76 (TCK); also elsewhere on the board
JTAG_TDI: U2.2 (TDI); also elsewhere on the board
JTAG_TDO: U2.75 (TDO); also elsewhere on the board
JTAG_TMS: U2.1 (TMS); also elsewhere on the board

Notes on the sheet:
Slave Serial (111) or JTAG (101) Mode
Slave-Serial (uC)
JTAG
Select FPGA Bitstream Configuration source:
+ some debug led

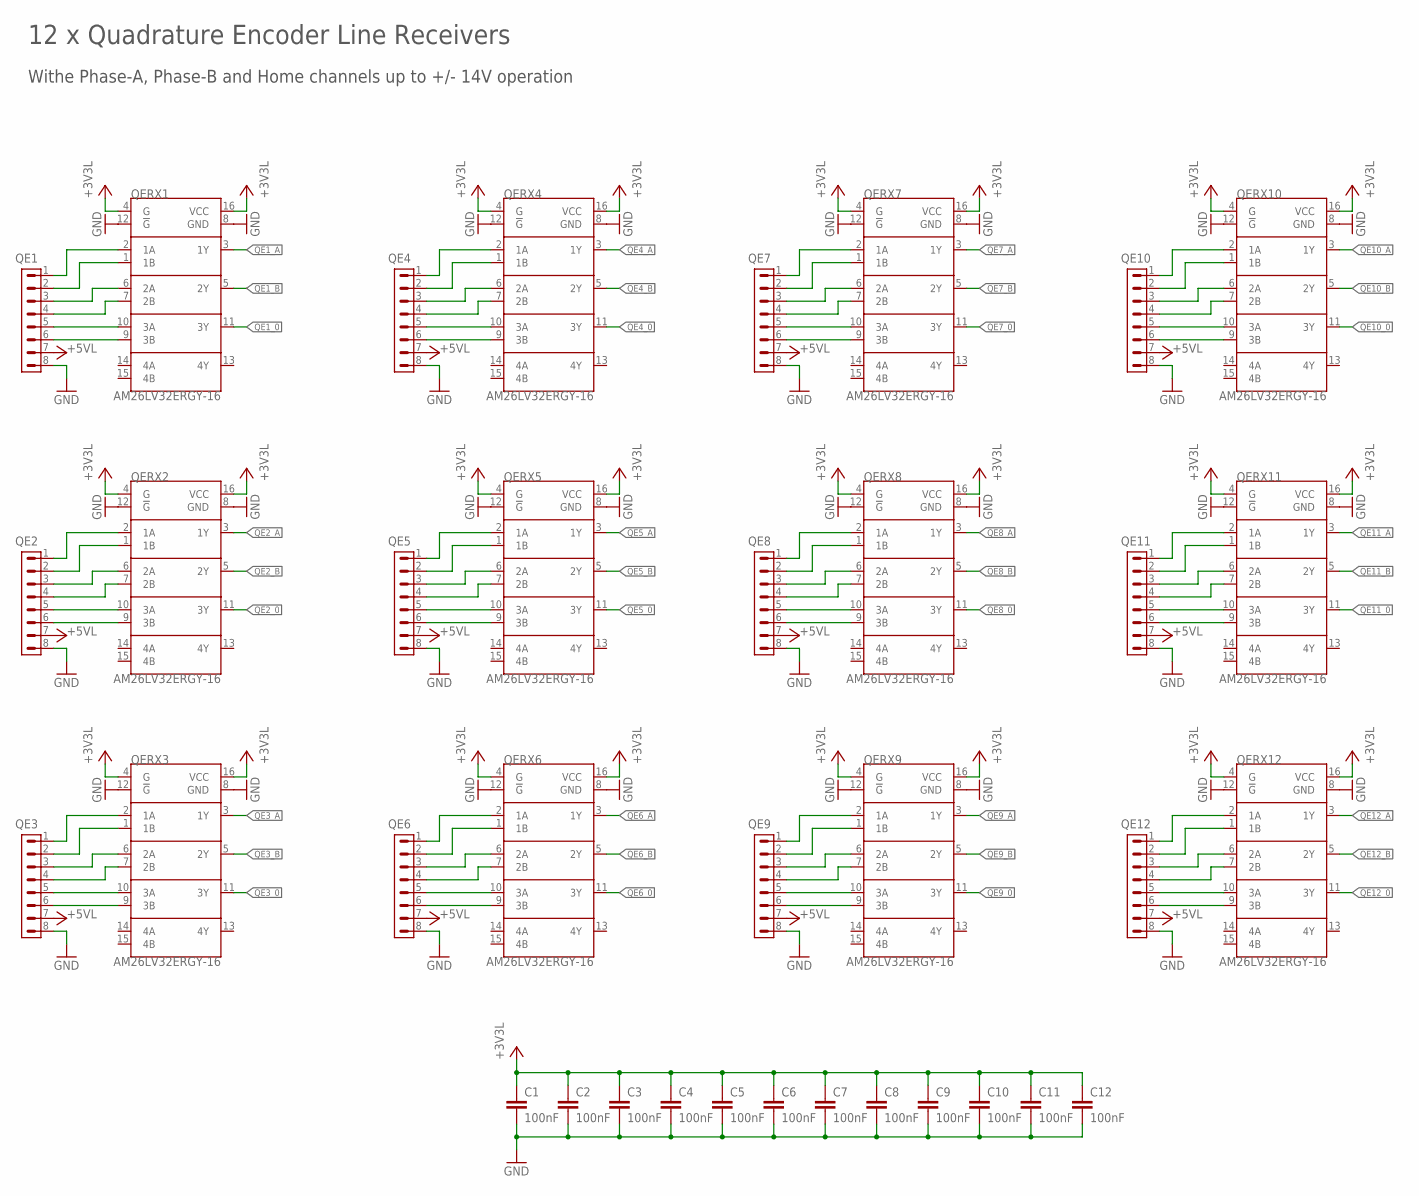
[picture p46: schematic microBoard_main.sch, sheet 4, Quadrature Encoders Line Receivers]

Parts:
C1, C2, C3, C4, C5, C6, C7, C8, C9, C10, C11, C12: 100nF; C0603
QE1, QE2, QE3, QE4, QE5, QE6, QE7, QE8, QE9, QE10, QE11, QE12: CON_1.27_8
QERX1, QERX2, QERX3, QERX4, QERX5, QERX6, QERX7, QERX8, QERX9, QERX10, QERX11, QERX12: AM26LV32ERGY-16; RGY_16

Connections:
+3V3L: C1.1, C2.1, C3.1, C4.1, C5.1, C6.1, QERX1.4 (G), QERX1.16 (VCC), QERX2.4 (G), QERX2.16 (VCC), QERX3.4 (G), QERX3.16 (VCC), QERX4.4 (G), QERX4.16 (VCC), QERX5.4 (G), QERX5.16 (VCC), QERX6.4 (G), QERX6.16 (VCC), QERX7.4 (G), QERX7.16 (VCC), QERX8.4 (G), QERX8.16 (VCC), QERX9.4 (G), QERX9.16 (VCC), QERX10.4 (G), QERX10.16 (VCC), QERX11.4 (G), QERX11.16 (VCC), QERX12.4 (G), QERX12.16 (VCC); also elsewhere on the board
+3V3L1: C7.1, C8.1, C9.1, C10.1, C11.1, C12.1
+5VL: QE1.7, QE2.7, QE3.7, QE4.7, QE5.7, QE6.7, QE7.7, QE8.7, QE9.7, QE10.7, QE11.7, QE12.7; also elsewhere on the board
GND: C1.2, C2.2, C3.2, C4.2, C5.2, C6.2, QE1.8, QE2.8, QE3.8, QE4.8, QE5.8, QE6.8, QE7.8, QE8.8, QE9.8, QE10.8, QE11.8, QE12.8, QERX1.8 (GND), QERX1.12 (!G!), QERX2.8 (GND), QERX2.12 (!G!), QERX3.8 (GND), QERX3.12 (!G!), QERX4.8 (GND), QERX4.12 (!G!), QERX5.8 (GND), QERX5.12 (!G!), QERX6.8 (GND), QERX6.12 (!G!), QERX7.8 (GND), QERX7.12 (!G!), QERX8.8 (GND), QERX8.12 (!G!), QERX9.8 (GND), QERX9.12 (!G!), QERX10.8 (GND), QERX10.12 (!G!), QERX11.8 (GND), QERX11.12 (!G!), QERX12.8 (GND), QERX12.12 (!G!); also elsewhere on the board
GND1: C7.2, C8.2, C9.2, C10.2, C11.2, C12.2
unnamed: QE1.4, QERX1.7 (2B)
unnamed: QE1.3, QERX1.6 (2A)
unnamed: QE1.5, QERX1.10 (3A)
unnamed: QE1.6, QERX1.9 (3B)
unnamed: QE1.2, QERX1.1 (1B)
unnamed: QE1.1, QERX1.2 (1A)
unnamed: QE2.5, QERX2.10 (3A)
unnamed: QE2.6, QERX2.9 (3B)
unnamed: QE2.2, QERX2.1 (1B)
unnamed: QE2.1, QERX2.2 (1A)
unnamed: QE2.4, QERX2.7 (2B)
unnamed: QE2.3, QERX2.6 (2A)
unnamed: QE3.5, QERX3.10 (3A)
unnamed: QE3.6, QERX3.9 (3B)
unnamed: QE3.2, QERX3.1 (1B)
unnamed: QE3.1, QERX3.2 (1A)
unnamed: QE3.4, QERX3.7 (2B)
unnamed: QE3.3, QERX3.6 (2A)
unnamed: QE4.5, QERX4.10 (3A)
unnamed: QE4.6, QERX4.9 (3B)
unnamed: QE4.2, QERX4.1 (1B)
unnamed: QE4.1, QERX4.2 (1A)
unnamed: QE4.4, QERX4.7 (2B)
unnamed: QE4.3, QERX4.6 (2A)
unnamed: QE5.5, QERX5.10 (3A)
unnamed: QE5.6, QERX5.9 (3B)
unnamed: QE5.2, QERX5.1 (1B)
unnamed: QE5.1, QERX5.2 (1A)
unnamed: QE5.4, QERX5.7 (2B)
unnamed: QE5.3, QERX5.6 (2A)
unnamed: QE6.5, QERX6.10 (3A)
unnamed: QE6.6, QERX6.9 (3B)
unnamed: QE6.2, QERX6.1 (1B)
unnamed: QE6.1, QERX6.2 (1A)
unnamed: QE6.4, QERX6.7 (2B)
unnamed: QE6.3, QERX6.6 (2A)
unnamed: QE7.5, QERX7.10 (3A)
unnamed: QE7.6, QERX7.9 (3B)
unnamed: QE7.2, QERX7.1 (1B)
unnamed: QE7.1, QERX7.2 (1A)
unnamed: QE7.4, QERX7.7 (2B)
unnamed: QE7.3, QERX7.6 (2A)
unnamed: QE8.5, QERX8.10 (3A)
unnamed: QE8.6, QERX8.9 (3B)
unnamed: QE8.2, QERX8.1 (1B)
unnamed: QE8.1, QERX8.2 (1A)
unnamed: QE8.4, QERX8.7 (2B)
unnamed: QE8.3, QERX8.6 (2A)
unnamed: QE9.5, QERX9.10 (3A)
unnamed: QE9.6, QERX9.9 (3B)
unnamed: QE9.2, QERX9.1 (1B)
unnamed: QE9.1, QERX9.2 (1A)
unnamed: QE9.4, QERX9.7 (2B)
unnamed: QE9.3, QERX9.6 (2A)
unnamed: QE10.5, QERX10.10 (3A)
unnamed: QE10.6, QERX10.9 (3B)
unnamed: QE10.2, QERX10.1 (1B)
unnamed: QE10.1, QERX10.2 (1A)
unnamed: QE10.4, QERX10.7 (2B)
unnamed: QE10.3, QERX10.6 (2A)
unnamed: QE11.5, QERX11.10 (3A)
unnamed: QE11.6, QERX11.9 (3B)
unnamed: QE11.2, QERX11.1 (1B)
unnamed: QE11.1, QERX11.2 (1A)
unnamed: QE11.4, QERX11.7 (2B)
unnamed: QE11.3, QERX11.6 (2A)
unnamed: QE12.5, QERX12.10 (3A)
unnamed: QE12.6, QERX12.9 (3B)
unnamed: QE12.2, QERX12.1 (1B)
unnamed: QE12.1, QERX12.2 (1A)
unnamed: QE12.4, QERX12.7 (2B)
unnamed: QE12.3, QERX12.6 (2A)
QE1_0: QERX1.11 (3Y)
QE1_A: QERX1.3 (1Y)
QE1_B: QERX1.5 (2Y)
QE2_0: QERX2.11 (3Y)
QE2_A: QERX2.3 (1Y)
QE2_B: QERX2.5 (2Y)
QE3_0: QERX3.11 (3Y)
QE3_A: QERX3.3 (1Y)
QE3_B: QERX3.5 (2Y)
QE4_0: QERX4.11 (3Y)
QE4_A: QERX4.3 (1Y)
QE4_B: QERX4.5 (2Y)
QE5_0: QERX5.11 (3Y)
QE5_A: QERX5.3 (1Y)
QE5_B: QERX5.5 (2Y)
QE6_0: QERX6.11 (3Y)
QE6_A: QERX6.3 (1Y)
QE6_B: QERX6.5 (2Y)
QE7_0: QERX7.11 (3Y)
QE7_A: QERX7.3 (1Y)
QE7_B: QERX7.5 (2Y)
QE8_0: QERX8.11 (3Y)
QE8_A: QERX8.3 (1Y)
QE8_B: QERX8.5 (2Y)
QE9_0: QERX9.11 (3Y)
QE9_A: QERX9.3 (1Y)
QE9_B: QERX9.5 (2Y)
QE10_0: QERX10.11 (3Y)
QE10_A: QERX10.3 (1Y)
QE10_B: QERX10.5 (2Y)
QE11_0: QERX11.11 (3Y)
QE11_A: QERX11.3 (1Y)
QE11_B: QERX11.5 (2Y)
QE12_0: QERX12.11 (3Y)
QE12_A: QERX12.3 (1Y)
QE12_B: QERX12.5 (2Y)

Notes on the sheet:
12 x Quadrature Encoder Line Receivers
Withe Phase-A, Phase-B and Home channels up to +/- 14V operation

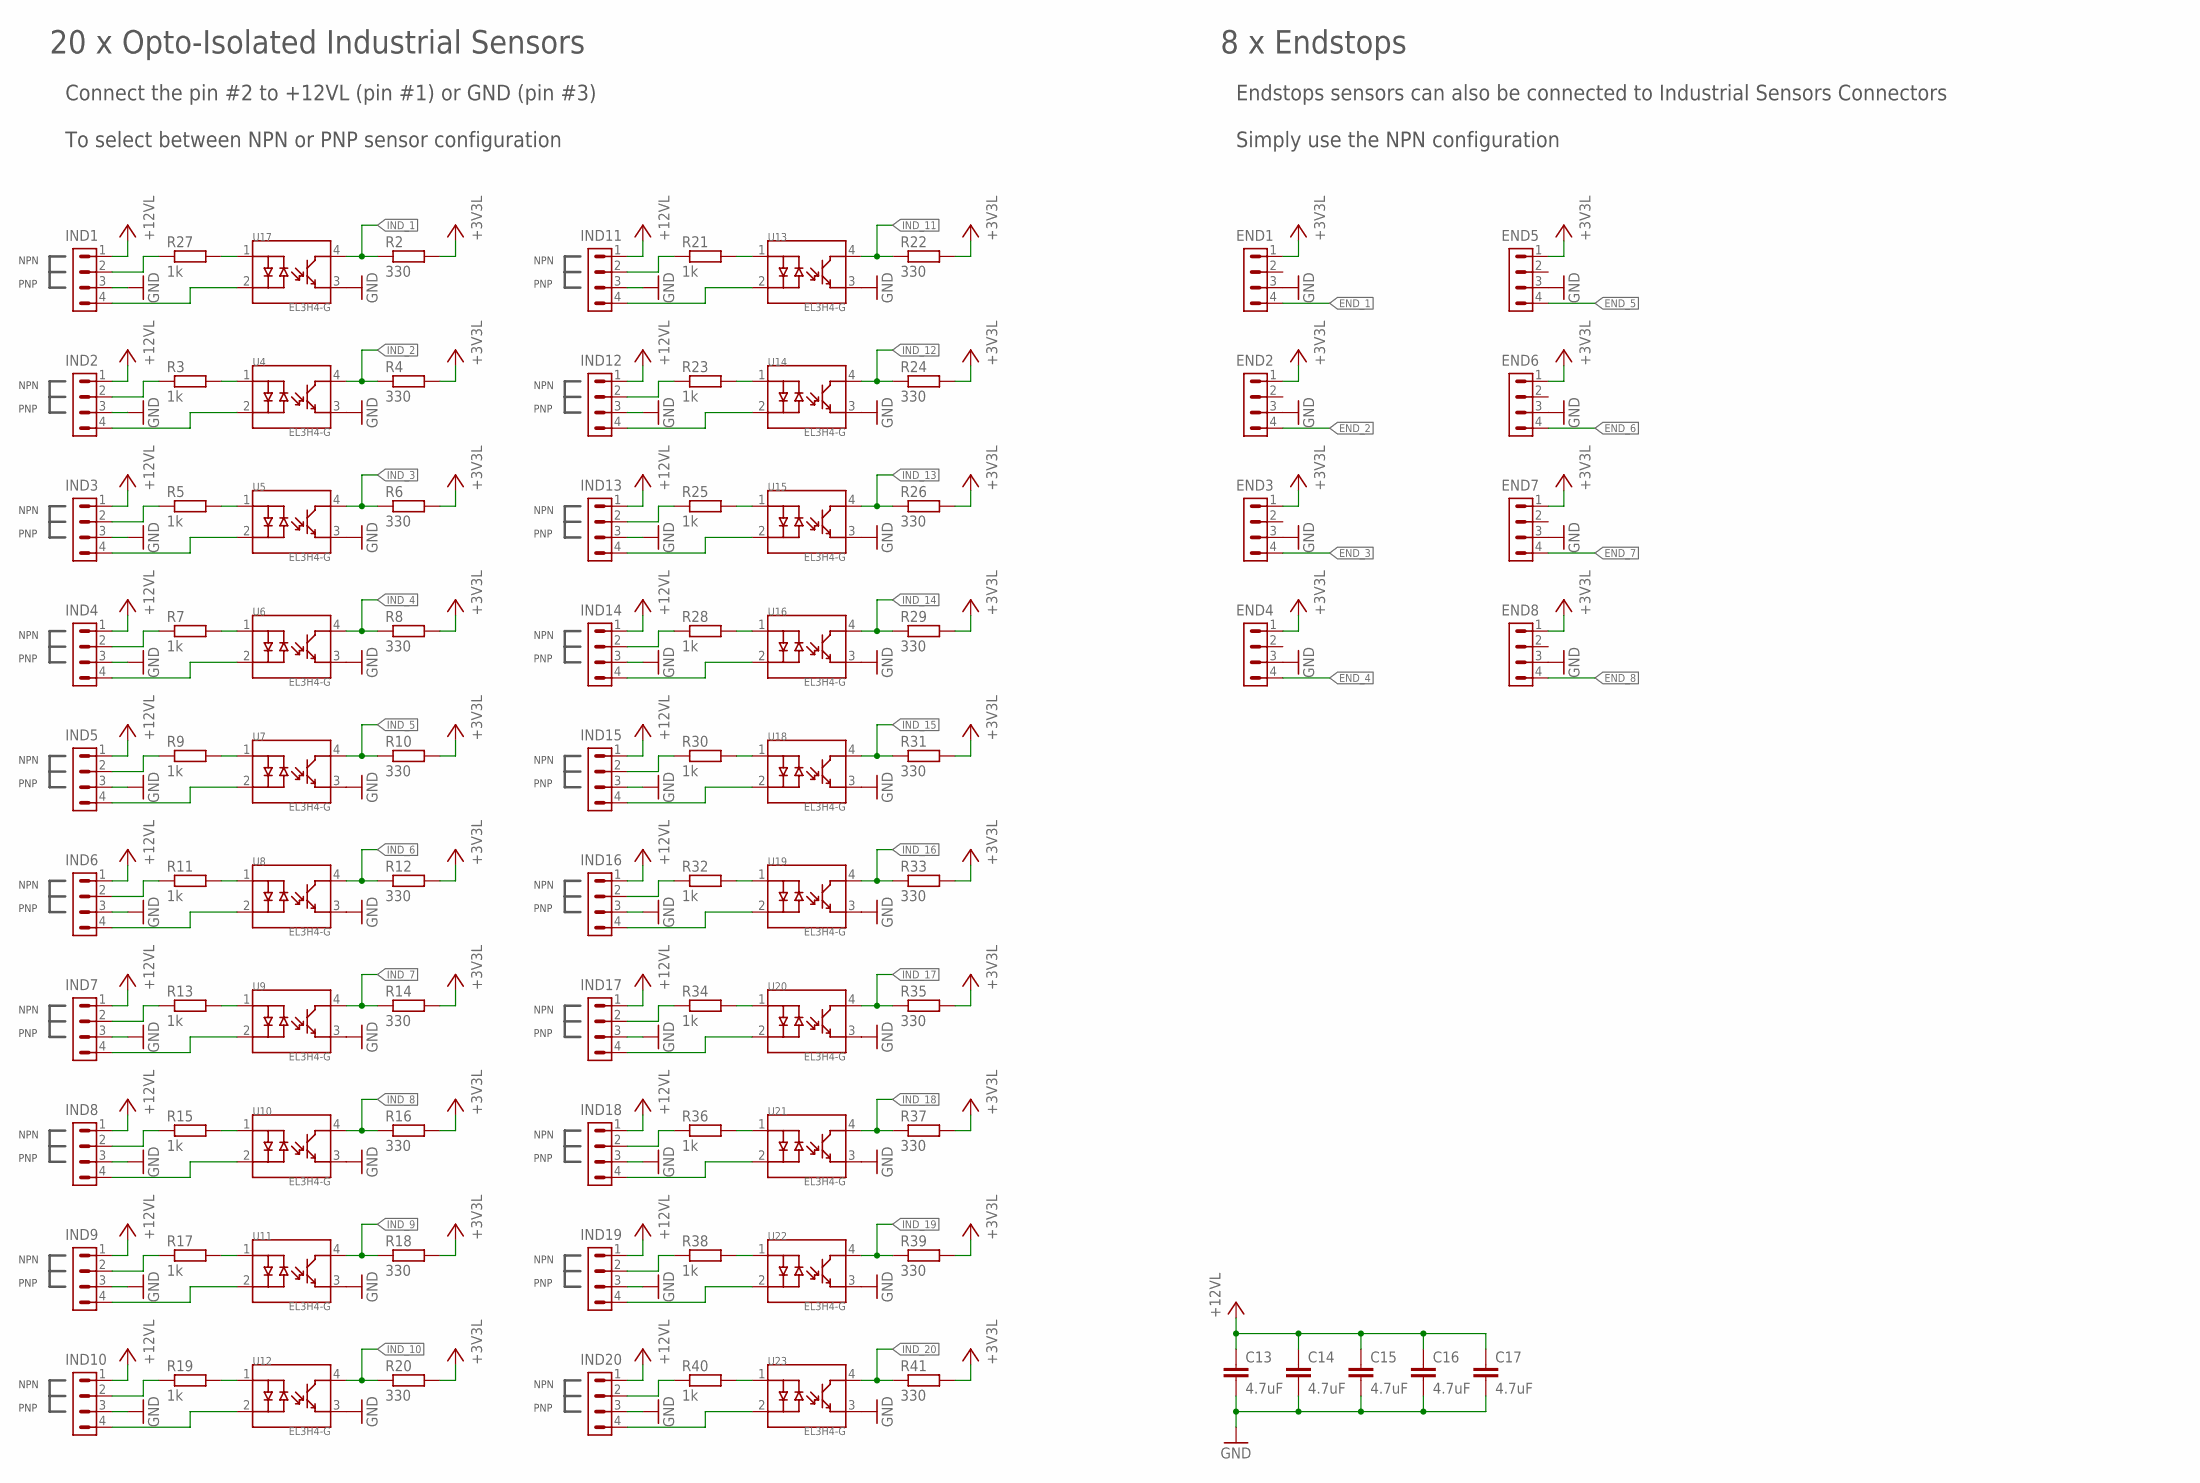
[picture p47: schematic microBoard_main.sch, sheet 5, Sensors Interfaces]

Parts:
C13, C14, C15, C16, C17: 4.7uF; C1206
END1, END2, END3, END4, END5, END6, END7, END8: CON_1.27_4
IND1, IND2, IND3, IND4, IND5, IND6, IND7, IND8, IND9, IND10, IND11, IND12, IND13, IND14, IND15, IND16, IND17, IND18, IND19, IND20: CON_1.27_4
R2, R4, R6, R8, R10, R12, R14, R16, R18, R20, R22, R24, R26, R29, R31, R33, R35, R37, R39, R41: 330; R0603
R3, R5, R7, R9, R11, R13, R15, R17, R19, R21, R23, R25, R27, R28, R30, R32, R34, R36, R38, R40: 1k; R0603
U4, U5, U6, U7, U8, U9, U10, U11, U12, U13, U14, U15, U16, U17, U18, U19, U20, U21, U22, U23: EL3H4-G; SSOP_4

Connections:
+3V3L: END1.1, END2.1, END3.1, END4.1, END5.1, END6.1, END7.1, END8.1, R2.2, R4.2, R6.2, R8.2, R10.2, R12.2, R14.2, R16.2, R18.2, R20.2, R22.2, R24.2, R26.2, R29.2, R31.2, R33.2, R35.2, R37.2, R39.2, R41.2; also elsewhere on the board
+12VL: C13.1, C14.1, C15.1, C16.1, C17.1, IND1.1, IND2.1, IND3.1, IND4.1, IND5.1, IND6.1, IND7.1, IND8.1, IND9.1, IND10.1, IND11.1, IND12.1, IND13.1, IND14.1, IND15.1, IND16.1, IND17.1, IND18.1, IND19.1, IND20.1; also elsewhere on the board
END_1: END1.4
END_2: END2.4
END_3: END3.4
END_4: END4.4
END_5: END5.4
END_6: END6.4
END_7: END7.4
END_8: END8.4
GND: C13.2, C14.2, C15.2, C16.2, C17.2, END1.3, END2.3, END3.3, END4.3, END5.3, END6.3, END7.3, END8.3, IND1.3, IND2.3, IND3.3, IND4.3, IND5.3, IND6.3, IND7.3, IND8.3, IND9.3, IND10.3, IND11.3, IND12.3, IND13.3, IND14.3, IND15.3, IND16.3, IND17.3, IND18.3, IND19.3, IND20.3, U4.3, U5.3, U6.3, U7.3, U8.3, U9.3, U10.3, U11.3, U12.3, U13.3, U14.3, U15.3, U16.3, U17.3, U18.3, U19.3, U20.3, U21.3, U22.3, U23.3; also elsewhere on the board
IND_1: R2.1, U17.4
IND_2: R4.1, U4.4
IND_3: R6.1, U5.4
IND_4: R8.1, U6.4
IND_5: R10.1, U7.4
IND_6: R12.1, U8.4
IND_7: R14.1, U9.4
IND_8: R16.1, U10.4
IND_9: R18.1, U11.4
IND_10: R20.1, U12.4
IND_11: R22.1, U13.4
IND_12: R24.1, U14.4
IND_13: R26.1, U15.4
IND_14: R29.1, U16.4
IND_15: R31.1, U18.4
IND_16: R33.1, U19.4
IND_17: R35.1, U20.4
IND_18: R37.1, U21.4
IND_19: R39.1, U22.4
IND_20: R41.1, U23.4
unnamed: IND1.4, U17.2
unnamed: IND1.2, R27.1
unnamed: R27.2, U17.1
unnamed: IND2.2, R3.1
unnamed: R3.2, U4.1
unnamed: IND2.4, U4.2
unnamed: IND3.2, R5.1
unnamed: R5.2, U5.1
unnamed: IND3.4, U5.2
unnamed: IND4.2, R7.1
unnamed: R7.2, U6.1
unnamed: IND4.4, U6.2
unnamed: IND5.2, R9.1
unnamed: R9.2, U7.1
unnamed: IND5.4, U7.2
unnamed: IND6.2, R11.1
unnamed: R11.2, U8.1
unnamed: IND6.4, U8.2
unnamed: IND7.2, R13.1
unnamed: R13.2, U9.1
unnamed: IND7.4, U9.2
unnamed: IND8.2, R15.1
unnamed: R15.2, U10.1
unnamed: IND8.4, U10.2
unnamed: IND9.2, R17.1
unnamed: R17.2, U11.1
unnamed: IND9.4, U11.2
unnamed: IND10.2, R19.1
unnamed: R19.2, U12.1
unnamed: IND10.4, U12.2
unnamed: IND11.2, R21.1
unnamed: R21.2, U13.1
unnamed: IND11.4, U13.2
unnamed: IND12.2, R23.1
unnamed: R23.2, U14.1
unnamed: IND12.4, U14.2
unnamed: IND13.2, R25.1
unnamed: R25.2, U15.1
unnamed: IND13.4, U15.2
unnamed: IND14.2, R28.1
unnamed: R28.2, U16.1
unnamed: IND14.4, U16.2
unnamed: IND15.2, R30.1
unnamed: R30.2, U18.1
unnamed: IND15.4, U18.2
unnamed: IND16.2, R32.1
unnamed: R32.2, U19.1
unnamed: IND16.4, U19.2
unnamed: IND17.2, R34.1
unnamed: R34.2, U20.1
unnamed: IND17.4, U20.2
unnamed: IND18.2, R36.1
unnamed: R36.2, U21.1
unnamed: IND18.4, U21.2
unnamed: IND19.2, R38.1
unnamed: R38.2, U22.1
unnamed: IND19.4, U22.2
unnamed: IND20.2, R40.1
unnamed: R40.2, U23.1
unnamed: IND20.4, U23.2

Notes on the sheet:
20 x Opto-Isolated Industrial Sensors
8 x Endstops
NPN
PNP
Connect the pin #2 to +12VL (pin #1) or GND (pin #3)
To select between NPN or PNP sensor configuration
Endstops sensors can also be connected to Industrial Sensors Connectors
Simply use the NPN configuration

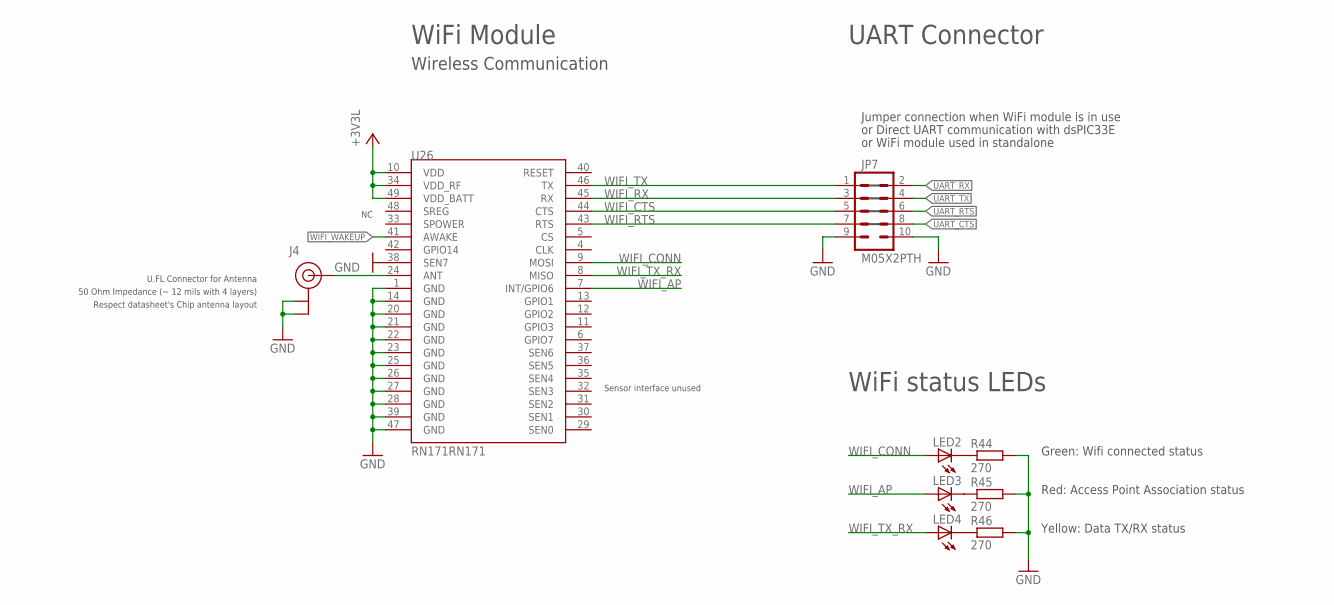
[picture p48: schematic microBoard_main.sch, sheet 6, WiFi module]

Parts:
J4: U.FL
JP7: M05X2PTH; AVR_ICSP
LED2, LED3, LED4: LEDCHIP-LED0805; CHIP-LED0805
R44, R45, R46: 270; R0603
U26: RN171RN171; RN171

Connections:
+3V3L: U26.10 (VDD), U26.34 (VDD_RF), U26.49 (VDD_BATT); also elsewhere on the board
GND: J4.P$1 (GND), J4.P$2 (GND), JP7.9, JP7.10, R44.2, R45.2, R46.2, U26.1 (GND), U26.14 (GND), U26.20 (GND), U26.21 (GND), U26.22 (GND), U26.23 (GND), U26.25 (GND), U26.26 (GND), U26.27 (GND), U26.28 (GND), U26.38 (SEN7), U26.39 (GND), U26.47 (GND); also elsewhere on the board
unnamed: LED2.C, R44.1
unnamed: LED3.C, R45.1
unnamed: LED4.C, R46.1
unnamed: J4.P$3 (SIGNAL), U26.24 (ANT)
UART_CTS: JP7.8
UART_RTS: JP7.6
UART_RX: JP7.2
UART_TX: JP7.4
WIFI_AP: LED3.A, U26.7 (INT/GPIO6)
WIFI_CONN: LED2.A, U26.9 (MOSI)
WIFI_CTS: JP7.5, U26.44 (CTS)
WIFI_RTS: JP7.7, U26.43 (RTS)
WIFI_RX: JP7.3, U26.45 (RX)
WIFI_TX: JP7.1, U26.46 (TX)
WIFI_TX_RX: LED4.A, U26.8 (MISO)
WIFI_WAKEUP: U26.41 (AWAKE)

Notes on the sheet:
Wireless Communication
WiFi Module
UART Connector
Sensor interface unused
50 Ohm Impedance (~ 12 mils with 4 layers)
Green: Wifi connected status
Yellow: Data TX/RX status
Red: Access Point Association status
Respect datasheet's Chip antenna layout
U.FL Connector for Antenna
Jumper connection when WiFi module is in use
or Direct UART communication with dsPIC33E
or WiFi module used in standalone
WiFi status LEDs

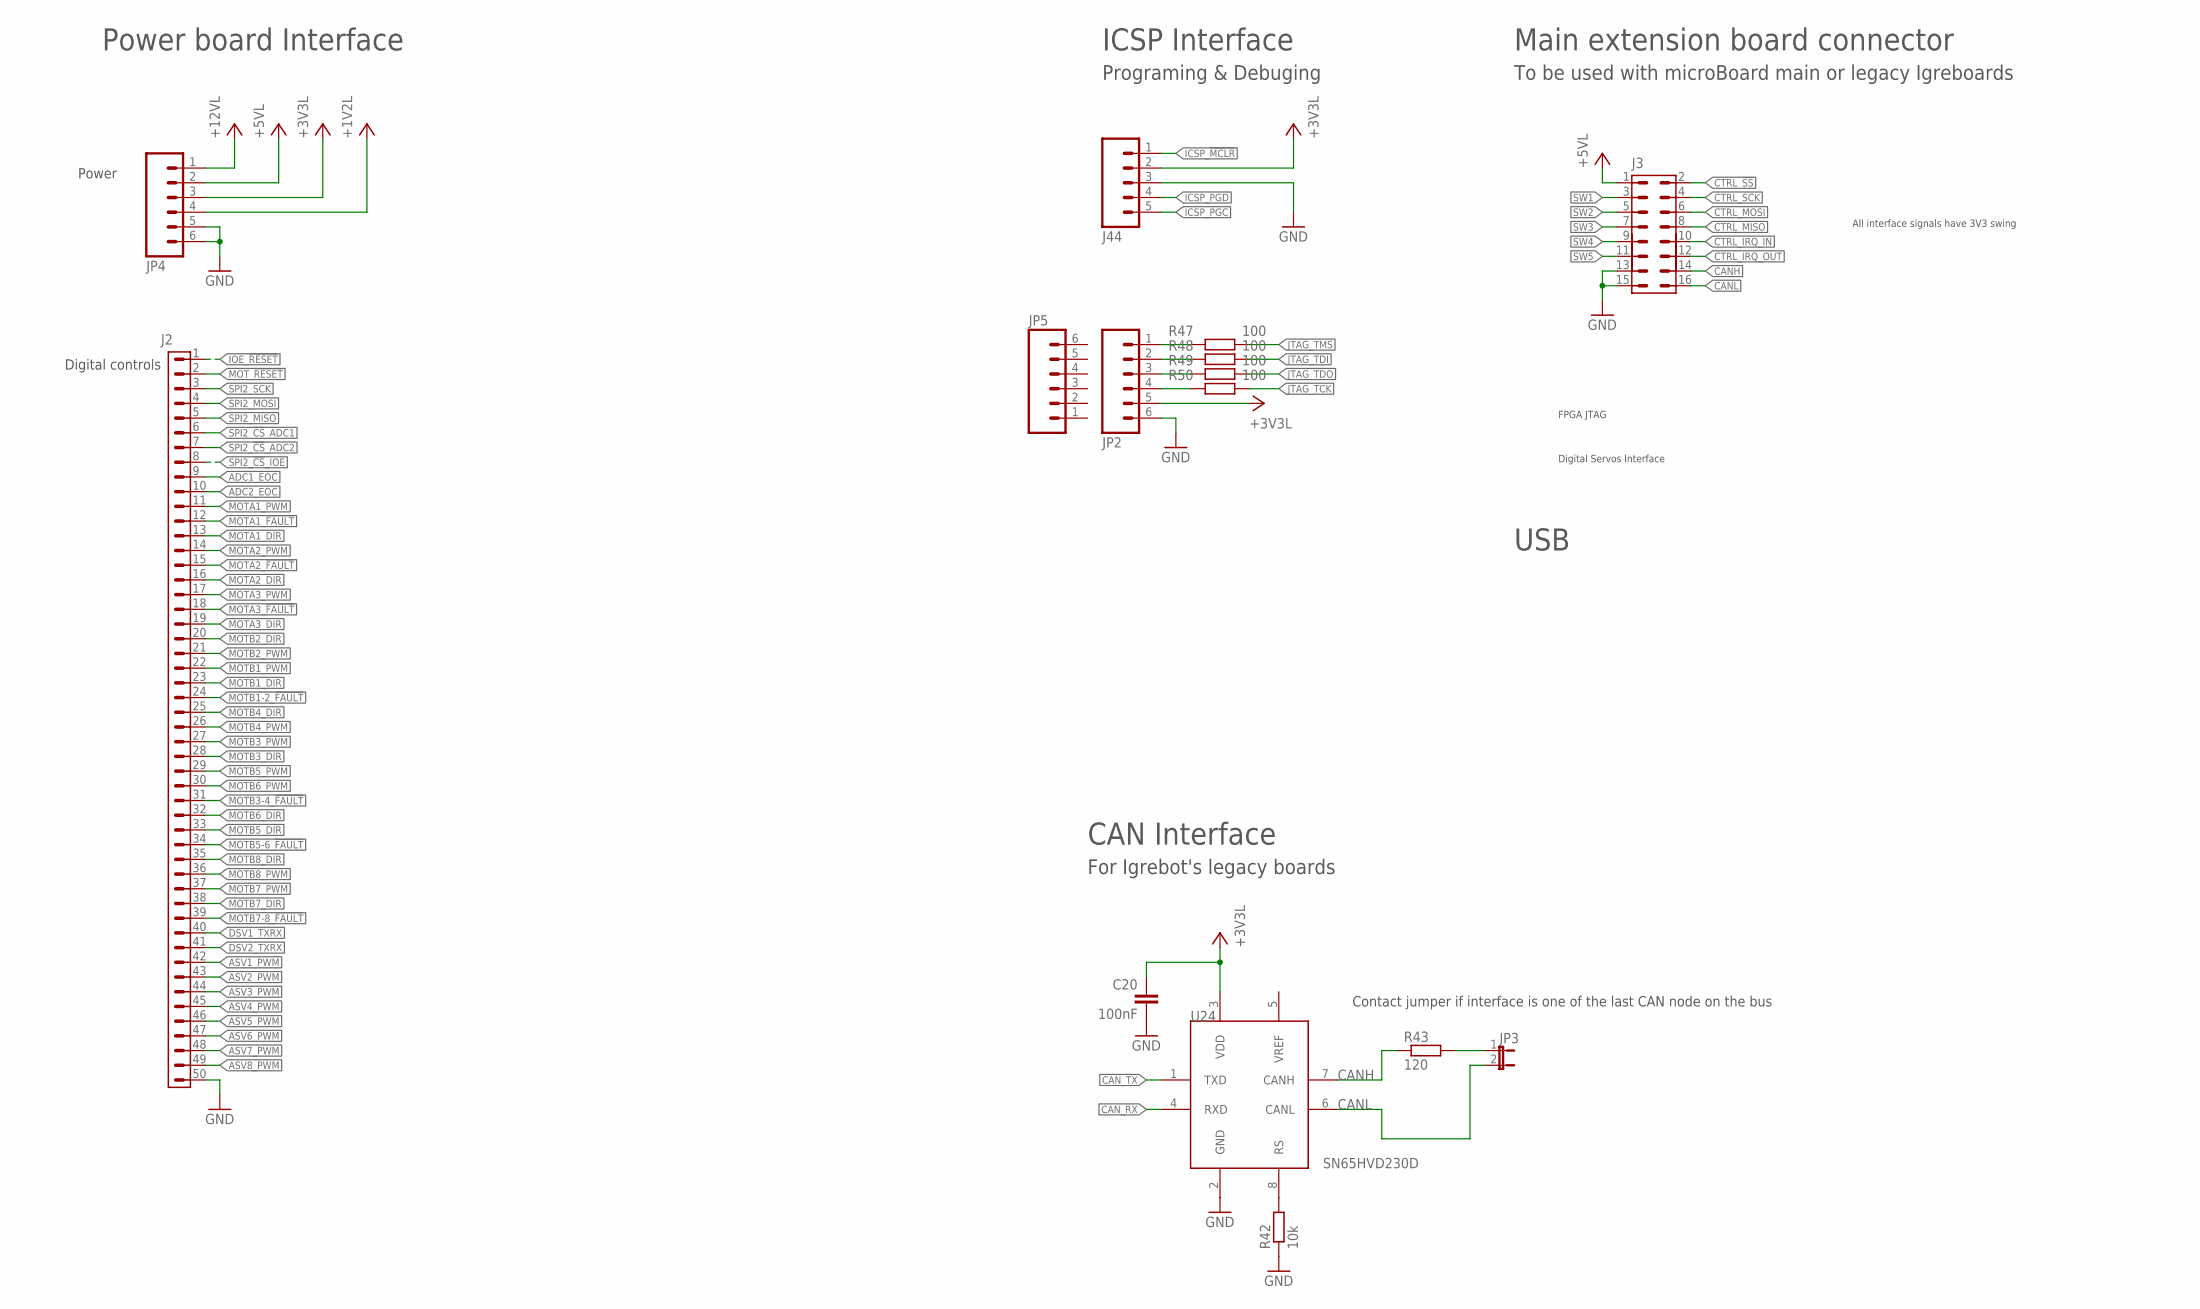
[picture p49: schematic microBoard_main.sch, sheet 7, Power, HMI & Other Interfaces]

Parts:
C20: 100nF; C0603
J2: FFC-0.5_50; FFC-SMD-0.5_50
J3: HE10_H_16; CON_2X_2.54_H_16
J44: M05LOCK; 1X05_LOCK
JP2, JP4: M06LOCK; 1X06_LOCK
JP3: JUMPER-2PTH_LOCK; 1X02_LOCK
JP5: M06SMD-1MM; 1X06-1MM
R42: 10k; R0603
R43: 120; R0603
R47, R48, R49, R50: 100; R0603
U24: SN65HVD230D; SO-08

Connections:
+1V2L: JP4.4; also elsewhere on the board
+3V3L: C20.1, J44.2, JP2.5, JP4.3, U24.3 (VDD); also elsewhere on the board
+5VL: J3.1, JP4.2; also elsewhere on the board
+12VL: JP4.1; also elsewhere on the board
ADC1_EOC: J2.9
ADC2_EOC: J2.10
ASV1_PWM: J2.42
ASV2_PWM: J2.43
ASV3_PWM: J2.44
ASV4_PWM: J2.45
ASV5_PWM: J2.46
ASV6_PWM: J2.47
ASV7_PWM: J2.48
ASV8_PWM: J2.49
CANH: J3.14, R43.1, U24.7 (CANH)
CANL: J3.16, JP3.2, U24.6 (CANL)
CAN_RX: U24.4 (RXD)
CAN_TX: U24.1 (TXD)
CTRL_!SS!: J3.2
CTRL_IRQ_IN: J3.10
CTRL_IRQ_OUT: J3.12
CTRL_MISO: J3.8
CTRL_MOSI: J3.6
CTRL_SCK: J3.4
DSV1_TXRX: J2.40
DSV2_TXRX: J2.41
GND: C20.2, J2.50, J3.13, J3.15, J44.3, JP2.6, JP4.5, JP4.6, R42.1, U24.2 (GND); also elsewhere on the board
ICSP_!MCLR!: J44.1; also elsewhere on the board
ICSP_PGC: J44.5; also elsewhere on the board
ICSP_PGD: J44.4; also elsewhere on the board
IOE_!RESET!: J2.1
JTAG_TCK: R50.2; also elsewhere on the board
JTAG_TDI: R48.2; also elsewhere on the board
JTAG_TDO: R49.2; also elsewhere on the board
JTAG_TMS: R47.2; also elsewhere on the board
MOTA1_!FAULT!: J2.12
MOTA1_DIR: J2.13
MOTA1_PWM: J2.11
MOTA2_!FAULT!: J2.15
MOTA2_DIR: J2.16
MOTA2_PWM: J2.14
MOTA3_!FAULT!: J2.18
MOTA3_DIR: J2.19
MOTA3_PWM: J2.17
MOTB1-2_!FAULT!: J2.24
MOTB1_DIR: J2.23
MOTB1_PWM: J2.22
MOTB2_DIR: J2.20
MOTB2_PWM: J2.21
MOTB3-4_!FAULT!: J2.31
MOTB3_DIR: J2.28
MOTB3_PWM: J2.27
MOTB4_DIR: J2.25
MOTB4_PWM: J2.26
MOTB5-6_!FAULT!: J2.34
MOTB5_DIR: J2.33
MOTB5_PWM: J2.29
MOTB6_DIR: J2.32
MOTB6_PWM: J2.30
MOTB7-8_!FAULT!: J2.39
MOTB7_DIR: J2.38
MOTB7_PWM: J2.37
MOTB8_DIR: J2.35
MOTB8_PWM: J2.36
MOT_!RESET!: J2.2
unnamed: R42.2, U24.8 (RS)
unnamed: JP3.1, R43.2
unnamed: JP2.2, R48.1
unnamed: JP2.1, R47.1
unnamed: JP2.3, R49.1
unnamed: JP2.4, R50.1
SPI2_!CS!_ADC1: J2.6
SPI2_!CS!_ADC2: J2.7
SPI2_!CS!_IOE: J2.8
SPI2_MISO: J2.5
SPI2_MOSI: J2.4
SPI2_SCK: J2.3
SW1: J3.3
SW2: J3.5
SW3: J3.7
SW4: J3.9
SW5: J3.11

Notes on the sheet:
Power
Digital controls
FPGA JTAG
Digital Servos Interface
To be used with microBoard main or legacy Igreboards
Main extension board connector
All interface signals have 3V3 swing
Programing & Debuging
ICSP Interface
For Igrebot's legacy boards
CAN Interface
Contact jumper if interface is one of the last CAN node on the bus
Power board Interface
USB

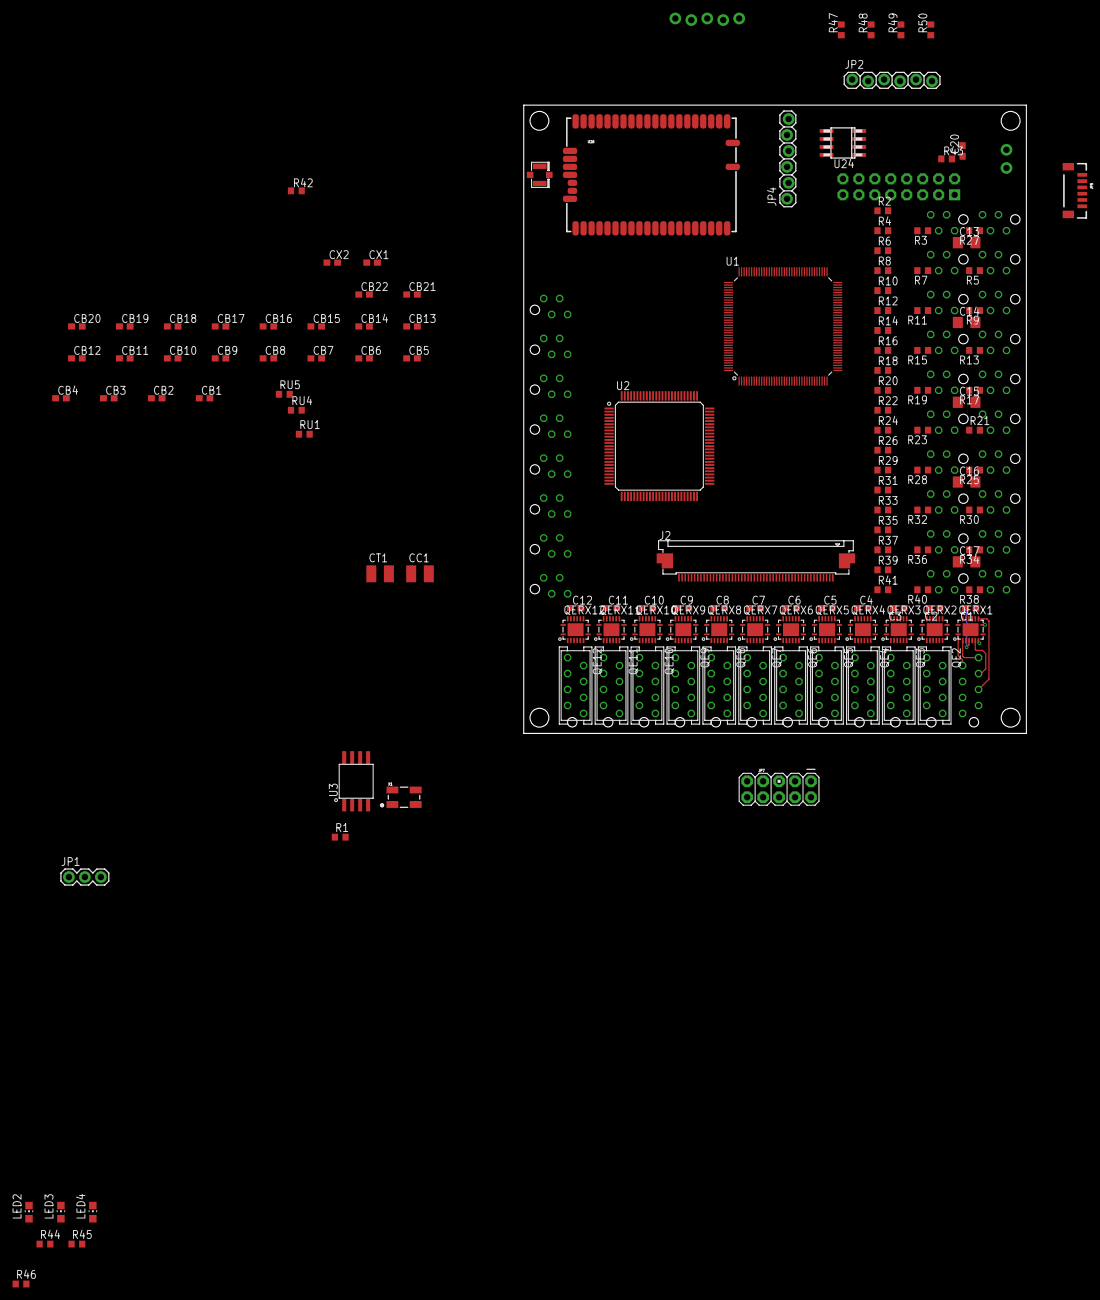
[picture p50: board microBoard_main.brd from above]

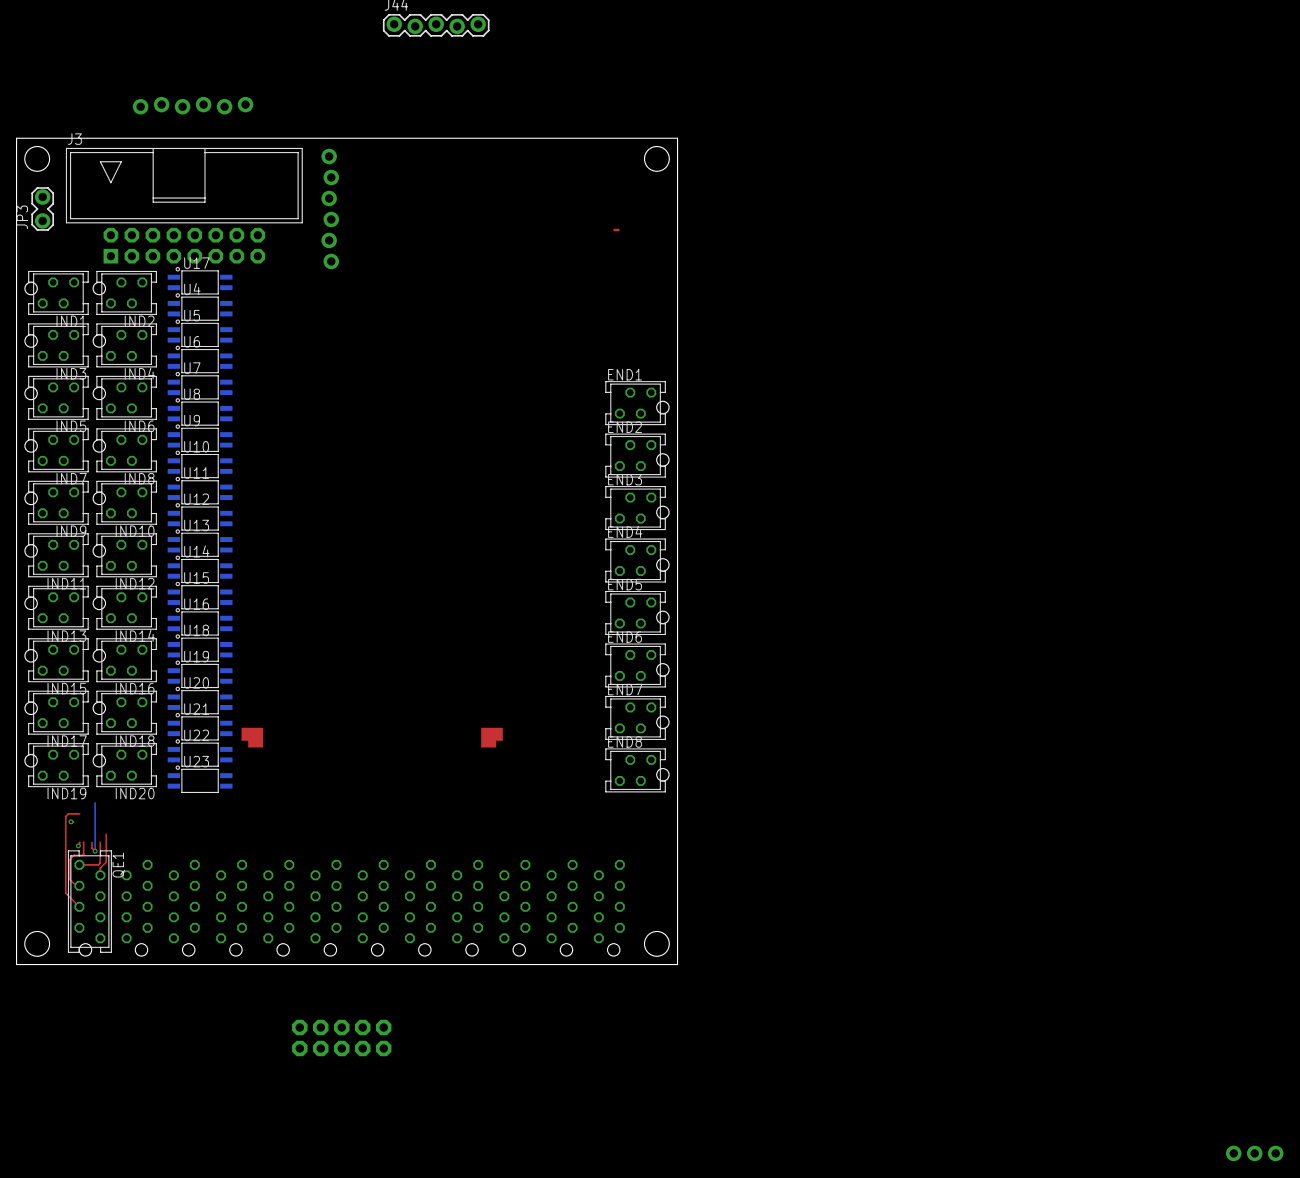
[picture p51: board microBoard_main.brd from below]

Board: 4 copper layers, 80.0 x 100.0 mm, 188 parts (52 on the bottom side), 194 nets.
